SonJonsr/Custom-8bit-CPU/README.md

"# Custom-8bit-CPU" 
"# Custom-8bit-CPU"
