SonJonsr/Custom-8bit-CPU/Forstudie/forstudie.odt

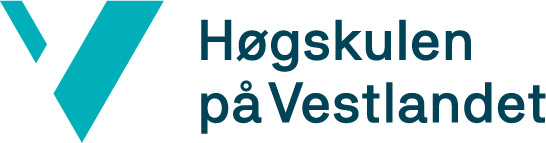
[picture p1: figure]
HVL_logo

Forstudie

<Gruppemedlem #1>

<Gruppemedlem #2>

30. jan.. 2026

# Dokumentkontroll

Rapportens tittel: Forprosjektrapport for ELNIKK-07, Selvlagd 8-Bit cpu med FPGA-lagd skjermkort og hovedkort | Dato/Versjon <Dato> / <Versjon>
| Rapportnummer: B021E-XX
Forfatter(e): <Forfatter navn 1> <Forfatter navn 2> | Studieretning: Elektronikk
| Antall sider m/vedlegg 17
Høgskolens veileder: Endre Håland | Gradering: <Åpen>
Eventuelle Merknader: Vi tillater at oppgaven kan publiseres.

Oppdragsgiver: Selvvalgt | Oppdragsgivers referanse: 42069
Oppdragsgivers kontaktperson(er) (inklusiv kontaktinformasjon): Sondre Johnsen og Jacob Kvasnes

Revisjon | Dato | Status | Utført av
0.1 | xx.yy.2026 | <Hva som er gjort i forhold til mal> | <Navn>
1.0 | xx.yy.2026 | <Vesentlig endring = nytt hovednummer> | <Navn>
1.1 | xx.yy.2026 | <Mindre endring = nytt undernummer> | <Navn>
1.2 | xx.yy.2026 | <Kort beskrivelse av hva som er endret> | <Navn>

# Innledning

## Organisering av rapporten

(om det føles nødvendig å ha med)

## Oppdragsgiver

Selvvalgt. Sondre ville lage en 8-bit CPU alene. Det han fikk han ikke lov til. Jacob syntes synd på Sondre, og nå er vi her. (Jacob ville fpga)

## Problemstilling

Hovedformål med oppgaven er å opparbeide erfaring rundt hvordan datamaskiner fungerer.

Forskning og utviklings oppgave. Designe en egen 8-bit cpu med tilhørende ekosystem slik at man kan lage en datamaskin

Vi ønsker å lage et produkt som kan hjelpe andre med å få forståelse for hvordan en datamaskin funker fra tastetrykk

Beskriv oppdragsgivers problemstilling og bakgrunnen for denne. Det er her også viktig å få med eventuelle utenforliggende faktorer som kan påvirke mulige løsningsforslag, samt eksisterende applikasjoner og nettverk som søkte løsningsforslag må forholde seg til.

Lag gjerne enkle skisser for å vise prosjektets plass i virksomheten det skal inn i. Ta ikke med teknisk omtale av detaljer i den ferdige løsningen her.

I designoppgaver kan dere gjerne tenke på resultatet som en ”svart boks”. Da må dere prøve å la leseren få et inntrykk hva som grovt sett skal sendes inn i boksen, hva som skal komme ut av boksen, og hvilke omgivelser denne boksen er plassert i. I oppgaver som retter seg mest mot nettverksplanlegging, nettverksoppbygging og analyse av driftssituasjoner, må dere kanskje skissere rom- og personellsituasjon, eventuelt eksisterende datanettverk e.l.

## Hovedidé for løsningsforslag

Hovedidé for oppgaven er å ha en fungerende 8-bit datamaskin med noen programmer.

### CPU

Lage en selvlagd 8-bit CPU med FPGA. Lage en fysisk verson av den selvlagde FPGA 8-bit CPU-en med transistorer.

### Hovedkort

Lage et hovedkort som kommuniserer med en skjerm, et tastatur, en minnemodulen og den selvlagde 8-bit CPU-en.

### Compilator

Lage en kompilator for kode som ligner på C:

### Programvare

Lage en terminal med et «Wozmon» lignende program.

Lage «Pong».

Lage «Snake».

Lage «Tetris».

# Kravspesifikasjon

## CPU

Cpu krav:

- 8-bit
- 16-bit addresse kart
- Eget definert instruksjonsett

Pin assignment

- 8-bit data -inn/-ut
- 16-bit add
- clk
- rst_n
- GND
- 5V

## Hovedkort

Alt som kobles til hovedkort som ikke er CPU-en skal løses med en FPGA.

### VGA-skjerm

- 480x640p oppløsning
- 60 Hz

### Tastatur

- Enten USB eller PS/2

### 64kiB Minnedel

- 2 leselinjer
- 2 skrivelinjer
- Støtte for en 50MHz klokke.

Lage et hovedkort som kommuniserer med en VGA-skjerm, et PS/2-tastatur, en 64kiB minnemodulen og den selvlagde 8-bit CPU-en.

## Compilator

Lage en kompilator for kode som ligner på C:

Stack og heap:

Stack blir løst med programnvare. Heap er ikke med.

Vaiabler

8-bit (char / int8_t)

16-bit (int16_t)

8-bit arrays

16-bit arrays

funksjoner:

Addisjon, subtraksjon, multiplikasjon, divisjon

metoder:

def

løkker:

for, while, foreach, dowhile

IO:

## Programvare

Lage en terminal med et «Wozmon» lignende program.

Lage «Pong».

Lage «Snake».

Lage «Tetris».

Dette er oppdragsgivers krav til hvordan løsningen skal fungere og hvordan den eventuelt skal integreres med øvrige applikasjoner i virksomheten. Kravspesifikasjonen må formuleres i oppdragsgivers språk (dvs. vanlig norsk uten for mange teknisk formuleringer som går direkte på løsningen) slik at oppdragsgiver og dennes brukere lett kan se at dere har oppfattet problemet. Det er viktig å ikke blande sammen kravspesifikasjonen med den tekniske dokumentasjonen som på en faglig presis måte beskriver hvordan det ferdige programsystemet, nettverket etc. er konstruert og skal fungere.

Kravspesifikasjonen skal drøftes med oppdragsgiver. Dette er et av hovedformålene med forprosjektet. I enkelte tilfeller kan det være nødvendig å dokumentere slike drøftinger og vurderinger i rapporten slik at en får fram oppdragsgivers motivasjon og begrunnelse. Hvis oppdragsgiver endrer kravspesifikasjonen underveis, bør dette komme fram i rapporten.

Kravspesifikasjonen skal ende opp med et klart definert mål for hva som skal utføres i løpet av hovedprosjektperioden. I samråd med oppdragsgiver og faglig kontaktperson ved høgskolen skal en sikre at kravspesifikasjonen definerer mål om endelige etterprøvbare løsninger (prototype med klare avgrensninger, ferdig testet applikasjon, integrasjon og tilpasning av eksisterende løsninger, etc.) som kan la seg løse innen rammene (arbeidsmengde, faglige utfordringer og tilgjengelige ressurser) for et hovedprosjekt. Med etterprøvbare løsninger menes det at en i ettertid skal kunne evaluere hvorvidt prosjektets resultat er i samsvar med kravspesifikasjonen.

Kravspesifikasjonen kan med fordel gis punktvis og gjerne kategorisert i en eller annen naturlig form.

# Analyse av problemet

Analysen binder sammen kravspesifikasjon og utforming.

Med utgangspunkt i kravspesifikasjonen skal en foreta en grundigere analyse for hva systemet skal utføre. En må gjerne dele opp systemet i undersystemer som hver får sine kravspesifikasjoner. Som oftest må en gå tilbake til oppdragsgiver og dennes kontaktpersoner for å få presisert detaljer i krav og ønsker, og for å finne ut av hvilke muligheter og egenskaper som ligger i de eksisterende systemløsninger.

Sagt på en annen måte så skal en under analysen foreta en dekomponering av kravene gitt i kravspesifikasjonen. Analysen skal ende opp i en detaljert og delvis generell beskrivelse av kravspesifikasjonen (med mindre oppdragsgiver har gitt spesifikke krav for bruk av verktøy og plattform). En god analyse vil gi et godt utgangspunkt for designfasen.

## Utforming av mulige løsninger

### CPU

Lage en selvlagd 8-bit CPU med FPGA. Lage en fysisk verson av den selvlagde FPGA 8-bit CPU-en med transistorer.

### Hovedkort

Lage et hovedkort som kommuniserer med en VGA-skjerm, et PS/2-tastatur, en 64kiB minnemodulen og den selvlagde 8-bit CPU-en.

### Compilator

Lage en kompilator for kode som ligner på C.

### Programvare

Lage en terminal med et «Wozmon» lignende program.

Lage «Pong».

Lage «Snake».

Lage «Tetris».

Her beskrives mulige utforminger av løsning(er) på problemet. Det kan f.eks. omfatte nødvendig kjøp og installasjon av maskinvare og programvare, utvikling av spesialtilpasset programvare, organisering av driften, brukeropplæring, dokumentasjon av system og arbeidsrutiner, etc. Dersom oppdragsgiver har lagt spesielle rammer for løsningen, presiseres dette.

Om mulig så bør en beskrive flere reelle løsningsalternativer:

### Løsningsalternativ 1

### Løsningsalternativ 2

### Vurderinger i forhold til verktøy og HW/SW komponenter

Her kan det skrives (kort) om aktuelle verktøy som dere har vurdert som aktuelle for oppgaven. Grunngi de endelige valgene av verktøy. Tidligere kunnskaper om og brukererfaring med verktøyet og beregnet tid for opplæring må også tas med i vurderingen. Dersom oppdragsgiver har gitt spesielle rammer for løsningen, så bør en her i stedet diskutere fortrinn og ulemper med de valg som er gjort vurdert opp mot andre verktøy/plattformer som kunne gitt tilsvarende gode eller eventuelt bedre løsninger.

Dersom en har flere reelle valgmuligheter for alt eller noe av verktøyet, kan en gjerne framstille alternativene med underpunkter som i kapitlet over.

## Konklusjon

Drøft valg av det beste løsningsalternativet og begrunnelser for dette.

# Referanser

Her tar dere med litteratur som er brukt under arbeidet. Det kan være lærebøker fra aktuelle fag på skolen, annen støttelitteratur, håndbøker for maskinutstyr eller programvarer, websteder dere har benyttet etc. Når det gjelder websider, så bør dette dateres. Litteraturlisten skal være ryddig og systematisk satt opp, og alle referanser skal også refereres til i teksten.

Eksempelet viser bruk av den interne litteraturlisten til Word, og det anbefales å benytte denne. Andre gode verktøy sammen med Word er f. eks. Endnote.

Tips til hvordan du setter opp litteraturliste finner du på [1]

[1] | HiB, UiB, NHH, UiO og Nasjonalbiblioteket, «Søk og Skriv,» 12 12 2014. [Internett]. Available: http://sokogskriv.no/. [Funnet 12 12 2014].

###### Forkortelser og ordforklaringer

Her skal relevante forkortelser og ordforklaringer komme i alfabetisk rekkefølge. Husk at forklaring på forkortelser tas med i dokumentet første gang en forkortelse brukes, eks: Orthogonal Frequency Division Multiplexing (OFDM).

OFDM | Orthogonal Frequency Division Multiplexing

###### Prosjektledelse og styring

Aktiviteter som har med prosjektgjennomføringen å gjøre passer kanskje ikke så godt å beskrive i de andre kapitlene. Det kan likevel være greit å si noe om hvordan prosjektet er gjennomført. Dette kan gjøres her.

###### Prosjektorganisasjon

Hvordan er arbeidet fordelt innad i gruppen? Hvem er prosjektleder?

###### Prosjektform

Hvis relevant, presenter den prosjektmetoden (UP, XP, Scrum, egendefinert, ...) som dere har valgt for prosjektet, og gi en kort begrunnelse for dette valget. Fortell også hvordan forprosjektet inngår i det hele.

###### Fremdriftsplan

Ta med den initielle fremdriftsplanen, og evt. også senere versjoner dersom det ble foretatt vesentlige endringer underveis. Alternativt kan initiell og endelig fremdriftsplan beskrives i felles diagram.

###### Risikoliste

Gjerne i tabellform (kort, konkret og oversiktlig).

###### Brukerdokumentasjon

Tas med dersom dette var et krav i prosjektet.

###### Brukerdokumentasjon

Hva systemet kan gjøre beskrives på en kort og enkel måte. For hver funksjon vises bruksmåte, eventuelle begrensninger og krav til inndata, etc. Der det er aktuelt viser dere til hjelpefunksjoner som ligger innebygd i systemet.

###### Drifts- og vedlikeholdsdokumentasjon

Beskriv hvordan systemet installeres og startes opp, nødvendige datafiler og andre systemkomponenter som kreves i en driftssituasjon, krav til maskinutstyr, nettverk, m.m.

###### Øvrige diagrammer

Dersom det ikke er naturlig at disse inngår i hoveddelen av rapporten.

###### Kildekode, skjemadesign, Bill Of Materials mm

Normalt holder det at denne informasjonen legges ved i zip-filen, men i spesielle tilfeller kan det være ønskelig at hele eller deler av arbeidet (dersom dette ikke blir så alt for mange sider) legges ved i utskrifts form. Diskuter dette med veileder.

Rediger overskriften alt etter som hva som er relevant å ta med her.

###### Annet?

ELNIKK-07, Selvlagd 8-Bit cpu med FPGA-lagd skjermkort og hovedkort

Rev: 0.16 side 7 av 17 15.01.2026
