SonJonsr/Custom-8bit-CPU/FPGA_ROT/PS2_testbenk/ps2_code_overview.png

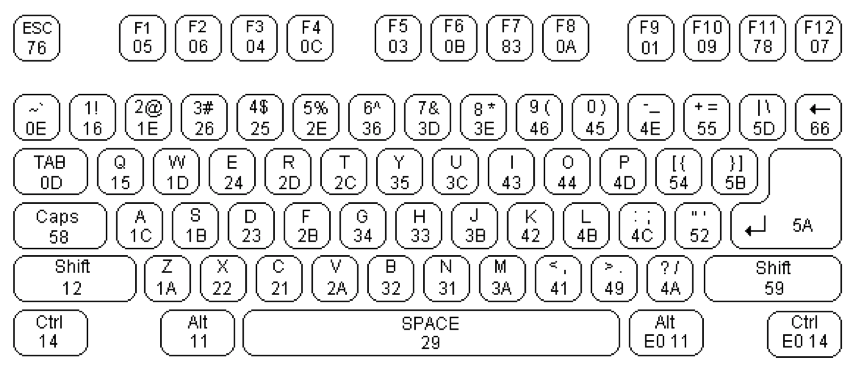
FPGA_ROT/PS2_testbenk/ps2_code_overview.png
