SonJonsr/Custom-8bit-CPU/PCB_S/REG8bit-SMD-V5.0/jlcpcb/production_files/BOM-REG8bit-SMD-V5.0.csv

Comment | Designator | Footprint | LCSC | Quantity
10kΩ | R1,R10,R11,R12,R13,R14,R15,R16,R17,R18,R19,R2,R20,R21,R22,R23,R24,R25,R26,R27,R28,R29,R3,R30,R31,R32,R33,R34,R35,R36,R37,R38,R39,R4,R40,R41,R42,R43,R44,R45,R46,R5,R6,R7,R8,R9 | R_0402 | C25744 | 46
22uF | C1,C2,C3,C4 | C_0805 | C45783 | 4
2N7002 | Q1,Q10,Q11,Q12,Q13,Q14,Q15,Q16,Q17,Q19,Q2,Q20,Q21,Q22,Q23,Q24,Q25,Q27,Q29,Q3,Q30,Q31,Q32,Q33,Q34,Q35,Q37,Q39,Q4,Q40,Q41,Q42,Q43,Q44,Q45,Q47,Q49,Q5,Q50,Q51,Q52,Q53,Q54,Q55,Q57,Q59,Q6,Q60,Q61,Q62,Q63,Q64,Q65,Q67,Q69,Q7,Q70,Q71,Q72,Q73,Q74,Q75,Q77,Q79,Q8,Q80,Q81,Q82,Q83,Q84,Q85,Q86,Q87,Q88,Q89,Q9 | SOT-23 | C8545 | 76
Red | D1,D10,D2,D3,D4,D5,D6,D7,D8,D9 | D_0603 | C2286 | 10
Conn_01x21_Pin | J1 | PinHeader_1x21_P2.54mm_Horizontal |  | 1
