SonJonsr/Custom-8bit-CPU/(list of files, cad)

Other CAD files:
Compile/test.obj
CPU_Bachelor_2_0/db/stp1_auto_stripped.stp
CPU_Bachelor_2_0/stp1.stp
CPU_Bachlor_1_0/db/stp1_auto_stripped.stp
FPGA_ROT/motherboard_ver_1/db/stp1_auto_stripped.stp
FPGA_ROT/motherboard_ver_1/output_files/stp1.stp
FPGA_ROT/vga_test_av_testbrett/db/stp1_auto_stripped.stp
FPGA_ROT/vga_test_av_testbrett/output_files/stp1.stp
Compile/Simple_C_output.obj
