SonJonsr/Custom-8bit-CPU/FPGA_ROT/register_testbenk_mcu/unsaved/unsaved.html

unsaved

2026.03.19.18:14:07 | Datasheet

Overview

clk_0 | unsaved

Processor
thinker Abbotts Lake 26.0.0
All Components
jtag altera_avalon_jtag_uart 24.1
ram altera_avalon_onchip_memory2 24.1
reg_test_comp register_testbenk_component 1.0
thinker intel_niosv_m 26.0.0

Memory Map

| jtag

avalon_jtag_slave

ram

s1

reg_test_comp

avalon_slave_0

thinker

timer_sw_agent

dm_agent

## clk_0

clock_source v24.1

Parameters

clockFrequency | 50000000
clockFrequencyKnown | true
inputClockFrequency | 0
resetSynchronousEdges | NONE
deviceFamily | UNKNOWN
generateLegacySim | false

Software Assignments
(none)

## jtag

altera_avalon_jtag_uart v24.1

thinker | data_manager | jtag
| avalon_jtag_slave
| instruction_manager
| avalon_jtag_slave
| platform_irq_rx
| irq
clk_0 | clk
| clk
| clk_reset
| reset

Parameters

allowMultipleConnections | false
hubInstanceID | 0
readBufferDepth | 64
readIRQThreshold | 8
simInputCharacterStream
simInteractiveOptions | NO_INTERACTIVE_WINDOWS
useRegistersForReadBuffer | false
useRegistersForWriteBuffer | false
useRelativePathForSimFile | false
writeBufferDepth | 64
writeIRQThreshold | 8
printingMethod | false
FIFO_WIDTH | 8
WR_WIDTHU | 6
RD_WIDTHU | 6
write_le | ON
read_le | ON
HEX_WRITE_DEPTH_STR | 64
HEX_READ_DEPTH_STR | 64
clkFreq | 50000000
avalonSpec | 2.0
legacySignalAllow | false
enableInteractiveInput | false
enableInteractiveOutput | false
deviceFamily | UNKNOWN
generateLegacySim | false

Software Assignments

READ_DEPTH | 64
READ_THRESHOLD | 8
WRITE_DEPTH | 64
WRITE_THRESHOLD | 8

## ram

altera_avalon_onchip_memory2 v24.1

thinker | data_manager | ram
| s1
| instruction_manager
| s1
clk_0 | clk
| clk1
| clk_reset
| reset1

Parameters

allowInSystemMemoryContentEditor | false
blockType | AUTO
dataWidth | 32
dataWidth2 | 32
dualPort | false
enableDiffWidth | false
derived_enableDiffWidth | false
initMemContent | true
initializationFileName | onchip_mem.hex
enPRInitMode | false
instanceID | NONE
memorySize | 262144
readDuringWriteMode | DONT_CARE
simAllowMRAMContentsFile | false
simMemInitOnlyFilename | 0
singleClockOperation | false
derived_singleClockOperation | false
slave1Latency | 1
slave2Latency | 1
useNonDefaultInitFile | false
copyInitFile | false
useShallowMemBlocks | false
writable | true
ecc_enabled | false
resetrequest_enabled | true
autoInitializationFileName | unsaved_ram
deviceFamily | CYCLONEIVE

deviceFeatures

COMPILER_SUPPORT 1 CELL_LEVEL_BACK_ANNOTATION_DISABLED 0 ANY_QFP 0 ADDRESS_STALL 1 ADVANCED_INFO 0 ALLOWS_COMPILING_OTHER_FAMILY_IP 1 GENERATE_DC_ON_CURRENT_WARNING_FOR_INTERNAL_CLAMPING_DIODE 0 DSP 0 DSP_SHIFTER_BLOCK 0 DUMP_ASM_LAB_BITS_FOR_POWER 1 EMUL 1 ENABLE_ADVANCED_IO_ANALYSIS_GUI_FEATURES 1 ENABLE_PIN_PLANNER 0 ENGINEERING_SAMPLE 0 EPCS 1 ESB 0 FAKE1 0 FAKE2 0 FAKE3 0 FAMILY_LEVEL_INSTALLATION_ONLY 1 FASTEST 0 FINAL_TIMING_MODEL 0 FITTER_USE_FALLING_EDGE_DELAY 0 FPP_COMPLETELY_PLACES_AND_ROUTES_PERIPHERY 0 HARDCOPY 0 HAS_MICROPROCESSOR 0 HAS_MIF_SMART_COMPILE_SUPPORT 1 HAS_MINMAX_TIMING_MODELING_SUPPORT 1 HAS_MIN_TIMING_ANALYSIS_SUPPORT 1 HAS_MUX_RESTRUCTURE_SUPPORT 1 HAS_NADDER_STYLE_CLOCKING 0 HAS_NADDER_STYLE_FF 0 HAS_NADDER_STYLE_LCELL_COMB 0 HAS_NEW_CDB_NAME_FOR_M20K_SCLR 0 HAS_NEW_HC_FLOW_SUPPORT 0 HAS_NEW_SERDES_MAX_RESOURCE_COUNT_REPORTING_SUPPORT 1 HAS_NEW_VPR_SUPPORT 1 HAS_NONSOCKET_TECHNOLOGY_MIGRATION_SUPPORT 0 HAS_NO_HARDBLOCK_PARTITION_SUPPORT 0 HAS_NO_JTAG_USERCODE_SUPPORT 0 HAS_OPERATING_SETTINGS_AND_CONDITIONS_REPORTING_SUPPORT 1 HAS_ACE_SUPPORT 1 HAS_ACTIVE_PARALLEL_FLASH_SUPPORT 0 HAS_ADJUSTABLE_OUTPUT_IO_TIMING_MEAS_POINT 0 HAS_ADVANCED_IO_INVERTED_CORNER 0 HAS_ADVANCED_IO_POWER_SUPPORT 1 HAS_ADVANCED_IO_TIMING_SUPPORT 1 HAS_ALM_SUPPORT 0 HAS_ATOM_AND_ROUTING_POWER_MODELED_TOGETHER 0 HAS_AUTO_DERIVE_CLOCK_UNCERTAINTY_SUPPORT 0 HAS_AUTO_FIT_SUPPORT 1 HAS_BALANCED_OPT_TECHNIQUE_SUPPORT 1 HAS_BENEFICIAL_SKEW_SUPPORT 1 HAS_BITLEVEL_DRIVE_STRENGTH_CONTROL 1 HAS_BSDL_FILE_GENERATION 1 HAS_CDB_RE_NETWORK_PRESERVATION_SUPPORT 0 HAS_CGA_SUPPORT 1 HAS_CHECK_NETLIST_SUPPORT 0 HAS_CLOCK_REGION_CHECKER_ENABLED 1 HAS_CORE_JUNCTION_TEMP_DERATING 0 HAS_CROSSTALK_SUPPORT 0 HAS_CUSTOM_REGION_SUPPORT 1 HAS_DAP_JTAG_FROM_HPS 0 HAS_DATA_DRIVEN_ACVQ_HSSI_SUPPORT 0 HAS_DDB_FDI_SUPPORT 0 HAS_DESIGN_ANALYZER_SUPPORT 1 HAS_DETAILED_IO_RAIL_POWER_MODEL 1 HAS_DETAILED_LEIM_STATIC_POWER_MODEL 1 HAS_DETAILED_LE_POWER_MODEL 1 HAS_DETAILED_ROUTING_MUX_STATIC_POWER_MODEL 1 HAS_DETAILED_THERMAL_CIRCUIT_PARAMETER_SUPPORT 1 HAS_DEVICE_MIGRATION_SUPPORT 1 HAS_DIAGONAL_MIGRATION_SUPPORT 0 HAS_EMIF_TOOLKIT_SUPPORT 0 HAS_ERROR_DETECTION_SUPPORT 0 HAS_FAMILY_VARIANT_MIGRATION_SUPPORT 0 HAS_FANOUT_FREE_NODE_SUPPORT 1 HAS_FAST_FIT_SUPPORT 1 HAS_FIT_NETLIST_OPT_RETIME_SUPPORT 1 HAS_FIT_NETLIST_OPT_SUPPORT 1 HAS_FITTER_ECO_SUPPORT 1 HAS_FORMAL_VERIFICATION_SUPPORT 1 HAS_FPGA_XCHANGE_SUPPORT 1 HAS_FSAC_LUTRAM_REGISTER_PACKING_SUPPORT 0 HAS_FULL_DAT_MIN_TIMING_SUPPORT 1 HAS_FULL_INCREMENTAL_DESIGN_SUPPORT 1 HAS_FUNCTIONAL_SIMULATION_SUPPORT 1 HAS_FUNCTIONAL_VERILOG_SIMULATION_SUPPORT 0 HAS_FUNCTIONAL_VHDL_SIMULATION_SUPPORT 0 HAS_GLITCH_FILTERING_SUPPORT 1 HAS_HARDCOPYII_SUPPORT 0 HAS_HC_READY_SUPPORT 0 HAS_HIGH_SPEED_LOW_POWER_TILE_SUPPORT 0 HAS_HOLD_TIME_AVOIDANCE_ACROSS_CLOCK_SPINE_SUPPORT 1 HAS_HSSI_POWER_CALCULATOR 0 HAS_HSPICE_WRITER_SUPPORT 1 HAS_IBISO_WRITER_SUPPORT 0 HAS_ICD_DATA_IP 0 HAS_IDB_SUPPORT 1 HAS_INCREMENTAL_DAT_SUPPORT 1 HAS_INCREMENTAL_SYNTHESIS_SUPPORT 1 HAS_IO_ASSIGNMENT_ANALYSIS_SUPPORT 1 HAS_IO_DECODER 0 HAS_IO_PLACEMENT_OPTIMIZATION_SUPPORT 1 HAS_IO_PLACEMENT_USING_GEOMETRY_RULE 0 HAS_IO_PLACEMENT_USING_PHYSIC_RULE 0 HAS_IO_SMART_RECOMPILE_SUPPORT 0 HAS_JITTER_SUPPORT 1 HAS_JTAG_SLD_HUB_SUPPORT 1 HAS_LOGIC_LOCK_SUPPORT 1 HAS_PAD_LOCATION_ASSIGNMENT_SUPPORT 0 HAS_PASSIVE_PARALLEL_SUPPORT 0 HAS_PARTIAL_RECONFIG_SUPPORT 0 HAS_PDN_MODEL_STATUS 0 HAS_PHYSICAL_NETLIST_OUTPUT 0 HAS_PHYSICAL_DESIGN_PLANNER_SUPPORT 0 HAS_PHYSICAL_ROUTING_SUPPORT 0 HAS_PIN_SPECIFIC_VOLTAGE_SUPPORT 1 HAS_PLDM_REF_SUPPORT 1 HAS_POWER_BINNING_LIMITS_DATA 0 HAS_POWER_ESTIMATION_SUPPORT 1 HAS_PRELIMINARY_CLOCK_UNCERTAINTY_NUMBERS 0 HAS_PRE_FITTER_FPP_SUPPORT 0 HAS_PRE_FITTER_LUTRAM_NETLIST_CHECKER_ENABLED 0 HAS_PVA_SUPPORT 1 HAS_QUARTUS_HIERARCHICAL_DESIGN_SUPPORT 0 HAS_RAPID_RECOMPILE_SUPPORT 0 HAS_RCF_SUPPORT 1 HAS_RCF_SUPPORT_FOR_DEBUGGING 0 HAS_RED_BLACK_SEPARATION_SUPPORT 0 HAS_RE_LEVEL_TIMING_GRAPH_SUPPORT 1 HAS_RISEFALL_DELAY_SUPPORT 1 HAS_SIGNAL_PROBE_SUPPORT 1 HAS_SIGNAL_TAP_SUPPORT 1 HAS_SIMULATOR_SUPPORT 0 HAS_SPLIT_IO_SUPPORT 1 HAS_SPLIT_LC_SUPPORT 1 HAS_STRICT_PRESERVATION_SUPPORT 1 HAS_SYNTHESIS_ON_ATOMS 0 HAS_SYNTH_NETLIST_OPT_RETIME_SUPPORT 1 HAS_SYNTH_NETLIST_OPT_SUPPORT 1 HAS_SYNTH_FSYN_NETLIST_OPT_SUPPORT 1 HAS_TCL_FITTER_SUPPORT 0 HAS_TECHNOLOGY_MIGRATION_SUPPORT 0 HAS_TEMPLATED_REGISTER_PACKING_SUPPORT 1 HAS_TIME_BORROWING_SUPPORT 0 HAS_TIMING_DRIVEN_SYNTHESIS_SUPPORT 1 HAS_TIMING_INFO_SUPPORT 1 HAS_TIMING_OPERATING_CONDITIONS 1 HAS_TIMING_SIMULATION_SUPPORT 1 HAS_TITAN_BASED_MAC_REGISTER_PACKER_SUPPORT 0 HAS_U2B2_SUPPORT 0 HAS_USE_FITTER_INFO_SUPPORT 1 HAS_USER_HIGH_SPEED_LOW_POWER_TILE_SUPPORT 0 HAS_VCCPD_POWER_RAIL 0 HAS_VERTICAL_MIGRATION_SUPPORT 1 HAS_VIEWDRAW_SYMBOL_SUPPORT 0 HAS_VIO_SUPPORT 1 HAS_VIRTUAL_DEVICES 0 HAS_WYSIWYG_DFFEAS_SUPPORT 1 HAS_XIBISO_WRITER_SUPPORT 1 HAS_XIBISO2_WRITER_SUPPORT 0 HAS_18_BIT_MULTS 0 INCREMENTAL_DESIGN_SUPPORTS_COMPATIBLE_CONSTRAINTS 1 INSTALLED 0 INTERNAL_POF_SUPPORT_ENABLED 0 INTERNAL_USE_ONLY 0 IFP_USE_LEGACY_IO_CHECKER 0 ISSUE_MILITARY_TEMPERATURE_WARNING 0 IS_CONFIG_ROM 0 IS_BARE_DIE 0 IS_DEFAULT_FAMILY 0 IS_FOR_INTERNAL_TESTING_ONLY 0 IS_HARDCOPY_FAMILY 0 IS_HBGA_PACKAGE 0 IS_HIGH_CURRENT_PART 0 IS_JW_NEW_BINNING_PLAN 0 IS_JZ_NEW_BINNING_PLAN 0 IS_LOW_POWER_PART 0 IS_LTH_485_PIN 0 IS_SMI_PART 0 IS_SDM_ONLY_PACKAGE 0 IS_REVE_SILICON 0 LOAD_BLK_TYPE_DATA_FROM_ATOM_WYS_INFO 0 LVDS_IO 1 M144K_MEMORY 0 M10K_MEMORY 0 M20K_MEMORY 0 M4K_MEMORY 0 M512_MEMORY 0 M9K_MEMORY 1 MLAB_MEMORY 0 MRAM_MEMORY 0 NOT_MIGRATABLE 0 NOT_LISTED 0 NO_FITTER_DELAY_CACHE_GENERATED 0 NO_SUPPORT_FOR_LOGICLOCK_CONTENT_BACK_ANNOTATION 1 NO_SUPPORT_FOR_STA_CLOCK_UNCERTAINTY_CHECK 0 NO_POF 0 NO_PIN_OUT 0 NO_RPE_SUPPORT 0 NO_TDC_SUPPORT 0 SHOW_HIDDEN_FAMILY_IN_PROGRAMMER 0 STRICT_TIMING_DB_CHECKS 0 SUPPORT_HIGH_SPEED_HPS 0 SUPPORTS_1P0V_IOSTD 0 SUPPORTS_CRC 1 SUPPORTS_ADDITIONAL_OPTIONS_FOR_UNUSED_IO 0 SUPPORTS_GENERATION_OF_EARLY_POWER_ESTIMATOR_FILE 1 SUPPORTS_GLOBAL_SIGNAL_BACK_ANNOTATION 0 SUPPORTS_DIFFERENTIAL_AIOT_BOARD_TRACE_MODEL 1 SUPPORTS_DSP_BALANCING_BACK_ANNOTATION 0 SUPPORTS_HIPI_RETIMING 0 SUPPORTS_LICENSE_FREE_PARTIAL_RECONFIG 0 SUPPORTS_MAC_CHAIN_OUT_ADDER 0 SUPPORTS_NEW_BINNING_PLAN 0 SUPPORTS_SIGNALPROBE_REGISTER_PIPELINING 1 SUPPORTS_SINGLE_ENDED_AIOT_BOARD_TRACE_MODEL 1 SUPPORTS_RAM_PACKING_BACK_ANNOTATION 0 SUPPORTS_REG_PACKING_BACK_ANNOTATION 0 SUPPORTS_USER_MANUAL_LOGIC_DUPLICATION 1 SUPPORTS_VID 0 POSTMAP_BAK_DATABASE_EXPORT_ENABLED 1 POSTFIT_BAK_DATABASE_EXPORT_ENABLED 1 PROGRAMMER_ONLY 0 PROGRAMMER_SUPPORT 1 PVA_SUPPORTS_ONLY_SUBSET_OF_ATOMS 0 QMAP_IN_DEVELOPMENT 0 QFIT_IN_DEVELOPMENT 0 RAM_LOGICAL_NAME_CHECKING_IN_CUT_ENABLED 1 REPORTS_METASTABILITY_MTBF 1 REQUIRE_QUARTUS_HIERARCHICAL_DESIGN 0 REQUIRE_SPECIAL_HANDLING_FOR_LOCAL_LABLINE 1 REQUIRES_INSTALLATION_PATCH 0 REQUIRES_LIST_OF_TEMPERATURE_AND_VOLTAGE_OPERATING_CONDITIONS 1 RESERVES_SIGNAL_PROBE_PINS 0 RESOLVE_MAX_FANOUT_EARLY 1 RESOLVE_MAX_FANOUT_LATE 0 RESPECTS_FIXED_SIZED_LOCKED_LOCATION_LOGICLOCK 1 RESTRICTED_USER_SELECTION 0 RESTRICT_PARTIAL_RECONFIG 0 RISEFALL_SUPPORT_IS_HIDDEN 0 WYSIWYG_BUS_WIDTH_CHECKING_IN_CUT_ENABLED 1 TMV_RUN_CUSTOMIZABLE_VIEWER 1 TMV_RUN_INTERNAL_DETAILS 1 TMV_RUN_INTERNAL_DETAILS_ON_IO 0 TMV_RUN_INTERNAL_DETAILS_ON_IOBUF 1 TMV_RUN_INTERNAL_DETAILS_ON_LCELL 0 TMV_RUN_INTERNAL_DETAILS_ON_LRAM 0 TRANSCEIVER_3G_BLOCK 0 TRANSCEIVER_6G_BLOCK 0 USES_ACV_FOR_FLED 1 USES_ADB_FOR_BACK_ANNOTATION 1 USES_ALTERA_LNSIM 0 USES_ASIC_ROUTING_POWER_CALCULATOR 0 USES_DATA_DRIVEN_PLL_COMPUTATION_UTIL 1 USES_DEV 1 USES_ICP_FOR_ECO_FITTER 0 USES_LIBERTY_TIMING 0 USES_NETWORK_ROUTING_POWER_CALCULATOR 0 USES_PART_INFO_FOR_DISPLAYING_CORE_VOLTAGE_VALUE 0 USES_POWER_SIGNAL_ACTIVITIES 1 USES_PVAFAM2 0 USES_SECOND_GENERATION_PART_INFO 0 USES_SECOND_GENERATION_POWER_ANALYZER 0 USES_THIRD_GENERATION_TIMING_MODELS_TIS 1 USES_U2B2_TIMING_MODELS 0 USES_XML_FORMAT_FOR_EMIF_PIN_MAP_FILE 0 USE_OCT_AUTO_CALIBRATION 1 USE_ADVANCED_IO_POWER_BY_DEFAULT 1 USE_ADVANCED_IO_TIMING_BY_DEFAULT 1 USE_BASE_FAMILY_DDB_PATH 0 USE_RELAX_IO_ASSIGNMENT_RULES 0 USE_RISEFALL_ONLY 1 USE_SEPARATE_LIST_FOR_TECH_MIGRATION 0 USE_SINGLE_COMPILER_PASS_PLL_MIF_FILE_WRITER 1 USE_TITAN_IO_BASED_IO_REGISTER_PACKER_UTIL 0 USING_28NM_OR_OLDER_TIMING_METHODOLOGY 1
derived_set_addr_width | 16
derived_set_addr_width2 | 16
derived_set_data_width | 32
derived_set_data_width2 | 32
derived_gui_ram_block_type | Automatic
derived_is_hardcopy | false
derived_init_file_name | unsaved_ram.hex
generateLegacySim | false

Software Assignments

ALLOW_IN_SYSTEM_MEMORY_CONTENT_EDITOR | 0
ALLOW_MRAM_SIM_CONTENTS_ONLY_FILE | 0
CONTENTS_INFO | ""
DUAL_PORT | 0
GUI_RAM_BLOCK_TYPE | AUTO
INIT_CONTENTS_FILE | unsaved_ram
INIT_MEM_CONTENT | 1
INSTANCE_ID | NONE
NON_DEFAULT_INIT_FILE_ENABLED | 0
RAM_BLOCK_TYPE | AUTO
READ_DURING_WRITE_MODE | DONT_CARE
SINGLE_CLOCK_OP | 0
SIZE_MULTIPLE | 1
SIZE_VALUE | 262144
WRITABLE | 1

## reg_test_comp

register_testbenk_component v1.0

thinker | data_manager | reg_test_comp
| avalon_slave_0
| instruction_manager
| avalon_slave_0
clk_0 | clk
| clock
| clk_reset
| reset_n

Parameters

deviceFamily | UNKNOWN
generateLegacySim | false

Software Assignments
(none)

## thinker

intel_niosv_m v26.0.0

clk_0 | clk | thinker
| clk
| clk_reset
| reset
| | | data_manager | jtag
| | | avalon_jtag_slave
| | | instruction_manager
| | | avalon_jtag_slave
| | | platform_irq_rx
| | | irq
| | | data_manager | reg_test_comp
| | | avalon_slave_0
| | | instruction_manager
| | | avalon_slave_0
| | | data_manager | ram
| | | s1
| | | instruction_manager
| | | s1

Parameters

clockFrequency | 50000000
instSlaveMapParam | <address-map><slave name='ram.s1' start='0x0' end='0x40000' type='altera_avalon_onchip_memory2.s1' /><slave name='thinker.dm_agent' start='0x40000' end='0x50000' type='intel_niosv_m.dm_agent' /><slave name='jtag.avalon_jtag_slave' start='0x50000' end='0x50008' type='altera_avalon_jtag_uart.avalon_jtag_slave' /><slave name='reg_test_comp.avalon_slave_0' start='0x50008' end='0x5000C' type='register_testbenk_component.avalon_slave_0' /></address-map>
dataSlaveMapParam | <address-map><slave name='ram.s1' start='0x0' end='0x40000' type='altera_avalon_onchip_memory2.s1' /><slave name='thinker.dm_agent' start='0x40000' end='0x50000' type='intel_niosv_m.dm_agent' /><slave name='jtag.avalon_jtag_slave' start='0x50000' end='0x50008' type='altera_avalon_jtag_uart.avalon_jtag_slave' /><slave name='reg_test_comp.avalon_slave_0' start='0x50008' end='0x5000C' type='register_testbenk_component.avalon_slave_0' /><slave name='thinker.timer_sw_agent' start='0x50040' end='0x50080' type='intel_niosv_m.timer_sw_agent' /></address-map>
enableDebug | true
enableDebugReset | false
useResetReq | false
numGpr | 32
resetSlave | Absolute
resetOffset | 0
interruptMode | 0
deviceFamily | CYCLONEIVE
pipelineArch | true
enableAvalonInterface | false
hartId | 0
enableECCLite | false
AUTO_DEVICE | EP4CE115F29C7
AUTO_DEVICE_SPEEDGRADE | 7
AUTO_CLK_CLOCK_DOMAIN | 1
AUTO_CLK_RESET_DOMAIN | 1
AUTO_PLATFORM_IRQ_RX_INTERRUPTS_USED | 1
generateLegacySim | false

Software Assignments

CPU_FREQ | 50000000u
DATA_ADDR_WIDTH | 32
DCACHE_LINE_SIZE | 0
DCACHE_LINE_SIZE_LOG2 | 0
DCACHE_SIZE | 0
HAS_CSR_SUPPORT | 1
HAS_DEBUG_STUB
ICACHE_LINE_SIZE | 0
ICACHE_LINE_SIZE_LOG2 | 0
ICACHE_SIZE | 0
INST_ADDR_WIDTH | 32
INT_MODE | 0
MTIME_OFFSET | 0x00050040
NIOSV_CORE_VARIANT | 1
NUM_GPR | 32
RESET_ADDR | 0x00000000
TICKS_PER_SEC | no_quote(NIOSV_INTERNAL_TIMER_TICKS_PER_SECOND)
TIMER_DEVICE_TYPE | 2

generation took 0.00 seconds | rendering took 0.01 seconds
