SonJonsr/Custom-8bit-CPU/testing/Nye/scope_23.csv

x-axis | 1 | 2 | 3 | 4
second | Volt | Volt | Volt | Volt
-4.00000E-06 | +0.0E+00 | -130.40200993E-03 | +4.92412055284E+00 | -80.40200919E-03
-3.99000E-06 | -80.40200919E-03 | -130.40200993E-03 | +4.92412055284E+00 | -160.80401838E-03
-3.98000E-06 | +0.0E+00 | -50.00000075E-03 | +5.00452256203E+00 | -80.40200919E-03
-3.97000E-06 | +0.0E+00 | -50.00000075E-03 | +4.92412055284E+00 | -80.40200919E-03
-3.96000E-06 | +0.0E+00 | -50.00000075E-03 | +5.00452256203E+00 | -80.40200919E-03
-3.95000E-06 | +0.0E+00 | -130.40200993E-03 | +5.00452256203E+00 | -160.80401838E-03
-3.94000E-06 | +0.0E+00 | -50.00000075E-03 | +4.92412055284E+00 | -160.80401838E-03
-3.93000E-06 | +0.0E+00 | -50.00000075E-03 | +5.00452256203E+00 | -80.40200919E-03
-3.92000E-06 | +0.0E+00 | -130.40200993E-03 | +4.92412055284E+00 | -80.40200919E-03
-3.91000E-06 | +0.0E+00 | -50.00000075E-03 | +5.00452256203E+00 | -160.80401838E-03
-3.90000E-06 | +0.0E+00 | -50.00000075E-03 | +5.00452256203E+00 | -80.40200919E-03
-3.89000E-06 | +0.0E+00 | -50.00000075E-03 | +5.00452256203E+00 | -80.40200919E-03
-3.88000E-06 | +0.0E+00 | -50.00000075E-03 | +4.92412055284E+00 | -80.40200919E-03
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
