SonJonsr/Custom-8bit-CPU/testing/Nye/scope_24.csv

x-axis | 1 | 2 | 3 | 4
second | Volt | Volt | Volt | Volt
-4.00000E-06 | +0.0E+00 | -50.00000075E-03 | -141.20602608E-03 | +4.98492456973E+00
-3.99000E-06 | +0.0E+00 | -50.00000075E-03 | -141.20602608E-03 | +4.98492456973E+00
-3.98000E-06 | +0.0E+00 | -50.00000075E-03 | -141.20602608E-03 | +4.98492456973E+00
-3.97000E-06 | +0.0E+00 | -50.00000075E-03 | -141.20602608E-03 | +4.98492456973E+00
-3.96000E-06 | +0.0E+00 | -50.00000075E-03 | -141.20602608E-03 | +4.98492456973E+00
-3.95000E-06 | +0.0E+00 | -130.40200993E-03 | -60.80401689E-03 | +4.98492456973E+00
-3.94000E-06 | +0.0E+00 | -50.00000075E-03 | -141.20602608E-03 | +4.98492456973E+00
-3.93000E-06 | +0.0E+00 | -130.40200993E-03 | -60.80401689E-03 | +4.98492456973E+00
-3.92000E-06 | +0.0E+00 | -130.40200993E-03 | -141.20602608E-03 | +4.98492456973E+00
-3.91000E-06 | +0.0E+00 | -50.00000075E-03 | -141.20602608E-03 | +4.98492456973E+00
-3.90000E-06 | +0.0E+00 | -50.00000075E-03 | -141.20602608E-03 | +4.98492456973E+00
-3.89000E-06 | +0.0E+00 | -50.00000075E-03 | -60.80401689E-03 | +4.98492456973E+00
-3.88000E-06 | +0.0E+00 | -50.00000075E-03 | -60.80401689E-03 | +4.98492456973E+00
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
