SonJonsr/Custom-8bit-CPU/testing/scope_0.png

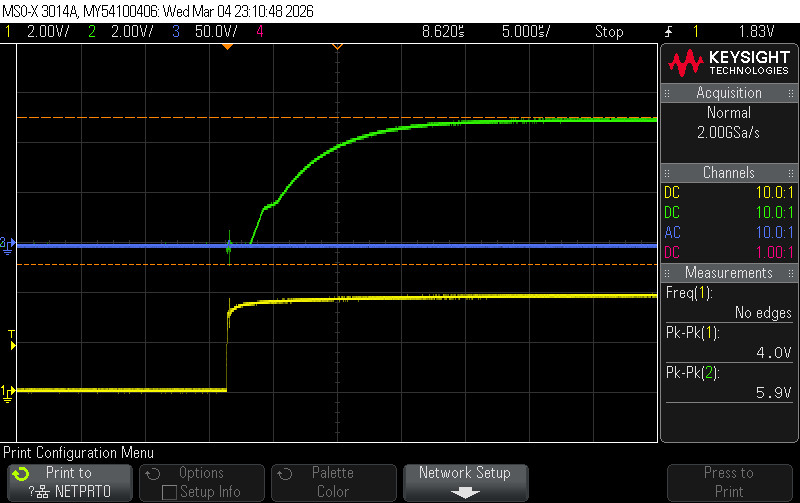
testing/scope_0.png
