SonJonsr/Custom-8bit-CPU/PCB_S/Level_shifter_FPGA_V1.0/Level_shifter_FPGA_V1.0/Level_shifter_FPGA_V1.0.kicad_pcb

## KiCad design PCB_S/Level_shifter_FPGA_V1.0/Level_shifter_FPGA_V1.0/Level_shifter_FPGA_V1.0.kicad_pcb (2026-03-30)

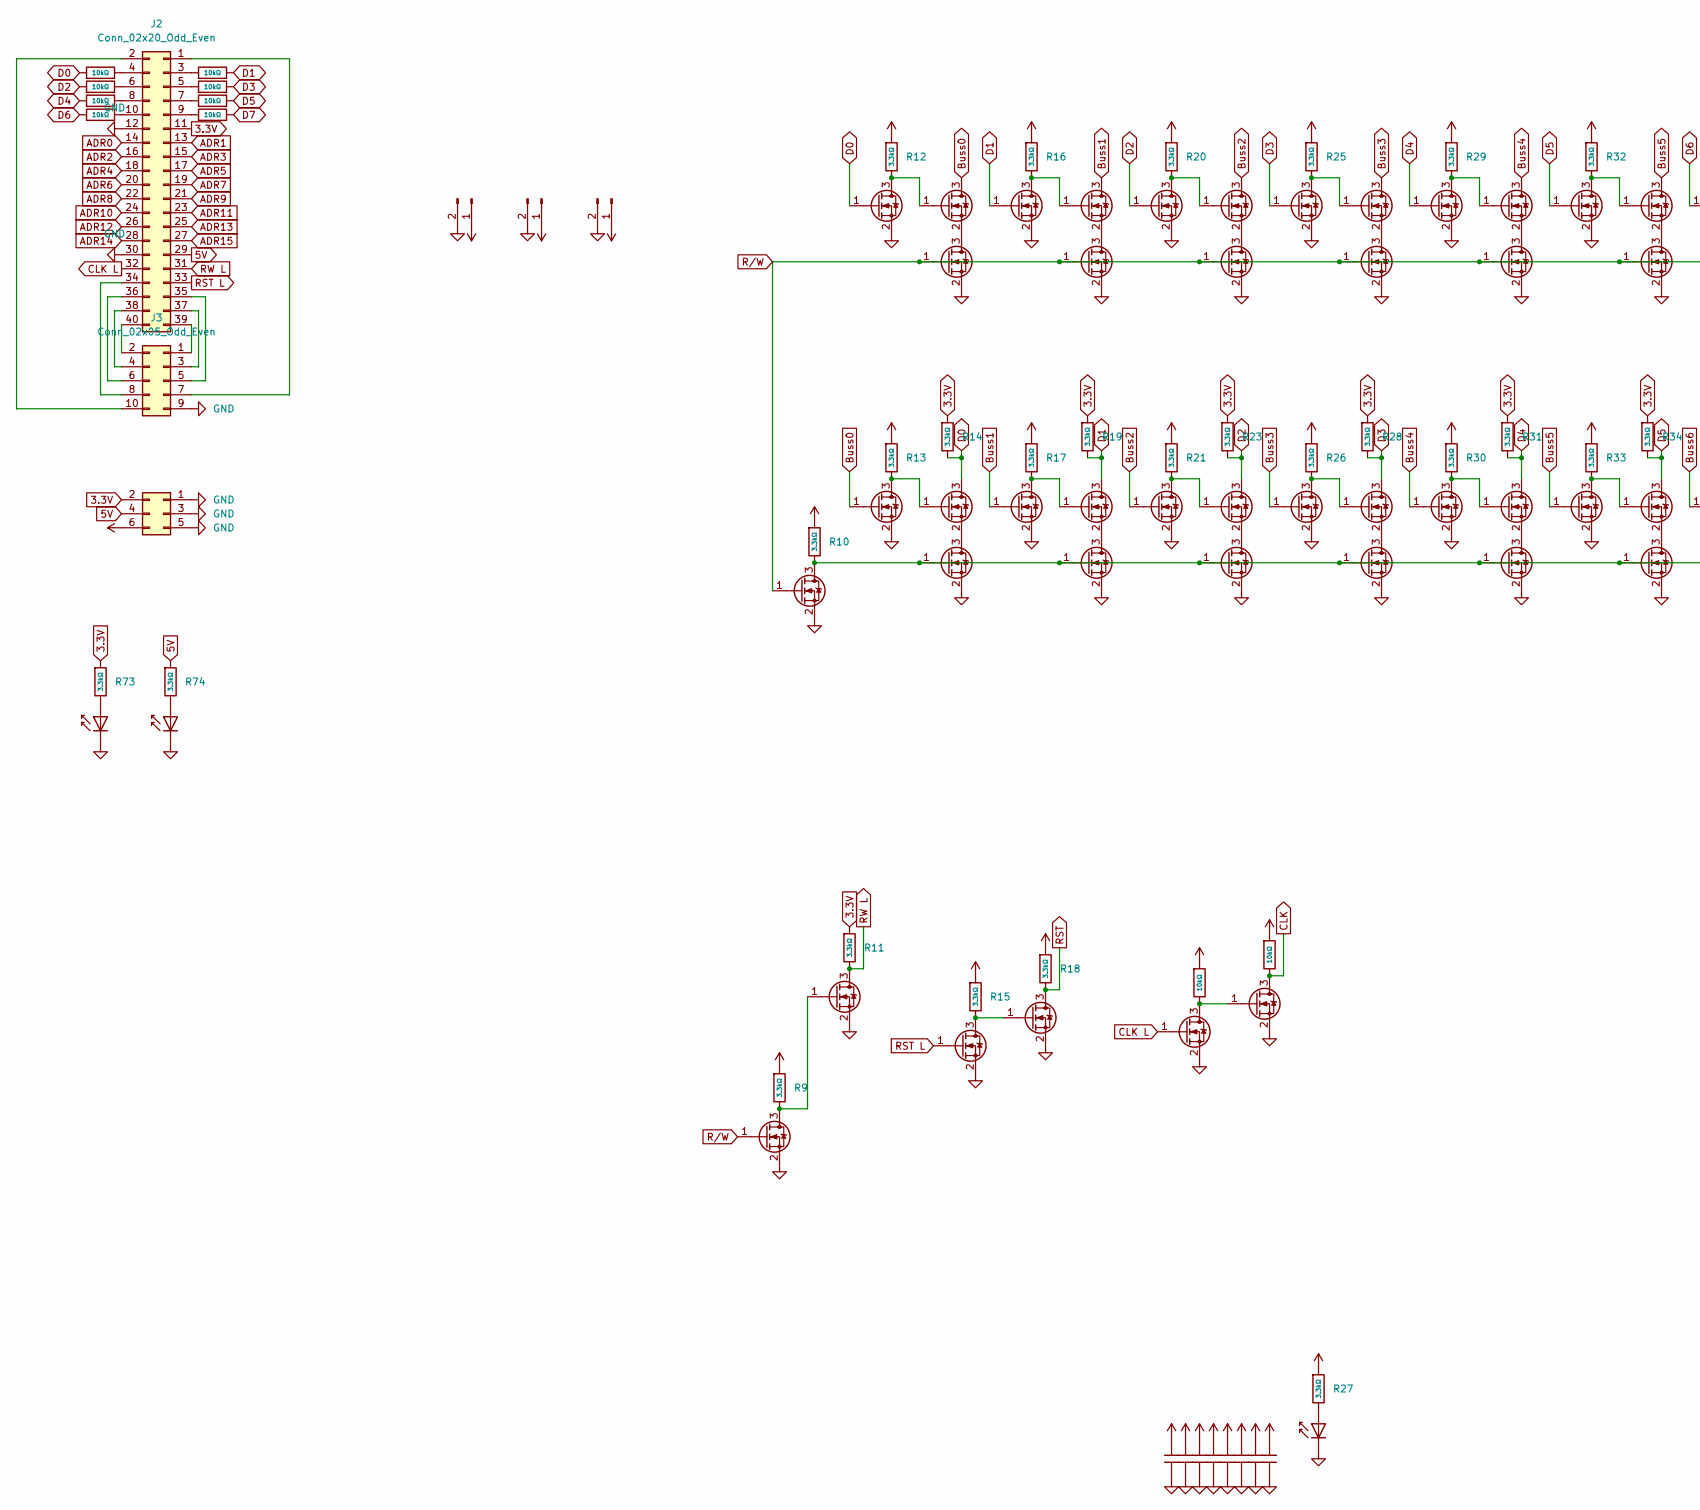
[picture p9: schematic Level_shifter_FPGA_V1.0.kicad_sch, part in row 1, column 1]

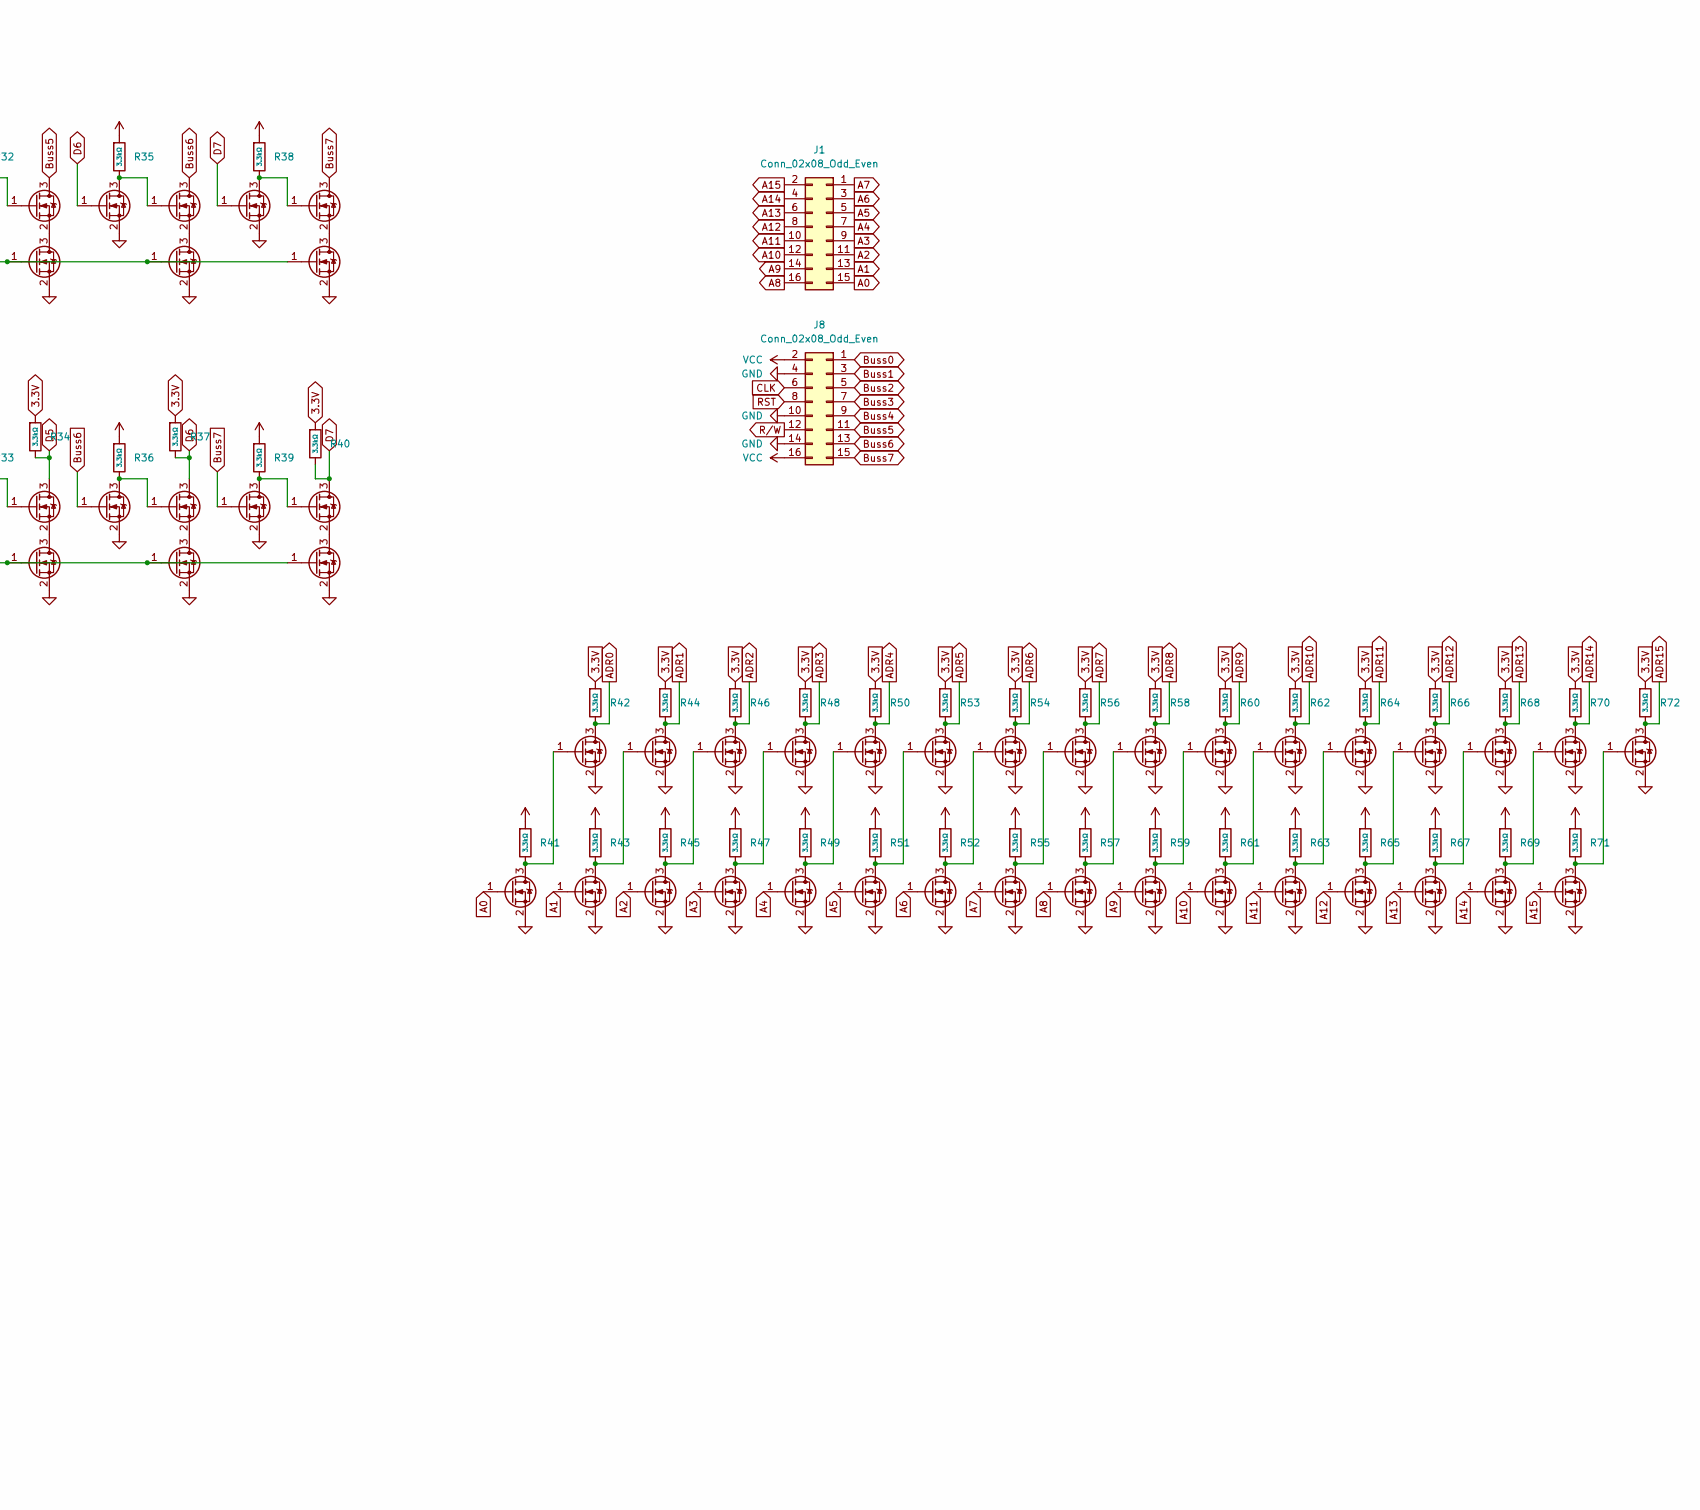
[picture p10: schematic Level_shifter_FPGA_V1.0.kicad_sch, part in row 1, column 2]

Parts:
C1, C2, C3, C4, C5, C6, C7, C8: 22uF; C_0805; Voltage Rated 25V; Tolerance ±20%; Part CL21A226MAQNNNE; LCSC C45783
D1, D2, D3: Red; D_0603; Part KT-0603R; LCSC C2286
J1, J8: Conn_02x08_Odd_Even; PinSocket_2x08_P2.54mm_Vertical
J2: Conn_02x20_Odd_Even; PinSocket_2x20_P2.54mm_Vertical
J3: Conn_02x05_Odd_Even; PinSocket_2x05_P2.54mm_Vertical
J4: Conn_02x03_Odd_Even; PinSocket_2x03_P2.54mm_Vertical
J5, J6, J7: Conn_01x02_Pin; PinSocket_1x02_P2.54mm_Vertical
Q1, Q2, Q3, Q4, Q5, Q6, Q7, Q8, Q9, Q10, Q11, Q12, Q13, Q14, Q15, Q16, Q17, Q18, Q19, Q20, Q21, Q22, Q23, Q24, Q25, Q26, Q27, Q28, Q29, Q30, Q31, Q32, Q33, Q34, Q35, Q36, Q37, Q38, Q39, Q40, Q41, Q42, Q43, Q44, Q45, Q46, Q47, Q48, Q49, Q50, Q51, Q52, Q53, Q54, Q55, Q56, Q57, Q58, Q59, Q60, Q61, Q62, Q63, Q64, Q65, Q66, Q67, Q68, Q69, Q70, Q71, Q72, Q73, Q74, Q75, Q76, Q77, Q78, Q79, Q80, Q81, Q82, Q83, Q84, Q85, Q86, Q87: 2N7002; SOT-23
R1, R2, R3, R4, R5, R6, R7, R8, R22, R24: 10kΩ; R_1206; Overload Voltage (Max) 200V; Tolerance ±1%; Part 1206W4F1002T5E; LCSC C17902
R9, R10, R11, R12, R13, R14, R15, R16, R17, R18, R19, R20, R21, R23, R25, R26, R27, R28, R29, R30, R31, R32, R33, R34, R35, R36, R37, R38, R39, R40, R41, R42, R43, R44, R45, R46, R47, R48, R49, R50, R51, R52, R53, R54, R55, R56, R57, R58, R59, R60, R61, R62, R63, R64, R65, R66, R67, R68, R69, R70, R71, R72, R73, R74: 3.3kΩ; R_0402; Overload Voltage (Max) 50V; Tolerance ±1%; Part 0402WGF3301TCE; LCSC C25890

Connections:
3.3V: J2.11, J4.2, R11.1, R14.1, R19.1, R23.1, R28.1, R31.1, R34.1, R37.1, R40.1, R42.1, R44.1, R46.1, R48.1, R50.1, R53.1, R54.1, R56.1, R58.1, R60.1, R62.1, R64.1, R66.1, R68.1, R70.1, R72.1, R73.1
5V: J2.29, J4.4, R74.1
A0: J1.15, Q56.1 (G)
A1: J1.13, Q58.1 (G)
A2: J1.11, Q60.1 (G)
A3: J1.9, Q62.1 (G)
A4: J1.7, Q64.1 (G)
A5: J1.5, Q66.1 (G)
A6: J1.3, Q68.1 (G)
A7: J1.1, Q70.1 (G)
A8: J1.16, Q72.1 (G)
A9: J1.14, Q74.1 (G)
A10: J1.12, Q76.1 (G)
A11: J1.10, Q78.1 (G)
A12: J1.8, Q80.1 (G)
A13: J1.6, Q82.1 (G)
A14: J1.4, Q84.1 (G)
A15: J1.2, Q86.1 (G)
ADR0: J2.14, Q57.3 (D), R42.2
ADR1: J2.13, Q59.3 (D), R44.2
ADR2: J2.16, Q61.3 (D), R46.2
ADR3: J2.15, Q63.3 (D), R48.2
ADR4: J2.18, Q65.3 (D), R50.2
ADR5: J2.17, Q67.3 (D), R53.2
ADR6: J2.20, Q69.3 (D), R54.2
ADR7: J2.19, Q71.3 (D), R56.2
ADR8: J2.22, Q73.3 (D), R58.2
ADR9: J2.21, Q75.3 (D), R60.2
ADR10: J2.24, Q77.3 (D), R62.2
ADR11: J2.23, Q79.3 (D), R64.2
ADR12: J2.26, Q81.3 (D), R66.2
ADR13: J2.25, Q83.3 (D), R68.2
ADR14: J2.28, Q85.3 (D), R70.2
ADR15: J2.27, Q87.3 (D), R72.2
Buss0: J8.1, Q5.1 (G), Q6.3 (D)
Buss1: J8.3, Q12.1 (G), Q14.3 (D)
Buss2: J8.5, Q19.1 (G), Q21.3 (D)
Buss3: J8.7, Q27.1 (G), Q28.3 (D)
Buss4: J8.9, Q33.1 (G), Q34.3 (D)
Buss5: J8.11, Q39.1 (G), Q40.3 (D)
Buss6: J8.13, Q45.1 (G), Q46.3 (D)
Buss7: J8.15, Q51.1 (G), Q52.3 (D)
CLK: J8.6, Q25.3 (D), R24.2
CLK L: J2.32, Q20.1 (G)
D0: Q4.1 (G), Q8.3 (D), R1.1, R14.2
D1: Q11.1 (G), Q16.3 (D), R2.2, R19.2
D2: Q18.1 (G), Q23.3 (D), R3.1, R23.2
D3: Q26.1 (G), Q30.3 (D), R4.2, R28.2
D4: Q32.1 (G), Q36.3 (D), R5.1, R31.2
D5: Q38.1 (G), Q42.3 (D), R6.2, R34.2
D6: Q44.1 (G), Q48.3 (D), R7.1, R37.2
D7: Q50.1 (G), Q54.3 (D), R8.2, R40.2
GND: C1.2, C2.2, C3.2, C4.2, C5.2, C6.2, C7.2, C8.2, D1.1, D2.1, D3.1, J2.12, J2.30, J3.9, J4.1, J4.3, J4.5, J5.2, J6.2, J7.2, J8.4, J8.10, J8.14, Q1.2 (S), Q2.2 (S), Q3.2 (S), Q4.2 (S), Q5.2 (S), Q7.2 (S), Q9.2 (S), Q10.2 (S), Q11.2 (S), Q12.2 (S), Q13.2 (S), Q15.2 (S), Q17.2 (S), Q18.2 (S), Q19.2 (S), Q20.2 (S), Q22.2 (S), Q24.2 (S), Q25.2 (S), Q26.2 (S), Q27.2 (S), Q29.2 (S), Q31.2 (S), Q32.2 (S), Q33.2 (S), Q35.2 (S), Q37.2 (S), Q38.2 (S), Q39.2 (S), Q41.2 (S), Q43.2 (S), Q44.2 (S), Q45.2 (S), Q47.2 (S), Q49.2 (S), Q50.2 (S), Q51.2 (S), Q53.2 (S), Q55.2 (S), Q56.2 (S), Q57.2 (S), Q58.2 (S), Q59.2 (S), Q60.2 (S), Q61.2 (S), Q62.2 (S), Q63.2 (S), Q64.2 (S), Q65.2 (S), Q66.2 (S), Q67.2 (S), Q68.2 (S), Q69.2 (S), Q70.2 (S), Q71.2 (S), Q72.2 (S), Q73.2 (S), Q74.2 (S), Q75.2 (S), Q76.2 (S), Q77.2 (S), Q78.2 (S), Q79.2 (S), Q80.2 (S), Q81.2 (S), Q82.2 (S), Q83.2 (S), Q84.2 (S), Q85.2 (S), Q86.2 (S), Q87.2 (S)
unnamed: D1.2, R27.2
unnamed: D2.2, R73.2
unnamed: D3.2, R74.2
unnamed: J2.1, J3.7
unnamed: J2.2, J3.10
unnamed: J2.3, R2.1
unnamed: J2.4, R1.2
unnamed: J2.5, R4.1
unnamed: J2.6, R3.2
unnamed: J2.7, R6.1
unnamed: J2.8, R5.2
unnamed: J2.9, R8.1
unnamed: J2.10, R7.2
unnamed: J2.34, J3.8
unnamed: J2.35, J3.5
unnamed: J2.36, J3.6
unnamed: J2.37, J3.3
unnamed: J2.38, J3.4
unnamed: J2.39, J3.1
unnamed: J2.40, J3.2
unnamed: Q1.3 (D), Q3.1 (G), R9.2
unnamed: Q4.3 (D), Q6.1 (G), R12.2
unnamed: Q5.3 (D), Q8.1 (G), R13.2
unnamed: Q6.2 (S), Q7.3 (D)
unnamed: Q8.2 (S), Q9.3 (D)
unnamed: Q10.3 (D), Q13.1 (G), R15.2
unnamed: Q11.3 (D), Q14.1 (G), R16.2
unnamed: Q12.3 (D), Q16.1 (G), R17.2
unnamed: Q14.2 (S), Q15.3 (D)
unnamed: Q16.2 (S), Q17.3 (D)
unnamed: Q2.3 (D), Q9.1 (G), Q17.1 (G), Q24.1 (G), Q31.1 (G), Q37.1 (G), Q43.1 (G), Q49.1 (G), Q55.1 (G), R10.2
unnamed: Q18.3 (D), Q21.1 (G), R20.2
unnamed: Q19.3 (D), Q23.1 (G), R21.2
unnamed: Q20.3 (D), Q25.1 (G), R22.2
unnamed: Q21.2 (S), Q22.3 (D)
unnamed: Q23.2 (S), Q24.3 (D)
unnamed: Q26.3 (D), Q28.1 (G), R25.2
unnamed: Q27.3 (D), Q30.1 (G), R26.2
unnamed: Q28.2 (S), Q29.3 (D)
unnamed: Q30.2 (S), Q31.3 (D)
unnamed: Q32.3 (D), Q34.1 (G), R29.2
unnamed: Q33.3 (D), Q36.1 (G), R30.2
unnamed: Q34.2 (S), Q35.3 (D)
unnamed: Q36.2 (S), Q37.3 (D)
unnamed: Q38.3 (D), Q40.1 (G), R32.2
unnamed: Q39.3 (D), Q42.1 (G), R33.2
unnamed: Q40.2 (S), Q41.3 (D)
unnamed: Q42.2 (S), Q43.3 (D)
unnamed: Q44.3 (D), Q46.1 (G), R35.2
unnamed: Q45.3 (D), Q48.1 (G), R36.2
unnamed: Q46.2 (S), Q47.3 (D)
unnamed: Q48.2 (S), Q49.3 (D)
unnamed: Q50.3 (D), Q52.1 (G), R38.2
unnamed: Q51.3 (D), Q54.1 (G), R39.2
unnamed: Q52.2 (S), Q53.3 (D)
unnamed: Q54.2 (S), Q55.3 (D)
unnamed: Q56.3 (D), Q57.1 (G), R41.2
unnamed: Q58.3 (D), Q59.1 (G), R43.2
unnamed: Q60.3 (D), Q61.1 (G), R45.2
unnamed: Q62.3 (D), Q63.1 (G), R47.2
unnamed: Q64.3 (D), Q65.1 (G), R49.2
unnamed: Q66.3 (D), Q67.1 (G), R51.2
unnamed: Q68.3 (D), Q69.1 (G), R52.2
unnamed: Q70.3 (D), Q71.1 (G), R55.2
unnamed: Q72.3 (D), Q73.1 (G), R57.2
unnamed: Q74.3 (D), Q75.1 (G), R59.2
unnamed: Q76.3 (D), Q77.1 (G), R61.2
unnamed: Q78.3 (D), Q79.1 (G), R63.2
unnamed: Q80.3 (D), Q81.1 (G), R65.2
unnamed: Q82.3 (D), Q83.1 (G), R67.2
unnamed: Q84.3 (D), Q85.1 (G), R69.2
unnamed: Q86.3 (D), Q87.1 (G), R71.2
RST: J8.8, Q13.3 (D), R18.2
RST L: J2.33, Q10.1 (G)
RW L: J2.31, Q3.3 (D), R11.2
R/W: J8.12, Q1.1 (G), Q2.1 (G), Q7.1 (G), Q15.1 (G), Q22.1 (G), Q29.1 (G), Q35.1 (G), Q41.1 (G), Q47.1 (G), Q53.1 (G)
VCC: C1.1, C2.1, C3.1, C4.1, C5.1, C6.1, C7.1, C8.1, J4.6, J5.1, J6.1, J7.1, J8.2, J8.16, R9.1, R10.1, R12.1, R13.1, R15.1, R16.1, R17.1, R18.1, R20.1, R21.1, R22.1, R24.1, R25.1, R26.1, R27.1, R29.1, R30.1, R32.1, R33.1, R35.1, R36.1, R38.1, R39.1, R41.1, R43.1, R45.1, R47.1, R49.1, R51.1, R52.1, R55.1, R57.1, R59.1, R61.1, R63.1, R65.1, R67.1, R69.1, R71.1

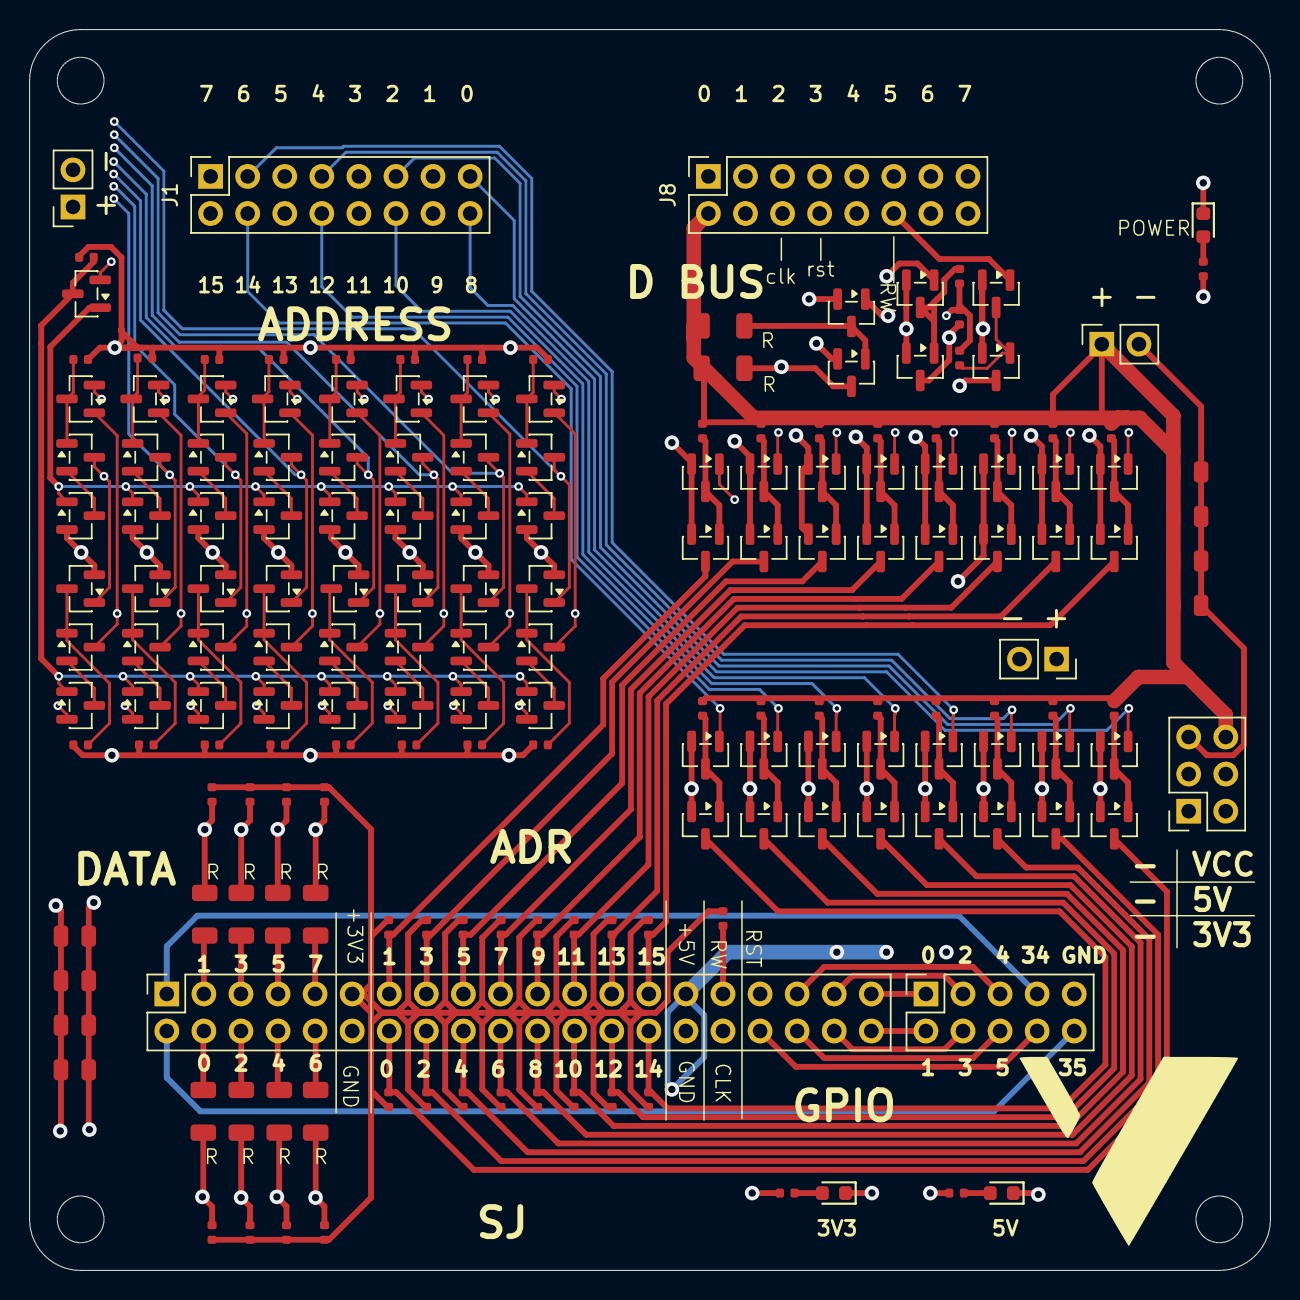
[picture p11: board Level_shifter_FPGA_V1.0.kicad_pcb from above]

Board: 6 copper layers, 85.0 x 85.0 mm, 184 parts (0 on the bottom side), 130 nets.

Other parts of the board:
H25, H25#2, H25#3, H25#4: MountingHole; MountingHole_3.2mm_M3
