SonJonsr/Custom-8bit-CPU/PCB_S/ALU_V2.0/ALU_V2.0.kicad_pcb

## KiCad design PCB_S/ALU_V2.0/ALU_V2.0.kicad_pcb (2026-03-29)

Schematic: ALU_V2.0.kicad_sch

Parts:
C1, C2, C3, C4, C5, C6, C7, C8: 22uF; C_0805; Voltage Rated 25V; Tolerance ±20%; Part CL21A226MAQNNNE; LCSC C45783
D1, D2, D3, D4, D5, D6, D7, D8, D9, D10, D11, D12, D13, D14, D15, D16, D17, D18, D19, D20, D21, D22, D23, D24, D25, D26, D27, D28, D29, D30, D31, D32, D33, D34, D35, D36: Red; D_0603; Part KT-0603R; LCSC C2286
H1, H2, H3, H4: MountingHole; MountingHole_3.2mm_M3
J1, J2, J3: Conn_02x08_Odd_Even; PinSocket_2x08_P2.54mm_Vertical
J4, J6: Conn_01x02_Pin; PinHeader_1x02_P2.54mm_Vertical
Q1, Q2, Q3, Q4, Q5, Q6, Q7, Q8, Q9, Q10, Q11, Q12, Q13, Q14, Q15, Q16, Q17, Q18, Q19, Q20, Q21, Q22, Q23, Q24, Q25, Q26, Q27, Q28, Q29, Q30, Q31, Q32, Q33, Q34, Q35, Q36, Q37, Q38, Q39, Q40, Q41, Q42, Q43, Q44, Q45, Q46, Q47, Q48, Q49, Q50, Q51, Q52, Q53, Q54, Q55, Q56, Q57, Q58, Q59, Q60, Q61, Q62, Q63, Q64, Q65, Q66, Q67, Q68, Q69, Q70, Q71, Q72, Q73, Q74, Q75, Q76, Q77, Q78, Q79, Q80, Q81, Q82, Q83, Q84, Q85, Q86, Q87, Q88, Q89, Q90, Q91, Q92, Q93, Q94, Q95, Q96, Q97, Q98, Q99, Q100, Q101, Q102, Q103, Q104, Q105, Q106, Q107, Q108, Q109, Q110, Q111, Q112, Q113, Q114, Q115, Q116, Q117, Q118, Q119, Q120, Q121, Q122, Q123, Q124, Q125, Q126, Q127, Q128, Q129, Q130, Q131, Q132, Q133, Q134, Q135, Q136, Q137, Q138, Q139, Q140, Q141, Q142, Q143, Q144, Q145, Q146, Q147, Q148, Q149, Q150, Q151, Q152, Q153, Q154, Q155, Q156, Q157, Q158, Q159, Q160, Q161, Q162, Q163, Q164, Q165, Q166, Q167, Q168, Q169, Q170, Q171, Q172, Q173, Q174, Q175, Q176, Q177, Q178, Q179, Q180, Q181, Q182, Q183, Q184, Q185, Q186, Q187, Q188, Q189, Q190, Q191, Q192, Q193, Q194, Q195, Q196, Q197, Q198, Q199, Q200, Q201, Q202, Q203, Q204, Q205, Q206, Q207, Q208, Q209, Q210, Q211, Q212, Q213, Q214, Q215, Q216, Q217, Q218, Q219, Q220, Q221, Q222, Q223, Q224, Q225, Q226, Q227, Q228, Q229, Q230, Q231, Q232, Q233, Q234, Q235, Q236, Q237, Q238, Q239, Q240, Q241, Q242, Q243, Q244, Q245, Q246, Q247, Q248, Q249, Q250, Q251, Q252, Q253, Q254, Q255, Q256, Q257, Q258, Q259, Q260, Q261, Q262, Q263, Q264, Q265, Q266, Q267, Q268, Q269, Q270, Q271, Q277, Q278, Q279, Q280, Q281, Q282, Q283, Q284, Q285, Q286, Q287, Q288, Q289, Q290: 2N7002; SOT-23; Part 2N7002; LCSC C8545
Q272, Q273, Q274, Q275, Q276, Q291, Q292, Q293, Q294, Q295, Q296, Q297, Q298, Q299, Q300, Q301, Q302, Q303, Q304, Q305, Q306, Q307, Q308, Q309, Q310, Q311, Q312, Q313, Q314, Q315, Q316, Q317, Q318, Q319, Q320: 2N7002; SOT-23
R1, R2, R3, R4, R5, R6, R7, R8, R9, R10, R11, R12, R13, R14, R15, R16, R17, R18, R19, R20, R21, R22, R23, R24, R25, R26, R27, R28, R29, R30, R31, R32, R33, R34, R35, R36, R37, R38, R39, R40, R41, R42, R43, R44, R45, R46, R47, R48, R49, R50, R51, R52, R53, R54, R55, R56, R57, R58, R59, R60, R61, R62, R63, R64, R65, R66, R67, R68, R69, R70, R71, R72, R73, R74, R75, R76, R77, R78, R79, R80, R81, R82, R83, R84, R85, R86, R87, R88, R89, R90, R91, R92, R93, R94, R95, R96, R97, R98, R99, R100, R101, R102, R103, R104, R105, R106, R107, R108, R109, R110, R111, R112, R113, R114, R115, R116, R117, R118, R119, R120, R121, R122, R123, R124, R125, R126, R127, R128, R129, R130, R131, R132, R133, R134, R135, R136, R137, R138, R139, R140, R141, R142, R143, R144, R145, R146, R147, R148, R149, R150, R151, R152, R153, R154, R155, R156, R157, R158, R159, R160, R161, R162, R163, R164, R165, R166, R167, R168, R169, R170, R171, R172, R173, R174, R175, R176, R177, R178, R179, R180, R181, R182, R183, R184, R185, R186, R187, R188, R189, R190, R191, R192, R193, R194, R195, R196, R197, R198, R199, R200, R201, R202, R203, R204: 10kΩ; R_0402; Overload Voltage (Max) 50V; Tolerance ±1%; Part 0402WGF1002TCE; LCSC C25744

Connections:
/C_in: J2.14, Q28.1 (G)
/C_out: J2.12, Q265.3 (D), Q320.1 (G), R125.2
/N: J1.15, J2.4, Q253.3 (D), Q279.1 (G), Q282.1 (G), Q290.1 (G), Q293.1 (G), Q310.1 (G), R120.2
/O: J2.10, Q286.3 (D), Q319.1 (G), R133.2
/U: J2.8, Q264.3 (D), Q318.1 (G), R124.2
/Z: J2.6, Q268.3 (D), Q269.3 (D), Q270.3 (D), Q271.3 (D), Q287.3 (D), Q288.3 (D), Q289.3 (D), Q290.3 (D), Q311.1 (G), R127.2
GND: C1.2, C2.2, C3.2, C4.2, C5.2, C6.2, C7.2, C8.2, D36.1, J1.4, J1.8, J1.12, J1.16, J2.2, J2.16, J4.2, J6.2, Q1.2 (S), Q2.2 (S), Q3.2 (S), Q4.2 (S), Q5.2 (S), Q6.2 (S), Q7.2 (S), Q8.2 (S), Q9.2 (S), Q10.2 (S), Q11.2 (S), Q12.2 (S), Q13.2 (S), Q14.2 (S), Q15.2 (S), Q16.2 (S), Q17.2 (S), Q18.2 (S), Q19.2 (S), Q20.2 (S), Q21.2 (S), Q22.2 (S), Q23.2 (S), Q24.2 (S), Q26.2 (S), Q28.2 (S), Q31.2 (S), Q33.2 (S), Q35.2 (S), Q38.2 (S), Q41.2 (S), Q43.2 (S), Q46.2 (S), Q48.2 (S), Q50.2 (S), Q53.2 (S), Q56.2 (S), Q58.2 (S), Q61.2 (S), Q63.2 (S), Q65.2 (S), Q68.2 (S), Q71.2 (S), Q73.2 (S), Q76.2 (S), Q78.2 (S), Q80.2 (S), Q83.2 (S), Q86.2 (S), Q88.2 (S), Q91.2 (S), Q93.2 (S), Q95.2 (S), Q98.2 (S), Q101.2 (S), Q103.2 (S), Q106.2 (S), Q108.2 (S), Q110.2 (S), Q113.2 (S), Q116.2 (S), Q118.2 (S), Q121.2 (S), Q123.2 (S), Q125.2 (S), Q128.2 (S), Q131.2 (S), Q133.2 (S), Q136.2 (S), Q138.2 (S), Q140.2 (S), Q143.2 (S), Q146.2 (S), Q155.2 (S), Q156.2 (S), Q157.2 (S), Q158.2 (S), Q159.2 (S), Q160.2 (S), Q161.2 (S), Q162.2 (S), Q164.2 (S), Q166.2 (S), Q168.2 (S), Q170.2 (S), Q172.2 (S), Q174.2 (S), Q176.2 (S), Q178.2 (S), Q180.2 (S), Q182.2 (S), Q184.2 (S), Q186.2 (S), Q188.2 (S), Q190.2 (S), Q192.2 (S), Q194.2 (S), Q196.2 (S), Q198.2 (S), Q200.2 (S), Q202.2 (S), Q204.2 (S), Q206.2 (S), Q208.2 (S), Q210.2 (S), Q212.2 (S), Q214.2 (S), Q216.2 (S), Q218.2 (S), Q220.2 (S), Q222.2 (S), Q224.2 (S), Q226.2 (S), Q228.2 (S), Q230.2 (S), Q232.2 (S), Q234.2 (S), Q236.2 (S), Q238.2 (S), Q240.2 (S), Q242.2 (S), Q244.2 (S), Q246.2 (S), Q248.2 (S), Q250.2 (S), Q252.2 (S), Q254.2 (S), Q255.2 (S), Q256.2 (S), Q257.2 (S), Q258.2 (S), Q259.2 (S), Q260.2 (S), Q261.2 (S), Q263.2 (S), Q264.2 (S), Q265.2 (S), Q267.2 (S), Q268.2 (S), Q269.2 (S), Q270.2 (S), Q271.2 (S), Q272.2 (S), Q273.2 (S), Q274.2 (S), Q275.2 (S), Q276.2 (S), Q277.2 (S), Q278.2 (S), Q281.2 (S), Q282.2 (S), Q285.2 (S), Q286.2 (S), Q287.2 (S), Q288.2 (S), Q289.2 (S), Q290.2 (S), Q291.2 (S), Q292.2 (S), Q293.2 (S), Q294.2 (S), Q295.2 (S), Q296.2 (S), Q297.2 (S), Q298.2 (S), Q299.2 (S), Q300.2 (S), Q301.2 (S), Q302.2 (S), Q303.2 (S), Q304.2 (S), Q305.2 (S), Q306.2 (S), Q307.2 (S), Q308.2 (S), Q309.2 (S), Q310.2 (S), Q311.2 (S), Q312.2 (S), Q313.2 (S), Q314.2 (S), Q315.2 (S), Q316.2 (S), Q317.2 (S), Q318.2 (S), Q319.2 (S), Q320.2 (S)
unnamed: D1.2, R128.2, R134.2
unnamed: D2.2, R135.2, R136.2
unnamed: D3.2, R137.2, R138.2
unnamed: D4.2, R139.2, R140.2
unnamed: D5.2, R175.2, R176.2
unnamed: D6.2, R177.2, R178.2
unnamed: D7.2, R179.2, R180.2
unnamed: D8.2, R181.2, R182.2
unnamed: D9.2, R141.2, R142.2
unnamed: D10.2, R143.2, R144.2
unnamed: D11.2, R145.2, R146.2
unnamed: D12.2, R147.2, R148.2
unnamed: D13.2, R189.2, R190.2
unnamed: D14.2, R191.2, R192.2
unnamed: D15.2, R193.2, R194.2
unnamed: D16.2, R195.2, R196.2
unnamed: D17.2, R149.2, R150.2
unnamed: D18.2, R151.2, R152.2
unnamed: D19.2, R153.2, R154.2
unnamed: D20.2, R155.2, R156.2
unnamed: D21.2, R197.2, R198.2
unnamed: D22.2, R199.2, R200.2
unnamed: D23.2, R201.2, R202.2
unnamed: D24.2, R203.2, R204.2
unnamed: D25.2, R173.2, R174.2
unnamed: D26.2, R171.2, R172.2
unnamed: D27.2, R159.2, R160.2
unnamed: D28.2, R161.2, R162.2
unnamed: D29.2, R163.2, R164.2
unnamed: D30.2, R183.2, R184.2
unnamed: D31.2, R185.2, R186.2
unnamed: D32.2, R187.2, R188.2
unnamed: D33.2, R167.2, R170.2
unnamed: D34.2, R165.2, R166.2
unnamed: D35.2, R157.2, R158.2
unnamed: D36.2, R168.2, R169.2
unnamed: J1.1, Q239.3 (D), Q268.1 (G), Q273.1 (G), R113.2
unnamed: J1.3, Q241.3 (D), Q269.1 (G), Q272.1 (G), R114.2
unnamed: J1.5, Q243.3 (D), Q270.1 (G), Q274.1 (G), R115.2
unnamed: J1.7, Q245.3 (D), Q271.1 (G), Q275.1 (G), R116.2
unnamed: J1.9, Q247.3 (D), Q276.1 (G), Q287.1 (G), R117.2
unnamed: J1.11, Q249.3 (D), Q288.1 (G), Q291.1 (G), R118.2
unnamed: J1.13, Q251.3 (D), Q289.1 (G), Q292.1 (G), R119.2
unnamed: J2.3, Q210.1 (G), Q212.1 (G), Q214.1 (G), Q216.1 (G), Q218.1 (G), Q220.1 (G), Q222.1 (G), Q224.1 (G), Q260.1 (G), Q267.1 (G), Q317.1 (G)
unnamed: J2.5, Q180.1 (G), Q184.1 (G), Q188.1 (G), Q192.1 (G), Q196.1 (G), Q200.1 (G), Q204.1 (G), Q208.1 (G), Q259.1 (G), Q316.1 (G)
unnamed: J2.7, Q178.1 (G), Q182.1 (G), Q186.1 (G), Q190.1 (G), Q194.1 (G), Q198.1 (G), Q202.1 (G), Q206.1 (G), Q258.1 (G), Q315.1 (G)
unnamed: J2.9, Q226.1 (G), Q228.1 (G), Q230.1 (G), Q232.1 (G), Q234.1 (G), Q236.1 (G), Q238.1 (G), Q257.1 (G), Q263.1 (G), Q314.1 (G)
unnamed: J2.11, Q146.1 (G), Q164.1 (G), Q166.1 (G), Q168.1 (G), Q170.1 (G), Q172.1 (G), Q174.1 (G), Q176.1 (G), Q256.1 (G), Q313.1 (G)
unnamed: J2.13, Q155.1 (G), Q156.1 (G), Q157.1 (G), Q158.1 (G), Q159.1 (G), Q160.1 (G), Q161.1 (G), Q162.1 (G), Q255.1 (G), Q312.1 (G)
unnamed: J3.1, Q2.1 (G), Q34.1 (G), Q36.1 (G), Q294.1 (G)
unnamed: J3.2, Q1.1 (G), Q33.1 (G), Q262.1 (G), Q302.1 (G)
unnamed: J3.3, Q5.1 (G), Q49.1 (G), Q51.1 (G), Q295.1 (G)
unnamed: J3.4, Q4.1 (G), Q48.1 (G), Q225.1 (G), Q303.1 (G)
unnamed: J3.5, Q8.1 (G), Q64.1 (G), Q66.1 (G), Q296.1 (G)
unnamed: J3.6, Q7.1 (G), Q63.1 (G), Q227.1 (G), Q304.1 (G)
unnamed: J3.7, Q11.1 (G), Q79.1 (G), Q81.1 (G), Q297.1 (G)
unnamed: J3.8, Q10.1 (G), Q78.1 (G), Q229.1 (G), Q305.1 (G)
unnamed: J3.9, Q14.1 (G), Q94.1 (G), Q96.1 (G), Q298.1 (G)
unnamed: J3.10, Q13.1 (G), Q93.1 (G), Q231.1 (G), Q306.1 (G)
unnamed: J3.11, Q17.1 (G), Q109.1 (G), Q111.1 (G), Q299.1 (G)
unnamed: J3.12, Q16.1 (G), Q108.1 (G), Q233.1 (G), Q307.1 (G)
unnamed: J3.13, Q20.1 (G), Q124.1 (G), Q126.1 (G), Q300.1 (G)
unnamed: J3.14, Q19.1 (G), Q123.1 (G), Q235.1 (G), Q308.1 (G)
unnamed: J3.15, Q23.1 (G), Q139.1 (G), Q141.1 (G), Q278.1 (G), Q284.1 (G), Q301.1 (G)
unnamed: J3.16, Q22.1 (G), Q138.1 (G), Q237.1 (G), Q277.1 (G), Q285.1 (G), Q309.1 (G)
unnamed: Q1.3 (D), Q2.3 (D), Q3.1 (G), R1.2
unnamed: Q4.3 (D), Q5.3 (D), Q6.1 (G), R3.2
unnamed: Q7.3 (D), Q8.3 (D), Q9.1 (G), R5.2
unnamed: Q10.3 (D), Q11.3 (D), Q12.1 (G), R7.2
unnamed: Q12.3 (D), Q151.1 (G), R8.2
unnamed: Q13.3 (D), Q14.3 (D), Q15.1 (G), R9.2
unnamed: Q15.3 (D), Q150.1 (G), R10.2
unnamed: Q16.3 (D), Q17.3 (D), Q18.1 (G), R11.2
unnamed: Q19.3 (D), Q20.3 (D), Q21.1 (G), R13.2
unnamed: Q22.3 (D), Q23.3 (D), Q24.1 (G), R15.2
unnamed: Q25.3 (D), Q26.1 (G), R17.2
unnamed: Q25.1 (G), Q30.1 (G), Q34.3 (D), Q35.1 (G), R23.2
unnamed: Q26.3 (D), Q27.2 (S)
unnamed: Q27.1 (G), Q36.3 (D), R25.2
unnamed: Q28.3 (D), Q29.2 (S), Q37.2 (S)
unnamed: Q29.3 (D), Q31.1 (G), R19.2
unnamed: Q29.1 (G), Q37.3 (D), Q38.1 (G), R26.2
unnamed: Q30.3 (D), Q43.1 (G), R20.2
unnamed: Q30.2 (S), Q38.3 (D), Q39.2 (S)
unnamed: Q31.3 (D), Q32.2 (S)
unnamed: Q32.1 (G), Q39.3 (D), R27.2
unnamed: Q40.3 (D), Q41.1 (G), R28.2
unnamed: Q40.1 (G), Q45.1 (G), Q49.3 (D), Q50.1 (G), R34.2
unnamed: Q41.3 (D), Q42.2 (S)
unnamed: Q42.1 (G), Q51.3 (D), R36.2
unnamed: Q43.3 (D), Q44.2 (S), Q52.2 (S)
unnamed: Q44.3 (D), Q46.1 (G), R30.2
unnamed: Q44.1 (G), Q52.3 (D), Q53.1 (G), R37.2
unnamed: Q45.3 (D), Q58.1 (G), R31.2
unnamed: Q45.2 (S), Q53.3 (D), Q54.2 (S)
unnamed: Q46.3 (D), Q47.2 (S)
unnamed: Q47.1 (G), Q54.3 (D), R38.2
unnamed: Q55.3 (D), Q56.1 (G), R39.2
unnamed: Q55.1 (G), Q60.1 (G), Q64.3 (D), Q65.1 (G), R45.2
unnamed: Q56.3 (D), Q57.2 (S)
unnamed: Q57.1 (G), Q66.3 (D), R47.2
unnamed: Q58.3 (D), Q59.2 (S), Q67.2 (S)
unnamed: Q59.3 (D), Q61.1 (G), R41.2
unnamed: Q59.1 (G), Q67.3 (D), Q68.1 (G), R48.2
unnamed: Q60.3 (D), Q73.1 (G), R42.2
unnamed: Q60.2 (S), Q68.3 (D), Q69.2 (S)
unnamed: Q61.3 (D), Q62.2 (S)
unnamed: Q62.1 (G), Q69.3 (D), R49.2
unnamed: Q70.3 (D), Q71.1 (G), R50.2
unnamed: Q70.1 (G), Q75.1 (G), Q79.3 (D), Q80.1 (G), R56.2
unnamed: Q71.3 (D), Q72.2 (S)
unnamed: Q72.1 (G), Q81.3 (D), R58.2
unnamed: Q73.3 (D), Q74.2 (S), Q82.2 (S)
unnamed: Q74.3 (D), Q76.1 (G), R52.2
unnamed: Q74.1 (G), Q82.3 (D), Q83.1 (G), R59.2
unnamed: Q75.3 (D), Q88.1 (G), R53.2
unnamed: Q75.2 (S), Q83.3 (D), Q84.2 (S)
unnamed: Q76.3 (D), Q77.2 (S)
unnamed: Q77.1 (G), Q84.3 (D), R60.2
unnamed: Q85.3 (D), Q86.1 (G), R61.2
unnamed: Q85.1 (G), Q90.1 (G), Q94.3 (D), Q95.1 (G), R67.2
unnamed: Q86.3 (D), Q87.2 (S)
unnamed: Q87.1 (G), Q96.3 (D), R69.2
unnamed: Q88.3 (D), Q89.2 (S), Q97.2 (S)
unnamed: Q89.3 (D), Q91.1 (G), R63.2
unnamed: Q89.1 (G), Q97.3 (D), Q98.1 (G), R70.2
unnamed: Q90.2 (S), Q98.3 (D), Q99.2 (S)
unnamed: Q91.3 (D), Q92.2 (S)
unnamed: Q92.1 (G), Q99.3 (D), R71.2
unnamed: Q100.3 (D), Q101.1 (G), R72.2
unnamed: Q100.1 (G), Q105.1 (G), Q109.3 (D), Q110.1 (G), R78.2
unnamed: Q100.2 (S), Q108.3 (D), Q109.2 (S), Q197.1 (G), R77.2
unnamed: Q101.3 (D), Q102.2 (S)
unnamed: Q102.3 (D), Q112.1 (G), Q114.1 (G), Q199.1 (G), R73.2
unnamed: Q102.1 (G), Q111.3 (D), R80.2
unnamed: Q103.3 (D), Q104.2 (S), Q112.2 (S)
unnamed: Q90.3 (D), Q103.1 (G), R64.2
unnamed: Q104.3 (D), Q106.1 (G), R74.2
unnamed: Q104.1 (G), Q112.3 (D), Q113.1 (G), R81.2
unnamed: Q105.3 (D), Q118.1 (G), R75.2
unnamed: Q105.2 (S), Q113.3 (D), Q114.2 (S)
unnamed: Q106.3 (D), Q107.2 (S)
unnamed: Q107.3 (D), Q219.1 (G), R76.2
unnamed: Q107.1 (G), Q114.3 (D), R82.2
unnamed: Q110.3 (D), Q111.2 (S), Q171.1 (G), R79.2
unnamed: Q115.3 (D), Q116.1 (G), R83.2
unnamed: Q115.1 (G), Q120.1 (G), Q124.3 (D), Q125.1 (G), R89.2
unnamed: Q115.2 (S), Q123.3 (D), Q124.2 (S), Q201.1 (G), R88.2
unnamed: Q116.3 (D), Q117.2 (S)
unnamed: Q117.3 (D), Q127.1 (G), Q129.1 (G), Q203.1 (G), R84.2
unnamed: Q117.1 (G), Q126.3 (D), R91.2
unnamed: Q118.3 (D), Q119.2 (S), Q127.2 (S)
unnamed: Q119.3 (D), Q121.1 (G), R85.2
unnamed: Q119.1 (G), Q127.3 (D), Q128.1 (G), R92.2
unnamed: Q120.3 (D), Q133.1 (G), R86.2
unnamed: Q120.2 (S), Q128.3 (D), Q129.2 (S)
unnamed: Q121.3 (D), Q122.2 (S)
unnamed: Q122.3 (D), Q221.1 (G), R87.2
unnamed: Q122.1 (G), Q129.3 (D), R93.2
unnamed: Q125.3 (D), Q126.2 (S), Q173.1 (G), R90.2
unnamed: Q130.3 (D), Q131.1 (G), R94.2
unnamed: Q130.1 (G), Q135.1 (G), Q139.3 (D), Q140.1 (G), R100.2
unnamed: Q130.2 (S), Q138.3 (D), Q139.2 (S), Q205.1 (G), R99.2
unnamed: Q131.3 (D), Q132.2 (S)
unnamed: Q132.3 (D), Q142.1 (G), Q144.1 (G), Q207.1 (G), R95.2
unnamed: Q132.1 (G), Q141.3 (D), R102.2
unnamed: Q133.3 (D), Q134.2 (S), Q142.2 (S)
unnamed: Q134.3 (D), Q136.1 (G), R96.2
unnamed: Q134.1 (G), Q142.3 (D), Q143.1 (G), R103.2
unnamed: Q135.3 (D), Q266.1 (G), R97.2
unnamed: Q135.2 (S), Q143.3 (D), Q144.2 (S)
unnamed: Q136.3 (D), Q137.2 (S)
unnamed: Q137.3 (D), Q223.1 (G), R98.2
unnamed: Q137.1 (G), Q144.3 (D), R104.2
unnamed: Q140.3 (D), Q141.2 (S), Q175.1 (G), R101.2
unnamed: Q145.3 (D), Q154.3 (D), Q177.3 (D), Q179.3 (D), Q209.3 (D), Q225.3 (D), Q239.1 (G), R105.2
unnamed: Q35.3 (D), Q36.2 (S), Q145.1 (G), R24.2
unnamed: Q145.2 (S), Q146.3 (D)
unnamed: Q147.3 (D), Q175.3 (D), Q205.3 (D), Q207.3 (D), Q223.3 (D), Q253.1 (G), R112.2
unnamed: Q24.3 (D), Q147.1 (G), R16.2
unnamed: Q147.2 (S), Q162.3 (D)
unnamed: Q148.3 (D), Q173.3 (D), Q201.3 (D), Q203.3 (D), Q221.3 (D), Q237.3 (D), Q251.1 (G), R111.2
unnamed: Q21.3 (D), Q148.1 (G), R14.2
unnamed: Q148.2 (S), Q161.3 (D)
unnamed: Q149.3 (D), Q171.3 (D), Q197.3 (D), Q199.3 (D), Q219.3 (D), Q235.3 (D), Q249.1 (G), R110.2
unnamed: Q18.3 (D), Q149.1 (G), R12.2
unnamed: Q149.2 (S), Q160.3 (D)
unnamed: Q150.3 (D), Q169.3 (D), Q193.3 (D), Q195.3 (D), Q217.3 (D), Q233.3 (D), Q247.1 (G), R109.2
unnamed: Q150.2 (S), Q159.3 (D)
unnamed: Q151.3 (D), Q167.3 (D), Q189.3 (D), Q191.3 (D), Q215.3 (D), Q231.3 (D), Q245.1 (G), R108.2
unnamed: Q151.2 (S), Q158.3 (D)
unnamed: Q152.3 (D), Q165.3 (D), Q185.3 (D), Q187.3 (D), Q213.3 (D), Q229.3 (D), Q243.1 (G), R107.2
unnamed: Q9.3 (D), Q152.1 (G), R6.2
unnamed: Q152.2 (S), Q157.3 (D)
unnamed: Q153.3 (D), Q163.3 (D), Q181.3 (D), Q183.3 (D), Q211.3 (D), Q227.3 (D), Q241.1 (G), R106.2
unnamed: Q6.3 (D), Q153.1 (G), R4.2
unnamed: Q153.2 (S), Q156.3 (D)
unnamed: Q3.3 (D), Q154.1 (G), R2.2
unnamed: Q154.2 (S), Q155.3 (D)
unnamed: Q50.3 (D), Q51.2 (S), Q163.1 (G), R35.2
unnamed: Q163.2 (S), Q164.3 (D)
unnamed: Q65.3 (D), Q66.2 (S), Q165.1 (G), R46.2
unnamed: Q165.2 (S), Q166.3 (D)
unnamed: Q80.3 (D), Q81.2 (S), Q167.1 (G), R57.2
unnamed: Q167.2 (S), Q168.3 (D)
unnamed: Q95.3 (D), Q96.2 (S), Q169.1 (G), R68.2
unnamed: Q169.2 (S), Q170.3 (D)
unnamed: Q171.2 (S), Q172.3 (D)
unnamed: Q173.2 (S), Q174.3 (D)
unnamed: Q175.2 (S), Q176.3 (D)
unnamed: Q25.2 (S), Q33.3 (D), Q34.2 (S), Q177.1 (G), R22.2
unnamed: Q177.2 (S), Q178.3 (D)
unnamed: Q27.3 (D), Q37.1 (G), Q39.1 (G), Q179.1 (G), R18.2
unnamed: Q179.2 (S), Q180.3 (D)
unnamed: Q40.2 (S), Q48.3 (D), Q49.2 (S), Q181.1 (G), R33.2
unnamed: Q181.2 (S), Q182.3 (D)
unnamed: Q42.3 (D), Q52.1 (G), Q54.1 (G), Q183.1 (G), R29.2
unnamed: Q183.2 (S), Q184.3 (D)
unnamed: Q55.2 (S), Q63.3 (D), Q64.2 (S), Q185.1 (G), R44.2
unnamed: Q185.2 (S), Q186.3 (D)
unnamed: Q57.3 (D), Q67.1 (G), Q69.1 (G), Q187.1 (G), R40.2
unnamed: Q187.2 (S), Q188.3 (D)
unnamed: Q70.2 (S), Q78.3 (D), Q79.2 (S), Q189.1 (G), R55.2
unnamed: Q189.2 (S), Q190.3 (D)
unnamed: Q72.3 (D), Q82.1 (G), Q84.1 (G), Q191.1 (G), R51.2
unnamed: Q191.2 (S), Q192.3 (D)
unnamed: Q85.2 (S), Q93.3 (D), Q94.2 (S), Q193.1 (G), R66.2
unnamed: Q193.2 (S), Q194.3 (D)
unnamed: Q87.3 (D), Q97.1 (G), Q99.1 (G), Q195.1 (G), R62.2
unnamed: Q195.2 (S), Q196.3 (D)
unnamed: Q197.2 (S), Q198.3 (D)
unnamed: Q199.2 (S), Q200.3 (D)
unnamed: Q201.2 (S), Q202.3 (D)
unnamed: Q203.2 (S), Q204.3 (D)
unnamed: Q205.2 (S), Q206.3 (D)
unnamed: Q207.2 (S), Q208.3 (D)
unnamed: Q32.3 (D), Q209.1 (G), R21.2
unnamed: Q209.2 (S), Q210.3 (D)
unnamed: Q47.3 (D), Q211.1 (G), R32.2
unnamed: Q211.2 (S), Q212.3 (D)
unnamed: Q62.3 (D), Q213.1 (G), R43.2
unnamed: Q213.2 (S), Q214.3 (D)
unnamed: Q77.3 (D), Q215.1 (G), R54.2
unnamed: Q215.2 (S), Q216.3 (D)
unnamed: Q92.3 (D), Q217.1 (G), R65.2
unnamed: Q217.2 (S), Q218.3 (D)
unnamed: Q219.2 (S), Q220.3 (D)
unnamed: Q221.2 (S), Q222.3 (D)
unnamed: Q223.2 (S), Q224.3 (D)
unnamed: Q225.2 (S), Q226.3 (D)
unnamed: Q227.2 (S), Q228.3 (D)
unnamed: Q229.2 (S), Q230.3 (D)
unnamed: Q231.2 (S), Q232.3 (D)
unnamed: Q233.2 (S), Q234.3 (D)
unnamed: Q235.2 (S), Q236.3 (D)
unnamed: Q237.2 (S), Q238.3 (D)
unnamed: Q239.2 (S), Q240.3 (D)
unnamed: Q240.1 (G), Q242.1 (G), Q244.1 (G), Q246.1 (G), Q248.1 (G), Q250.1 (G), Q252.1 (G), Q254.1 (G), Q261.3 (D), R121.2
unnamed: Q241.2 (S), Q242.3 (D)
unnamed: Q243.2 (S), Q244.3 (D)
unnamed: Q245.2 (S), Q246.3 (D)
unnamed: Q247.2 (S), Q248.3 (D)
unnamed: Q249.2 (S), Q250.3 (D)
unnamed: Q251.2 (S), Q252.3 (D)
unnamed: Q253.2 (S), Q254.3 (D)
unnamed: Q255.3 (D), Q256.3 (D), Q257.3 (D), Q258.3 (D), Q259.3 (D), Q260.3 (D), Q261.1 (G), R122.2
unnamed: Q262.3 (D), Q264.1 (G), R123.2
unnamed: Q262.2 (S), Q263.3 (D)
unnamed: Q265.1 (G), Q266.3 (D), R126.2
unnamed: Q266.2 (S), Q267.3 (D)
unnamed: D2.1, Q272.3 (D)
unnamed: D1.1, Q273.3 (D)
unnamed: D3.1, Q274.3 (D)
unnamed: D4.1, Q275.3 (D)
unnamed: D5.1, Q276.3 (D)
unnamed: Q277.3 (D), Q281.1 (G), R129.2
unnamed: Q278.3 (D), Q280.1 (G), R130.2
unnamed: Q279.3 (D), Q283.3 (D), Q286.1 (G), R132.2
unnamed: Q279.2 (S), Q280.3 (D)
unnamed: Q280.2 (S), Q281.3 (D)
unnamed: Q282.3 (D), Q283.1 (G), R131.2
unnamed: Q283.2 (S), Q284.3 (D)
unnamed: Q284.2 (S), Q285.3 (D)
unnamed: D6.1, Q291.3 (D)
unnamed: D7.1, Q292.3 (D)
unnamed: D8.1, Q293.3 (D)
unnamed: D9.1, Q294.3 (D)
unnamed: D10.1, Q295.3 (D)
unnamed: D11.1, Q296.3 (D)
unnamed: D12.1, Q297.3 (D)
unnamed: D13.1, Q298.3 (D)
unnamed: D14.1, Q299.3 (D)
unnamed: D15.1, Q300.3 (D)
unnamed: D16.1, Q301.3 (D)
unnamed: D17.1, Q302.3 (D)
unnamed: D18.1, Q303.3 (D)
unnamed: D19.1, Q304.3 (D)
unnamed: D20.1, Q305.3 (D)
unnamed: D21.1, Q306.3 (D)
unnamed: D22.1, Q307.3 (D)
unnamed: D23.1, Q308.3 (D)
unnamed: D24.1, Q309.3 (D)
unnamed: D25.1, Q310.3 (D)
unnamed: D26.1, Q311.3 (D)
unnamed: D27.1, Q312.3 (D)
unnamed: D28.1, Q313.3 (D)
unnamed: D29.1, Q314.3 (D)
unnamed: D30.1, Q315.3 (D)
unnamed: D31.1, Q316.3 (D)
unnamed: D32.1, Q317.3 (D)
unnamed: D33.1, Q318.3 (D)
unnamed: D34.1, Q319.3 (D)
unnamed: D35.1, Q320.3 (D)
VCC: C1.1, C2.1, C3.1, C4.1, C5.1, C6.1, C7.1, C8.1, J1.2, J1.6, J1.10, J1.14, J2.1, J2.15, J4.1, J6.1, R1.1, R2.1, R3.1, R4.1, R5.1, R6.1, R7.1, R8.1, R9.1, R10.1, R11.1, R12.1, R13.1, R14.1, R15.1, R16.1, R17.1, R18.1, R19.1, R20.1, R21.1, R22.1, R23.1, R24.1, R25.1, R26.1, R27.1, R28.1, R29.1, R30.1, R31.1, R32.1, R33.1, R34.1, R35.1, R36.1, R37.1, R38.1, R39.1, R40.1, R41.1, R42.1, R43.1, R44.1, R45.1, R46.1, R47.1, R48.1, R49.1, R50.1, R51.1, R52.1, R53.1, R54.1, R55.1, R56.1, R57.1, R58.1, R59.1, R60.1, R61.1, R62.1, R63.1, R64.1, R65.1, R66.1, R67.1, R68.1, R69.1, R70.1, R71.1, R72.1, R73.1, R74.1, R75.1, R76.1, R77.1, R78.1, R79.1, R80.1, R81.1, R82.1, R83.1, R84.1, R85.1, R86.1, R87.1, R88.1, R89.1, R90.1, R91.1, R92.1, R93.1, R94.1, R95.1, R96.1, R97.1, R98.1, R99.1, R100.1, R101.1, R102.1, R103.1, R104.1, R105.1, R106.1, R107.1, R108.1, R109.1, R110.1, R111.1, R112.1, R113.1, R114.1, R115.1, R116.1, R117.1, R118.1, R119.1, R120.1, R121.1, R122.1, R123.1, R124.1, R125.1, R126.1, R127.1, R128.1, R129.1, R130.1, R131.1, R132.1, R133.1, R134.1, R135.1, R136.1, R137.1, R138.1, R139.1, R140.1, R141.1, R142.1, R143.1, R144.1, R145.1, R146.1, R147.1, R148.1, R149.1, R150.1, R151.1, R152.1, R153.1, R154.1, R155.1, R156.1, R157.1, R158.1, R159.1, R160.1, R161.1, R162.1, R163.1, R164.1, R165.1, R166.1, R167.1, R168.1, R169.1, R170.1, R171.1, R172.1, R173.1, R174.1, R175.1, R176.1, R177.1, R178.1, R179.1, R180.1, R181.1, R182.1, R183.1, R184.1, R185.1, R186.1, R187.1, R188.1, R189.1, R190.1, R191.1, R192.1, R193.1, R194.1, R195.1, R196.1, R197.1, R198.1, R199.1, R200.1, R201.1, R202.1, R203.1, R204.1

Notes on the sheet:
Result
Dont need these resistors
Carry Inn
Pin 1 is Most Significant Bit
ADD
NOT
AND
XOR
