SonJonsr/Custom-8bit-CPU/PCB_S/ALU_V2.0/ALU_V2.0.kicad_pcb

## KiCad design PCB_S/ALU_V2.0/ALU_V2.0.kicad_pcb (continued)

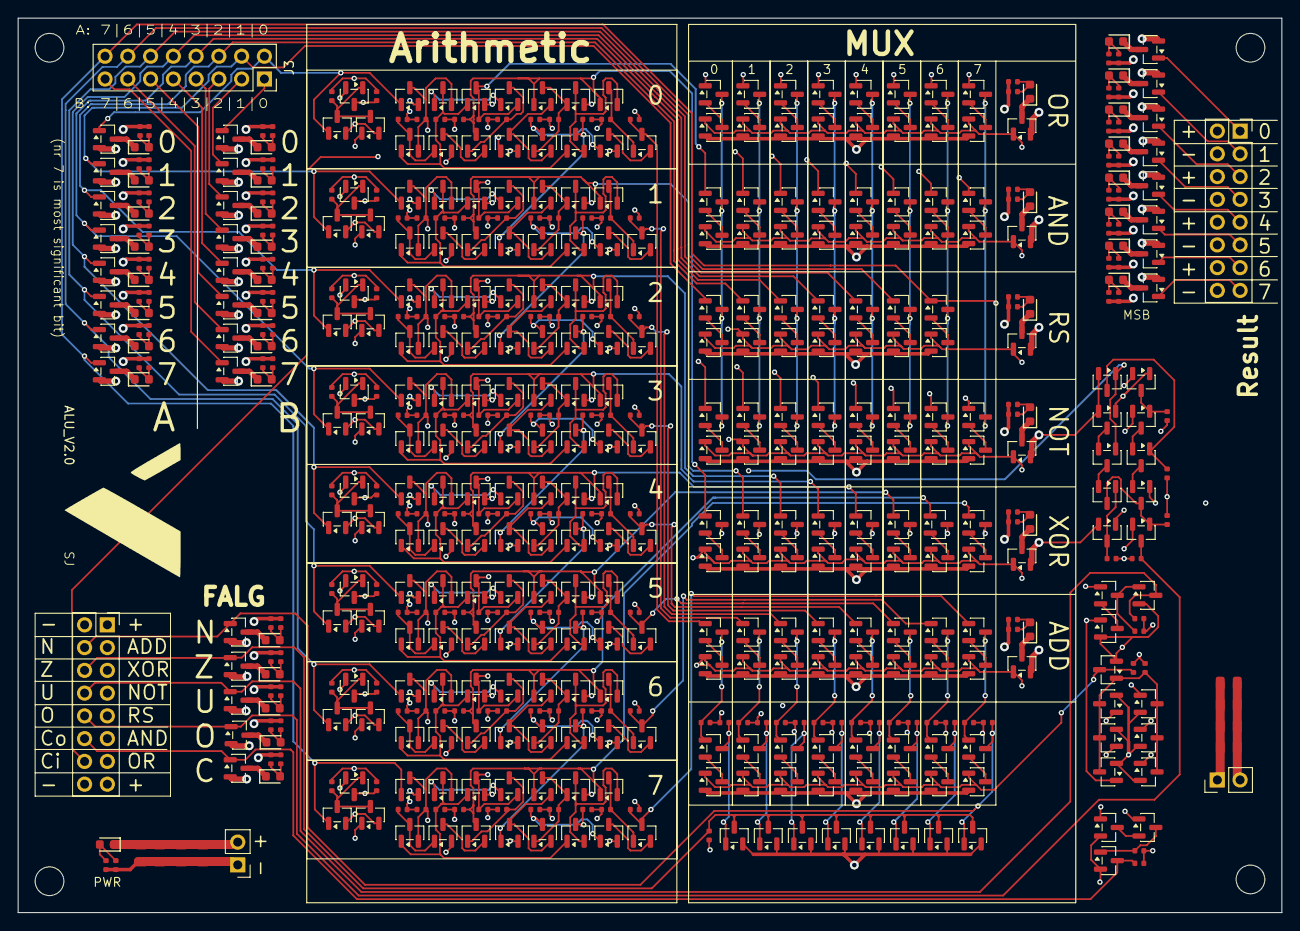
[picture p12: board ALU_V2.0.kicad_pcb from above]

Board: 6 copper layers, 141.0 x 99.8 mm, 577 parts (0 on the bottom side), 321 nets.
