SonJonsr/Custom-8bit-CPU/PCB_S/Register_Holder_V1.0/Register_Holder_V2.0/Register_Holder_V2.0.kicad_pcb

## KiCad design PCB_S/Register_Holder_V1.0/Register_Holder_V2.0/Register_Holder_V2.0.kicad_pcb (2026-03-29)

Schematic: Register_Holder_V2.0.kicad_sch

Parts:
C1, C2, C3, C4, C5, C6, C7, C8, C9, C10, C11, C12, C13, C14, C15, C16: 22uF; C_0805; Voltage Rated 25V; Tolerance ±20%; Part CL21A226MAQNNNE; LCSC C45783
D1, D2, D3, D4, D5, D6, D7, D8, D9, D10, D11, D12, D13, D14, D15, D16, D24: Red; D_0603; Part KT-0603R; LCSC C2286
H1, H2, H3, H4, H5, H6, H7, H8, H9, H10, H11, H12, H13, H14, H15, H16: MountingHole; MountingHole_2.2mm_M2
H17, H18, H19, H20: MountingHole; MountingHole_3.2mm_M3
J1, J2, J3, J4: Conn_01x21_Socket; PinHeader_1x21_P2.54mm_Vertical
J5, J7, J9, J12: Conn_02x08_Odd_Even; PinSocket_2x08_P2.54mm_Vertical
J13, J14, J15: Conn_01x02_Pin; PinHeader_1x02_P2.54mm_Vertical
Q1, Q2, Q3, Q4, Q5, Q6, Q7, Q8, Q9, Q10, Q11, Q12, Q13, Q14, Q15, Q16, Q17, Q18, Q19, Q20, Q21, Q22, Q23, Q24, Q25, Q26, Q27, Q28, Q29, Q30, Q31, Q32, Q33, Q34, Q35, Q36, Q37, Q38, Q39, Q40, Q41, Q42, Q43, Q44, Q45, Q46, Q47, Q48, Q49, Q50, Q51, Q52, Q53, Q54, Q55, Q56, Q57, Q58, Q59, Q60, Q61, Q62, Q63, Q64, Q65, Q66, Q67, Q68, Q69, Q70, Q71, Q72, Q73, Q74, Q75, Q76, Q77, Q78, Q79, Q80, Q81, Q82, Q83, Q84, Q85, Q86, Q87, Q88, Q89, Q90, Q91, Q92, Q93, Q94, Q95, Q96, Q97, Q98, Q99, Q100, Q101, Q102, Q103, Q104, Q105, Q106, Q107, Q108, Q109, Q110, Q111, Q112, Q113, Q114, Q115, Q116, Q117, Q118, Q119, Q120, Q121, Q122, Q123, Q124, Q125, Q126, Q127, Q128, Q129, Q130, Q131, Q132, Q133, Q134, Q135, Q136, Q137, Q138, Q139, Q140, Q141, Q142, Q143, Q144, Q145, Q146, Q147, Q148, Q149, Q150, Q151, Q152, Q153, Q154, Q155, Q156, Q157, Q158, Q159, Q160, Q161, Q162, Q163, Q164, Q165, Q166, Q167, Q168: 2N7002; SOT-23
R1, R2, R3, R4, R5, R6, R7, R8, R9, R10, R11, R12, R13, R14, R15, R16, R17, R18, R19, R20, R21, R22, R23, R24, R25, R26, R27, R28, R29, R30, R31, R32, R33, R34, R35, R36, R37, R38, R39, R40, R41, R42, R43, R44, R45, R46, R47, R48, R49, R50, R51, R52, R53, R54, R55, R56, R57, R58, R59, R60, R61, R62, R63, R64, R65, R66: 10kΩ; R_0402; Overload Voltage (Max) 50V; Tolerance ±1%; Part 0402WGF1002TCE; LCSC C25744

Connections:
/ALU B -> FF: J5.7, Q161.1 (G), Q162.1 (G), Q163.1 (G), Q164.1 (G), Q165.1 (G), Q166.1 (G), Q167.1 (G), Q168.1 (G)
GND: C1.2, C2.2, C3.2, C4.2, C5.2, C6.2, C7.2, C8.2, C9.2, C10.2, C11.2, C12.2, C13.2, C14.2, C15.2, C16.2, D8.1, J1.2, J2.2, J3.2, J4.2, J5.1, J9.3, J9.7, J9.11, J9.15, J12.1, J12.5, J12.9, J12.13, J13.2, J14.2, J15.2, Q2.2 (S), Q4.2 (S), Q6.2 (S), Q8.2 (S), Q10.2 (S), Q12.2 (S), Q14.2 (S), Q16.2 (S), Q17.2 (S), Q18.2 (S), Q19.2 (S), Q20.2 (S), Q21.2 (S), Q22.2 (S), Q23.2 (S), Q24.2 (S), Q33.2 (S), Q34.2 (S), Q35.2 (S), Q36.2 (S), Q37.2 (S), Q38.2 (S), Q39.2 (S), Q40.2 (S), Q49.2 (S), Q50.2 (S), Q51.2 (S), Q52.2 (S), Q53.2 (S), Q54.2 (S), Q55.2 (S), Q56.2 (S), Q65.2 (S), Q66.2 (S), Q67.2 (S), Q68.2 (S), Q69.2 (S), Q70.2 (S), Q71.2 (S), Q72.2 (S), Q81.2 (S), Q82.2 (S), Q83.2 (S), Q84.2 (S), Q85.2 (S), Q86.2 (S), Q87.2 (S), Q88.2 (S), Q97.2 (S), Q98.2 (S), Q99.2 (S), Q100.2 (S), Q101.2 (S), Q102.2 (S), Q103.2 (S), Q104.2 (S), Q113.2 (S), Q114.2 (S), Q115.2 (S), Q116.2 (S), Q117.2 (S), Q118.2 (S), Q119.2 (S), Q120.2 (S), Q129.2 (S), Q130.2 (S), Q131.2 (S), Q132.2 (S), Q133.2 (S), Q134.2 (S), Q135.2 (S), Q136.2 (S), Q137.2 (S), Q138.2 (S), Q139.2 (S), Q140.2 (S), Q141.2 (S), Q142.2 (S), Q143.2 (S), Q144.2 (S), Q145.2 (S), Q146.2 (S), Q147.2 (S), Q148.2 (S), Q149.2 (S), Q150.2 (S), Q151.2 (S), Q152.2 (S), Q153.2 (S), Q154.2 (S), Q155.2 (S), Q156.2 (S), Q157.2 (S), Q158.2 (S), Q159.2 (S), Q160.2 (S), Q161.2 (S), Q162.2 (S), Q163.2 (S), Q164.2 (S), Q165.2 (S), Q166.2 (S), Q167.2 (S), Q168.2 (S)
unnamed: D1.2, R53.2, R54.2
unnamed: D2.2, R55.2, R56.2
unnamed: D3.2, R57.2, R58.2
unnamed: D4.2, R59.2, R60.2
unnamed: D5.2, R61.2, R62.2
unnamed: D6.2, R63.2, R64.2
unnamed: D7.2, R65.2, R66.2
unnamed: D8.2, R33.2, R34.2
unnamed: D9.2, R37.2, R38.2
unnamed: D10.2, R35.2, R36.2
unnamed: D11.2, R39.2, R40.2
unnamed: D12.2, R41.2, R42.2
unnamed: D13.2, R43.2, R44.2
unnamed: D14.2, R45.2, R46.2
unnamed: D15.2, R47.2, R48.2
unnamed: D16.2, R49.2, R50.2
unnamed: D24.2, R51.2, R52.2
unnamed: J1.4, J5.15
unnamed: J1.6, J2.6, J3.6, J4.6, J9.2, J12.16, Q160.1 (G)
unnamed: J1.7, J2.7, J3.7, J4.7, J9.4, J12.14, Q159.1 (G)
unnamed: J1.8, J2.8, J3.8, J4.8, J9.6, J12.12, Q158.1 (G)
unnamed: J1.9, J2.9, J3.9, J4.9, J9.8, J12.10, Q157.1 (G)
unnamed: J1.10, J2.10, J3.10, J4.10, J9.10, J12.8, Q156.1 (G)
unnamed: J1.11, J2.11, J3.11, J4.11, J9.12, J12.6, Q155.1 (G)
unnamed: J1.12, J2.12, J3.12, J4.12, J9.14, J12.4, Q153.1 (G)
unnamed: J1.13, J2.13, J3.13, J4.13, J9.16, J12.2, Q154.1 (G)
unnamed: J1.14, Q15.1 (G), Q80.1 (G)
unnamed: J1.15, Q13.1 (G), Q79.1 (G)
unnamed: J1.16, Q11.1 (G), Q78.1 (G)
unnamed: J1.17, Q9.1 (G), Q77.1 (G)
unnamed: J1.18, Q7.1 (G), Q76.1 (G)
unnamed: J1.19, Q5.1 (G), Q75.1 (G)
unnamed: J1.20, Q3.1 (G), Q74.1 (G)
unnamed: J1.21, Q1.1 (G), Q73.1 (G)
unnamed: J2.4, J5.13
unnamed: J2.14, Q32.1 (G), Q48.1 (G)
unnamed: J2.15, Q31.1 (G), Q47.1 (G)
unnamed: J2.16, Q30.1 (G), Q46.1 (G)
unnamed: J2.17, Q29.1 (G), Q45.1 (G)
unnamed: J2.18, Q28.1 (G), Q44.1 (G)
unnamed: J2.19, Q27.1 (G), Q43.1 (G)
unnamed: J2.20, Q26.1 (G), Q42.1 (G)
unnamed: J2.21, Q25.1 (G), Q41.1 (G)
unnamed: J3.4, J5.11
unnamed: J3.14, Q64.1 (G), Q96.1 (G)
unnamed: J3.15, Q63.1 (G), Q95.1 (G)
unnamed: J3.16, Q62.1 (G), Q94.1 (G)
unnamed: J3.17, Q61.1 (G), Q93.1 (G)
unnamed: J3.18, Q60.1 (G), Q92.1 (G)
unnamed: J3.19, Q59.1 (G), Q91.1 (G)
unnamed: J3.20, Q58.1 (G), Q90.1 (G)
unnamed: J3.21, Q57.1 (G), Q89.1 (G)
unnamed: J4.4, J5.9
unnamed: J4.14, Q112.1 (G), Q128.1 (G)
unnamed: J4.15, Q111.1 (G), Q127.1 (G)
unnamed: J4.16, Q110.1 (G), Q126.1 (G)
unnamed: J4.17, Q109.1 (G), Q125.1 (G)
unnamed: J4.18, Q108.1 (G), Q124.1 (G)
unnamed: J4.19, Q107.1 (G), Q123.1 (G)
unnamed: J4.20, Q106.1 (G), Q122.1 (G)
unnamed: J4.21, Q105.1 (G), Q121.1 (G)
unnamed: J5.2, Q113.1 (G), Q114.1 (G), Q115.1 (G), Q116.1 (G), Q117.1 (G), Q118.1 (G), Q119.1 (G), Q120.1 (G), Q152.1 (G)
unnamed: J5.4, Q81.1 (G), Q82.1 (G), Q83.1 (G), Q84.1 (G), Q85.1 (G), Q86.1 (G), Q87.1 (G), Q88.1 (G), Q150.1 (G)
unnamed: J5.6, Q33.1 (G), Q34.1 (G), Q35.1 (G), Q36.1 (G), Q37.1 (G), Q38.1 (G), Q39.1 (G), Q40.1 (G), Q148.1 (G)
unnamed: J5.8, Q65.1 (G), Q66.1 (G), Q67.1 (G), Q68.1 (G), Q69.1 (G), Q70.1 (G), Q71.1 (G), Q72.1 (G), Q146.1 (G)
unnamed: J5.10, Q97.1 (G), Q98.1 (G), Q99.1 (G), Q100.1 (G), Q101.1 (G), Q102.1 (G), Q103.1 (G), Q104.1 (G), Q151.1 (G)
unnamed: J5.12, Q49.1 (G), Q50.1 (G), Q51.1 (G), Q52.1 (G), Q53.1 (G), Q54.1 (G), Q55.1 (G), Q56.1 (G), Q149.1 (G)
unnamed: J5.14, Q17.1 (G), Q18.1 (G), Q19.1 (G), Q20.1 (G), Q21.1 (G), Q22.1 (G), Q23.1 (G), Q24.1 (G), Q147.1 (G)
unnamed: J5.16, Q2.1 (G), Q4.1 (G), Q6.1 (G), Q8.1 (G), Q10.1 (G), Q12.1 (G), Q14.1 (G), Q16.1 (G), Q145.1 (G)
unnamed: J7.1, Q137.3 (D), R25.2
unnamed: J7.2, Q129.3 (D), R1.2
unnamed: J7.3, Q138.3 (D), R26.2
unnamed: J7.4, Q130.3 (D), R2.2
unnamed: J7.5, Q139.3 (D), R27.2
unnamed: J7.6, Q131.3 (D), R3.2
unnamed: J7.7, Q140.3 (D), R28.2
unnamed: J7.8, Q132.3 (D), R4.2
unnamed: J7.9, Q141.3 (D), R29.2
unnamed: J7.10, Q133.3 (D), R5.2
unnamed: J7.11, Q142.3 (D), R30.2
unnamed: J7.12, Q134.3 (D), R6.2
unnamed: J7.13, Q143.3 (D), R31.2
unnamed: J7.14, Q135.3 (D), R7.2
unnamed: J7.15, Q144.3 (D), R32.2
unnamed: J7.16, Q136.3 (D), R8.2
unnamed: Q1.3 (D), Q25.3 (D), Q57.3 (D), Q105.3 (D), Q136.1 (G), R16.2
unnamed: Q1.2 (S), Q2.3 (D)
unnamed: Q3.2 (S), Q4.3 (D)
unnamed: Q5.2 (S), Q6.3 (D)
unnamed: Q7.2 (S), Q8.3 (D)
unnamed: Q9.2 (S), Q10.3 (D)
unnamed: Q11.3 (D), Q30.3 (D), Q62.3 (D), Q110.3 (D), Q131.1 (G), R11.2
unnamed: Q11.2 (S), Q12.3 (D)
unnamed: Q13.2 (S), Q14.3 (D)
unnamed: Q15.2 (S), Q16.3 (D)
unnamed: Q17.3 (D), Q25.2 (S)
unnamed: Q18.3 (D), Q26.2 (S)
unnamed: Q19.3 (D), Q27.2 (S)
unnamed: Q20.3 (D), Q28.2 (S)
unnamed: Q21.3 (D), Q29.2 (S)
unnamed: Q22.3 (D), Q30.2 (S)
unnamed: Q23.3 (D), Q31.2 (S)
unnamed: Q24.3 (D), Q32.2 (S)
unnamed: Q33.3 (D), Q41.2 (S)
unnamed: Q34.3 (D), Q42.2 (S)
unnamed: Q35.3 (D), Q43.2 (S)
unnamed: Q36.3 (D), Q44.2 (S)
unnamed: Q37.3 (D), Q45.2 (S)
unnamed: Q38.3 (D), Q46.2 (S)
unnamed: Q39.3 (D), Q47.2 (S)
unnamed: Q40.3 (D), Q48.2 (S)
unnamed: Q49.3 (D), Q57.2 (S)
unnamed: Q50.3 (D), Q58.2 (S)
unnamed: Q51.3 (D), Q59.2 (S)
unnamed: Q52.3 (D), Q60.2 (S)
unnamed: Q53.3 (D), Q61.2 (S)
unnamed: Q54.3 (D), Q62.2 (S)
unnamed: Q55.3 (D), Q63.2 (S)
unnamed: Q56.3 (D), Q64.2 (S)
unnamed: Q65.3 (D), Q73.2 (S)
unnamed: Q66.3 (D), Q74.2 (S)
unnamed: Q67.3 (D), Q75.2 (S)
unnamed: Q68.3 (D), Q76.2 (S)
unnamed: Q69.3 (D), Q77.2 (S)
unnamed: Q70.3 (D), Q78.2 (S)
unnamed: Q71.3 (D), Q79.2 (S)
unnamed: Q72.3 (D), Q80.2 (S)
unnamed: Q81.3 (D), Q89.2 (S)
unnamed: Q82.3 (D), Q90.2 (S)
unnamed: Q83.3 (D), Q91.2 (S)
unnamed: Q84.3 (D), Q92.2 (S)
unnamed: Q85.3 (D), Q93.2 (S)
unnamed: Q86.3 (D), Q94.2 (S)
unnamed: Q87.3 (D), Q95.2 (S)
unnamed: Q88.3 (D), Q96.2 (S)
unnamed: Q100.3 (D), Q108.2 (S)
unnamed: Q101.3 (D), Q109.2 (S)
unnamed: Q102.3 (D), Q110.2 (S)
unnamed: Q103.3 (D), Q111.2 (S)
unnamed: Q104.3 (D), Q112.2 (S)
unnamed: Q97.3 (D), Q105.2 (S)
unnamed: Q3.3 (D), Q26.3 (D), Q58.3 (D), Q106.3 (D), Q135.1 (G), R15.2
unnamed: Q98.3 (D), Q106.2 (S)
unnamed: Q5.3 (D), Q27.3 (D), Q59.3 (D), Q107.3 (D), Q134.1 (G), R14.2
unnamed: Q99.3 (D), Q107.2 (S)
unnamed: Q7.3 (D), Q28.3 (D), Q60.3 (D), Q108.3 (D), Q133.1 (G), R13.2
unnamed: Q9.3 (D), Q29.3 (D), Q61.3 (D), Q109.3 (D), Q132.1 (G), R12.2
unnamed: Q13.3 (D), Q31.3 (D), Q63.3 (D), Q111.3 (D), Q130.1 (G), R10.2
unnamed: Q15.3 (D), Q32.3 (D), Q64.3 (D), Q112.3 (D), Q129.1 (G), R9.2
unnamed: Q113.3 (D), Q121.2 (S)
unnamed: Q114.3 (D), Q122.2 (S)
unnamed: Q115.3 (D), Q123.2 (S)
unnamed: Q116.3 (D), Q124.2 (S)
unnamed: Q117.3 (D), Q125.2 (S)
unnamed: Q118.3 (D), Q126.2 (S)
unnamed: Q119.3 (D), Q127.2 (S)
unnamed: Q120.3 (D), Q128.2 (S)
unnamed: Q41.3 (D), Q73.3 (D), Q89.3 (D), Q121.3 (D), Q144.1 (G), Q168.3 (D), R24.2
unnamed: Q42.3 (D), Q74.3 (D), Q90.3 (D), Q122.3 (D), Q143.1 (G), Q167.3 (D), R23.2
unnamed: Q43.3 (D), Q75.3 (D), Q91.3 (D), Q123.3 (D), Q142.1 (G), Q166.3 (D), R22.2
unnamed: Q44.3 (D), Q76.3 (D), Q92.3 (D), Q124.3 (D), Q141.1 (G), Q165.3 (D), R21.2
unnamed: Q45.3 (D), Q77.3 (D), Q93.3 (D), Q125.3 (D), Q140.1 (G), Q164.3 (D), R20.2
unnamed: Q46.3 (D), Q78.3 (D), Q94.3 (D), Q126.3 (D), Q139.1 (G), Q163.3 (D), R19.2
unnamed: Q47.3 (D), Q79.3 (D), Q95.3 (D), Q127.3 (D), Q138.1 (G), Q162.3 (D), R18.2
unnamed: Q48.3 (D), Q80.3 (D), Q96.3 (D), Q128.3 (D), Q137.1 (G), Q161.3 (D), R17.2
unnamed: D24.1, Q145.3 (D)
unnamed: D1.1, Q146.3 (D)
unnamed: D2.1, Q147.3 (D)
unnamed: D3.1, Q148.3 (D)
unnamed: D4.1, Q149.3 (D)
unnamed: D5.1, Q150.3 (D)
unnamed: D6.1, Q151.3 (D)
unnamed: D7.1, Q152.3 (D)
unnamed: D9.1, Q153.3 (D)
unnamed: D10.1, Q154.3 (D)
unnamed: D11.1, Q155.3 (D)
unnamed: D12.1, Q156.3 (D)
unnamed: D13.1, Q157.3 (D)
unnamed: D14.1, Q158.3 (D)
unnamed: D15.1, Q159.3 (D)
unnamed: D16.1, Q160.3 (D)
RST: J1.3, J2.3, J3.3, J4.3, J5.3
Rising_Edge: J1.5, J2.5, J3.5, J4.5, J5.5
VCC: C1.1, C2.1, C3.1, C4.1, C5.1, C6.1, C7.1, C8.1, C9.1, C10.1, C11.1, C12.1, C13.1, C14.1, C15.1, C16.1, J1.1, J2.1, J3.1, J4.1, J9.1, J9.5, J9.9, J9.13, J12.3, J12.7, J12.11, J12.15, J13.1, J14.1, J15.1, R1.1, R2.1, R3.1, R4.1, R5.1, R6.1, R7.1, R8.1, R9.1, R10.1, R11.1, R12.1, R13.1, R14.1, R15.1, R16.1, R17.1, R18.1, R19.1, R20.1, R21.1, R22.1, R23.1, R24.1, R25.1, R26.1, R27.1, R28.1, R29.1, R30.1, R31.1, R32.1, R33.1, R34.1, R35.1, R36.1, R37.1, R38.1, R39.1, R40.1, R41.1, R42.1, R43.1, R44.1, R45.1, R46.1, R47.1, R48.1, R49.1, R50.1, R51.1, R52.1, R53.1, R54.1, R55.1, R56.1, R57.1, R58.1, R59.1, R60.1, R61.1, R62.1, R63.1, R64.1, R65.1, R66.1

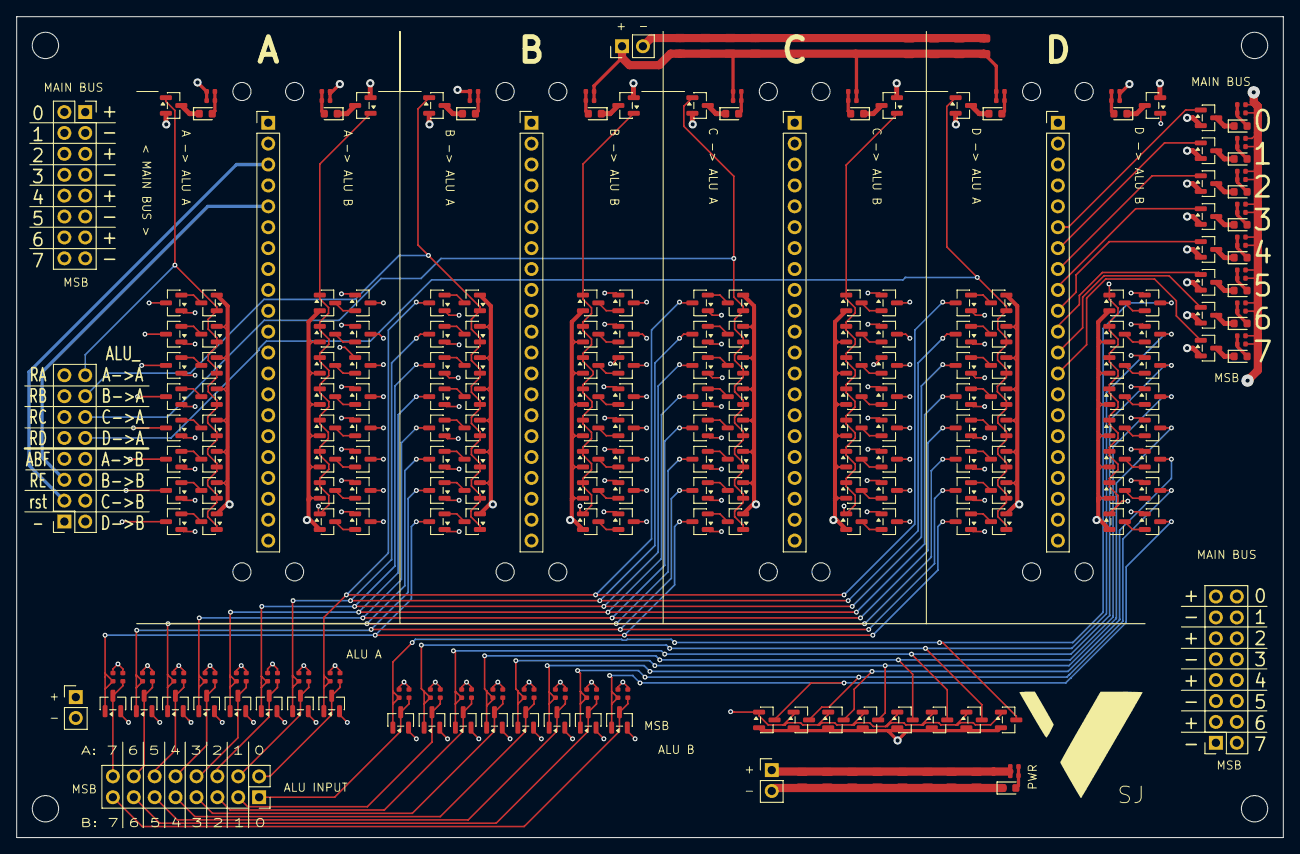
[picture p13: board Register_Holder_V2.0.kicad_pcb from above]

Board: 6 copper layers, 154.0 x 99.8 mm, 298 parts (0 on the bottom side), 186 nets.
