SonJonsr/Custom-8bit-CPU/PCB_S/REG8bit-SMD-V5.0/REG8bit-SMD-V5.0.kicad_pcb

## KiCad design PCB_S/REG8bit-SMD-V5.0/REG8bit-SMD-V5.0.kicad_pcb (2026-03-05)

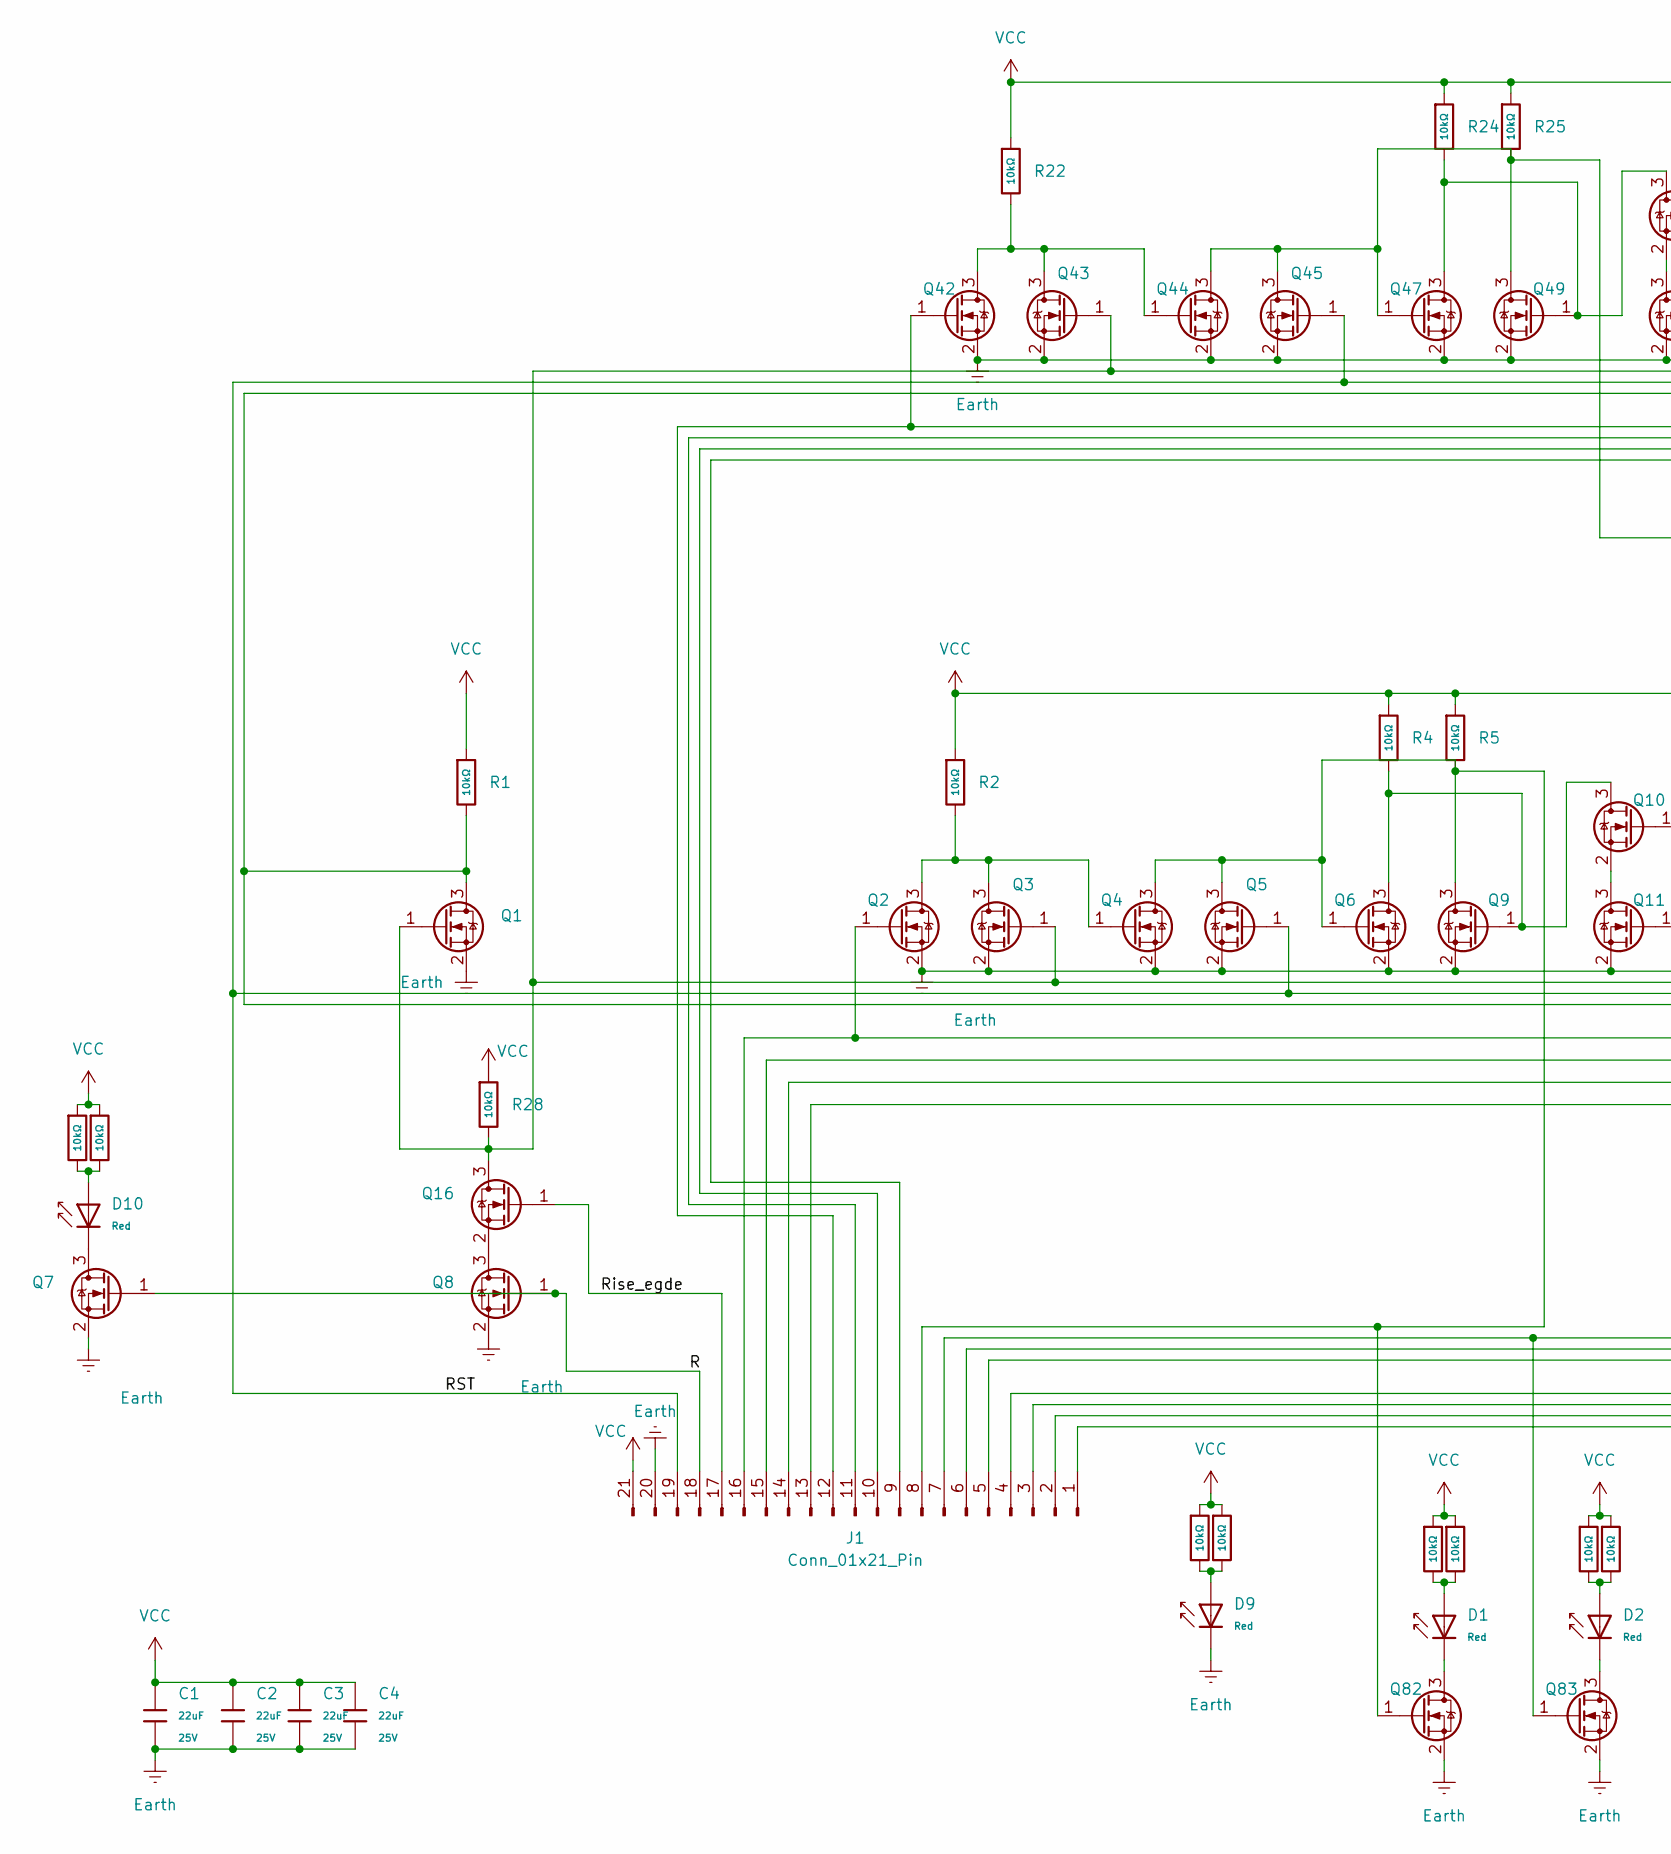
[picture p14: schematic REG8bit-SMD-V5.0.kicad_sch, part in row 1, column 1]

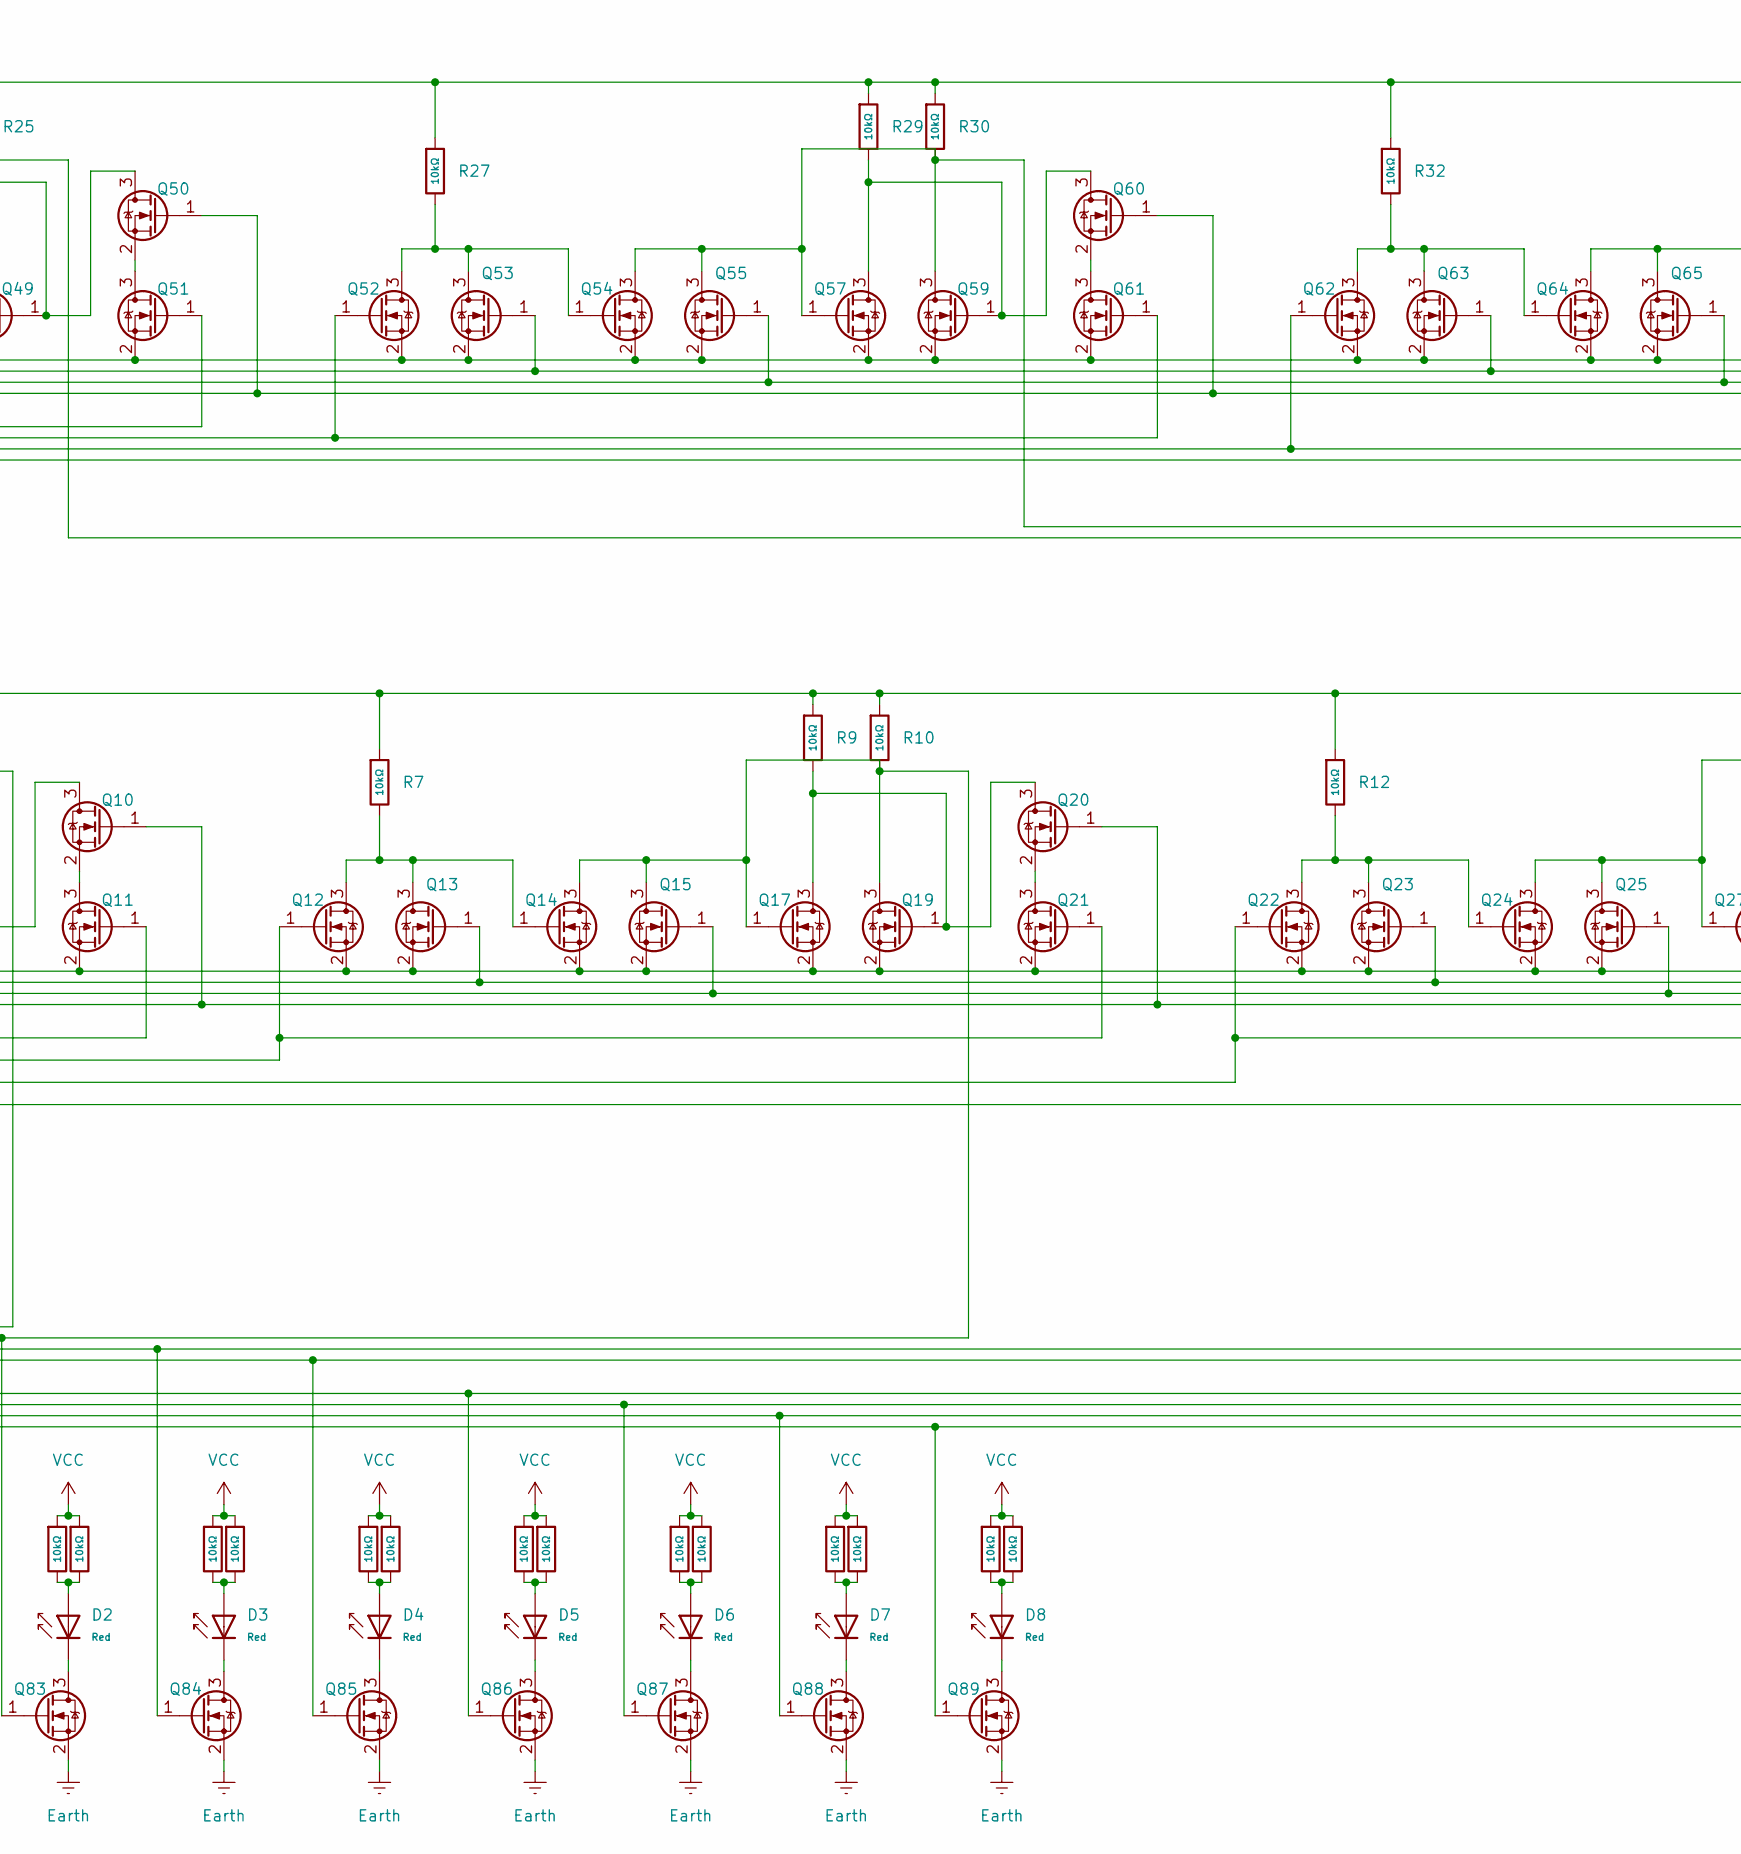
[picture p15: schematic REG8bit-SMD-V5.0.kicad_sch, part in row 1, column 2]

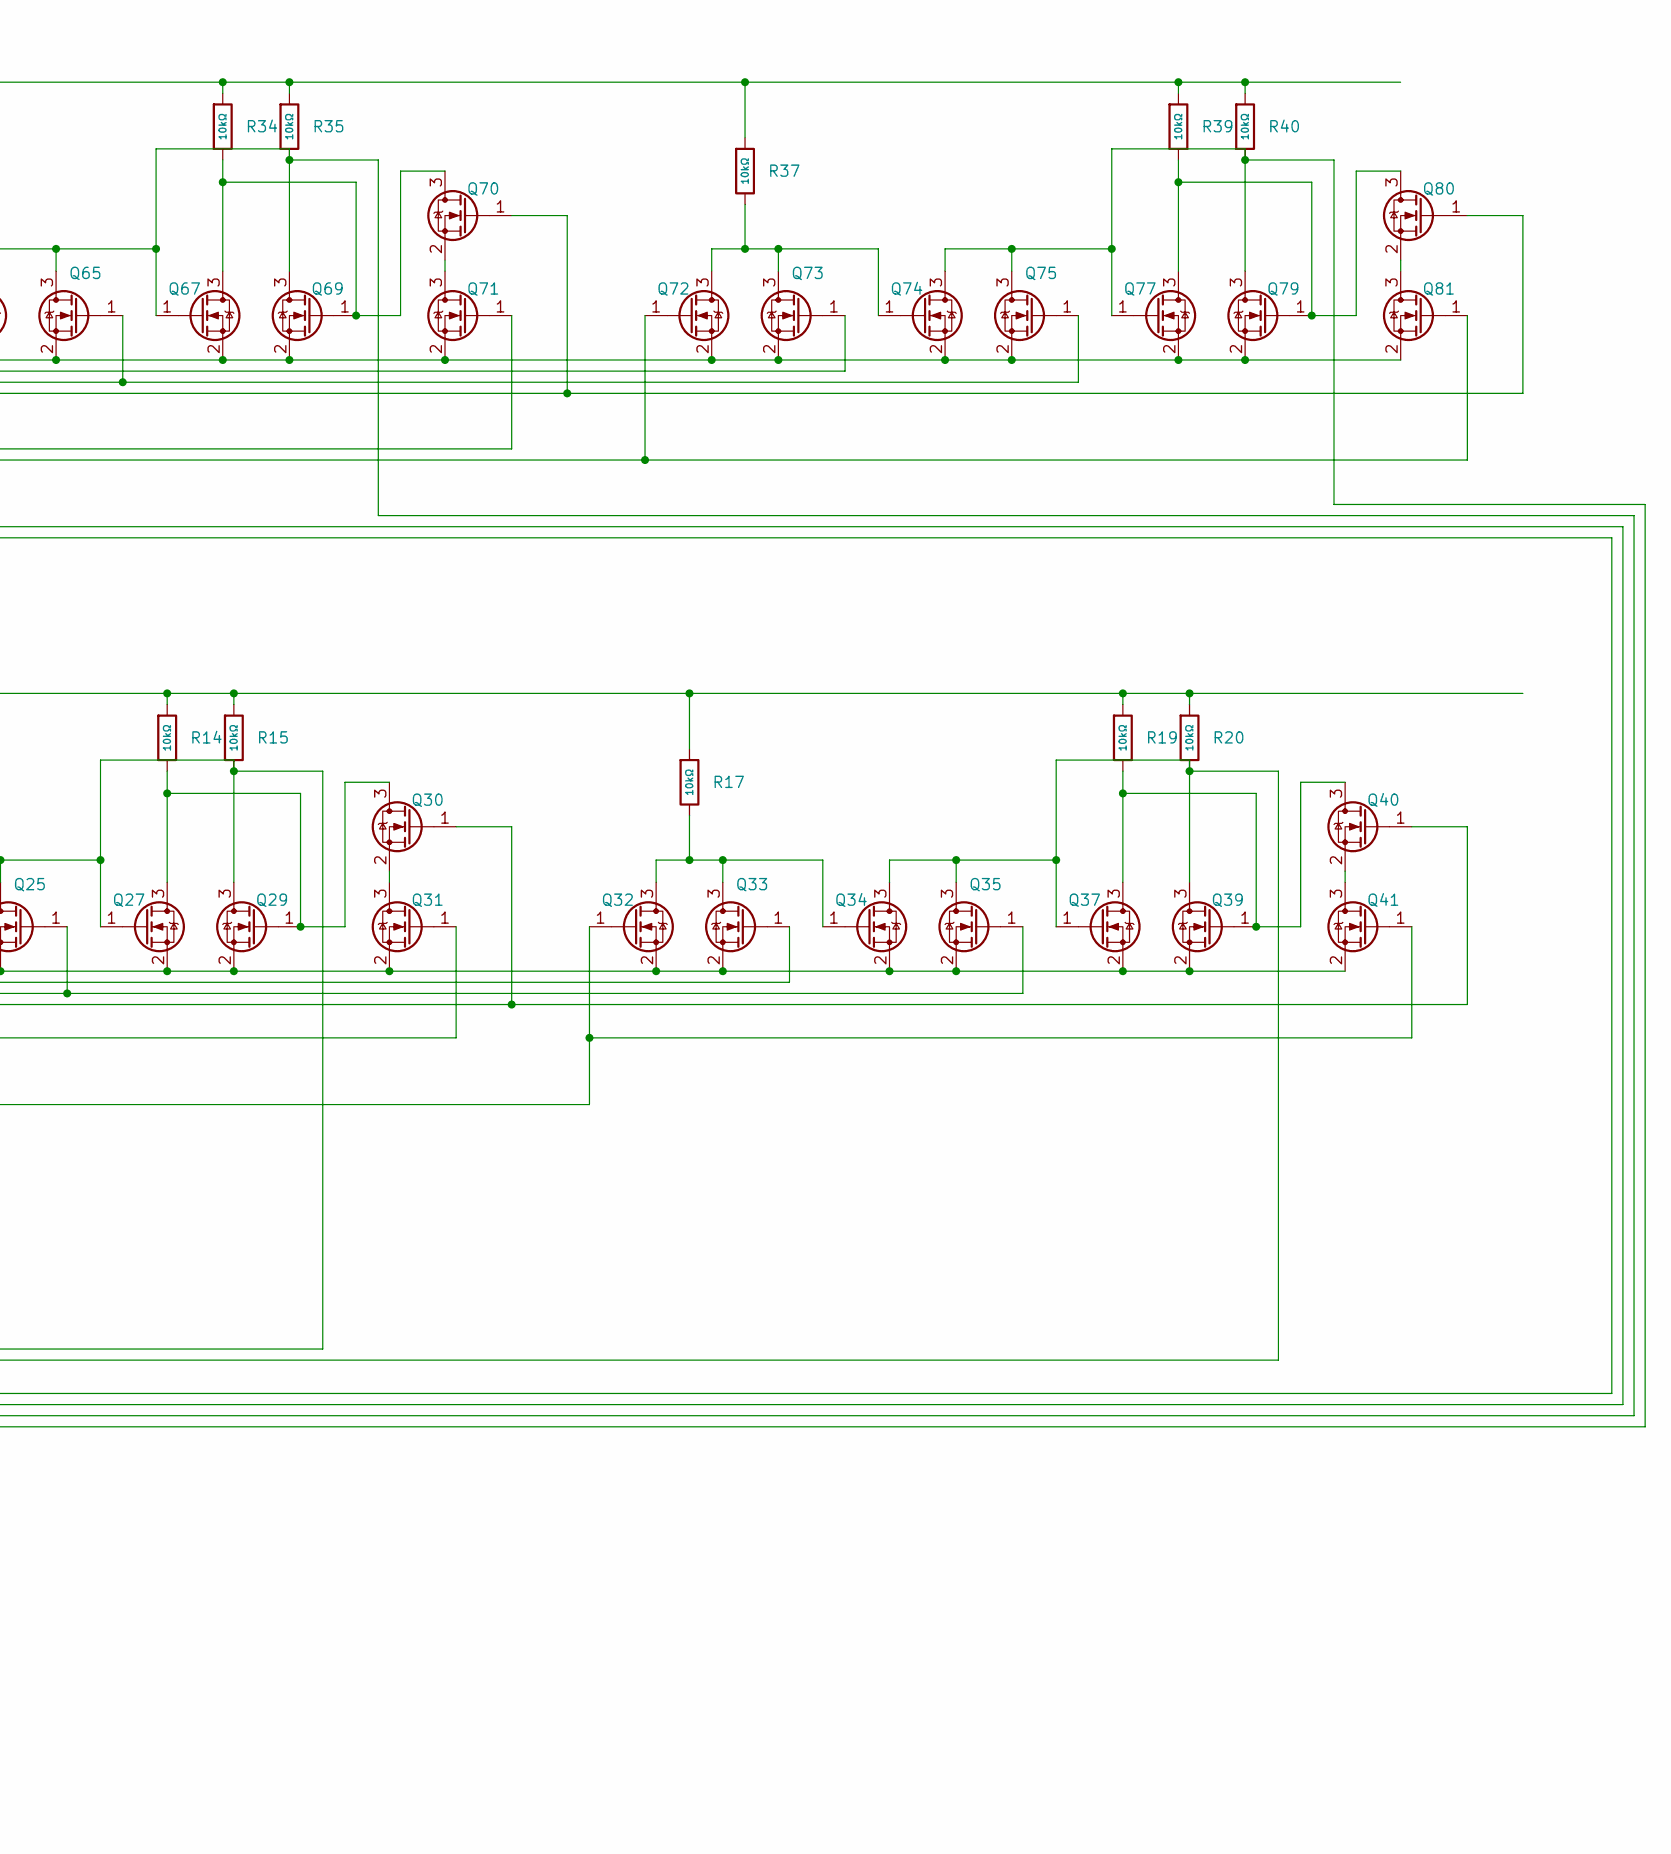
[picture p16: schematic REG8bit-SMD-V5.0.kicad_sch, part in row 1, column 3]

Parts:
C1, C2, C3, C4: 22uF; C_0805; Voltage Rated 25V; Tolerance ±20%; Part CL21A226MAQNNNE; LCSC C45783
D1, D2, D3, D4, D5, D6, D7, D8, D9, D10: Red; D_0603; Part KT-0603R; LCSC C2286
J1: Conn_01x21_Pin; PinHeader_1x21_P2.54mm_Horizontal
Q1, Q2, Q3, Q4, Q5, Q6, Q7, Q8, Q9, Q10, Q11, Q12, Q13, Q14, Q15, Q16, Q17, Q19, Q20, Q21, Q22, Q23, Q24, Q25, Q27, Q29, Q30, Q31, Q32, Q33, Q34, Q35, Q37, Q39, Q40, Q41, Q42, Q43, Q44, Q45, Q47, Q49, Q50, Q51, Q52, Q53, Q54, Q55, Q57, Q59, Q60, Q61, Q62, Q63, Q64, Q65, Q67, Q69, Q70, Q71, Q72, Q73, Q74, Q75, Q77, Q79, Q80, Q81, Q82, Q83, Q84, Q85, Q86, Q87, Q88, Q89: 2N7002; SOT-23
R1, R2, R3, R4, R5, R6, R7, R8, R9, R10, R11, R12, R13, R14, R15, R16, R17, R18, R19, R20, R21, R22, R23, R24, R25, R26, R27, R28, R29, R30, R31, R32, R33, R34, R35, R36, R37, R38, R39, R40, R41, R42, R43, R44, R45, R46: 10kΩ; R_0402; Overload Voltage (Max) 50V; Tolerance ±1%; Part 0402WGF2002TCE; LCSC C25765

Connections:
/R: J1.18, Q7.1 (G), Q8.1 (G)
/RST: J1.19, Q5.1 (G), Q15.1 (G), Q25.1 (G), Q35.1 (G), Q45.1 (G), Q55.1 (G), Q65.1 (G), Q75.1 (G)
/Rise_egde: J1.17, Q16.1 (G)
Earth: C1.2, C2.2, C3.2, C4.2, D9.1, J1.20, Q1.2 (S), Q2.2 (S), Q3.2 (S), Q4.2 (S), Q5.2 (S), Q6.2 (S), Q7.2 (S), Q8.2 (S), Q9.2 (S), Q11.2 (S), Q12.2 (S), Q13.2 (S), Q14.2 (S), Q15.2 (S), Q17.2 (S), Q19.2 (S), Q21.2 (S), Q22.2 (S), Q23.2 (S), Q24.2 (S), Q25.2 (S), Q27.2 (S), Q29.2 (S), Q31.2 (S), Q32.2 (S), Q33.2 (S), Q34.2 (S), Q35.2 (S), Q37.2 (S), Q39.2 (S), Q41.2 (S), Q42.2 (S), Q43.2 (S), Q44.2 (S), Q45.2 (S), Q47.2 (S), Q49.2 (S), Q51.2 (S), Q52.2 (S), Q53.2 (S), Q54.2 (S), Q55.2 (S), Q57.2 (S), Q59.2 (S), Q61.2 (S), Q62.2 (S), Q63.2 (S), Q64.2 (S), Q65.2 (S), Q67.2 (S), Q69.2 (S), Q71.2 (S), Q72.2 (S), Q73.2 (S), Q74.2 (S), Q75.2 (S), Q77.2 (S), Q79.2 (S), Q81.2 (S), Q82.2 (S), Q83.2 (S), Q84.2 (S), Q85.2 (S), Q86.2 (S), Q87.2 (S), Q88.2 (S), Q89.2 (S)
unnamed: D1.2, R8.2, R11.2
unnamed: D2.2, R13.2, R16.2
unnamed: D3.2, R18.2, R21.2
unnamed: D4.2, R23.2, R31.2
unnamed: D5.2, R33.2, R36.2
unnamed: D6.2, R38.2, R41.2
unnamed: D7.2, R42.2, R43.2
unnamed: D8.2, R44.2, R45.2
unnamed: D9.2, R3.2, R6.2
unnamed: D10.2, R26.2, R46.2
unnamed: J1.1, Q74.3 (D), Q75.3 (D), Q77.1 (G), Q79.3 (D), Q89.1 (G), R40.2
unnamed: J1.2, Q64.3 (D), Q65.3 (D), Q67.1 (G), Q69.3 (D), Q88.1 (G), R35.2
unnamed: J1.3, Q54.3 (D), Q55.3 (D), Q57.1 (G), Q59.3 (D), Q87.1 (G), R30.2
unnamed: J1.4, Q44.3 (D), Q45.3 (D), Q47.1 (G), Q49.3 (D), Q86.1 (G), R25.2
unnamed: J1.5, Q34.3 (D), Q35.3 (D), Q37.1 (G), Q39.3 (D), Q85.1 (G), R20.2
unnamed: J1.6, Q24.3 (D), Q25.3 (D), Q27.1 (G), Q29.3 (D), Q84.1 (G), R15.2
unnamed: J1.7, Q14.3 (D), Q15.3 (D), Q17.1 (G), Q19.3 (D), Q83.1 (G), R10.2
unnamed: J1.8, Q4.3 (D), Q5.3 (D), Q6.1 (G), Q9.3 (D), Q82.1 (G), R5.2
unnamed: J1.9, Q72.1 (G), Q81.1 (G)
unnamed: J1.10, Q62.1 (G), Q71.1 (G)
unnamed: J1.11, Q52.1 (G), Q61.1 (G)
unnamed: J1.12, Q42.1 (G), Q51.1 (G)
unnamed: J1.13, Q32.1 (G), Q41.1 (G)
unnamed: J1.14, Q22.1 (G), Q31.1 (G)
unnamed: J1.15, Q12.1 (G), Q21.1 (G)
unnamed: J1.16, Q2.1 (G), Q11.1 (G)
unnamed: Q1.3 (D), Q10.1 (G), Q20.1 (G), Q30.1 (G), Q40.1 (G), Q50.1 (G), Q60.1 (G), Q70.1 (G), Q80.1 (G), R1.2
unnamed: Q1.1 (G), Q3.1 (G), Q13.1 (G), Q16.3 (D), Q23.1 (G), Q33.1 (G), Q43.1 (G), Q53.1 (G), Q63.1 (G), Q73.1 (G), R28.2
unnamed: Q2.3 (D), Q3.3 (D), Q4.1 (G), R2.2
unnamed: D10.1, Q7.3 (D)
unnamed: Q6.3 (D), Q9.1 (G), Q10.3 (D), R4.2
unnamed: Q10.2 (S), Q11.3 (D)
unnamed: Q12.3 (D), Q13.3 (D), Q14.1 (G), R7.2
unnamed: Q8.3 (D), Q16.2 (S)
unnamed: Q17.3 (D), Q19.1 (G), Q20.3 (D), R9.2
unnamed: Q20.2 (S), Q21.3 (D)
unnamed: Q22.3 (D), Q23.3 (D), Q24.1 (G), R12.2
unnamed: Q27.3 (D), Q29.1 (G), Q30.3 (D), R14.2
unnamed: Q30.2 (S), Q31.3 (D)
unnamed: Q32.3 (D), Q33.3 (D), Q34.1 (G), R17.2
unnamed: Q37.3 (D), Q39.1 (G), Q40.3 (D), R19.2
unnamed: Q40.2 (S), Q41.3 (D)
unnamed: Q42.3 (D), Q43.3 (D), Q44.1 (G), R22.2
unnamed: Q47.3 (D), Q49.1 (G), Q50.3 (D), R24.2
unnamed: Q50.2 (S), Q51.3 (D)
unnamed: Q52.3 (D), Q53.3 (D), Q54.1 (G), R27.2
unnamed: Q57.3 (D), Q59.1 (G), Q60.3 (D), R29.2
unnamed: Q60.2 (S), Q61.3 (D)
unnamed: Q62.3 (D), Q63.3 (D), Q64.1 (G), R32.2
unnamed: Q67.3 (D), Q69.1 (G), Q70.3 (D), R34.2
unnamed: Q70.2 (S), Q71.3 (D)
unnamed: Q72.3 (D), Q73.3 (D), Q74.1 (G), R37.2
unnamed: Q77.3 (D), Q79.1 (G), Q80.3 (D), R39.2
unnamed: Q80.2 (S), Q81.3 (D)
unnamed: D1.1, Q82.3 (D)
unnamed: D2.1, Q83.3 (D)
unnamed: D3.1, Q84.3 (D)
unnamed: D4.1, Q85.3 (D)
unnamed: D5.1, Q86.3 (D)
unnamed: D6.1, Q87.3 (D)
unnamed: D7.1, Q88.3 (D)
unnamed: D8.1, Q89.3 (D)
VCC: C1.1, C2.1, C3.1, C4.1, J1.21, R1.1, R2.1, R3.1, R4.1, R5.1, R6.1, R7.1, R8.1, R9.1, R10.1, R11.1, R12.1, R13.1, R14.1, R15.1, R16.1, R17.1, R18.1, R19.1, R20.1, R21.1, R22.1, R23.1, R24.1, R25.1, R26.1, R27.1, R28.1, R29.1, R30.1, R31.1, R32.1, R33.1, R34.1, R35.1, R36.1, R37.1, R38.1, R39.1, R40.1, R41.1, R42.1, R43.1, R44.1, R45.1, R46.1

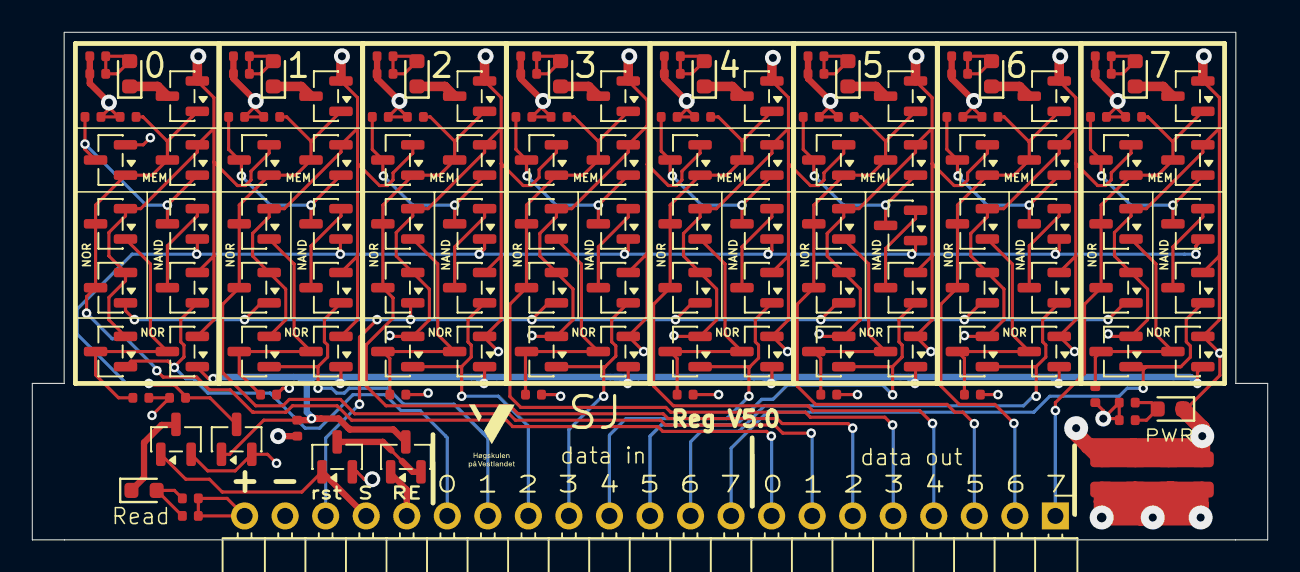
[picture p17: board REG8bit-SMD-V5.0.kicad_pcb from above]

Board: 4 copper layers, 77.4 x 31.8 mm, 137 parts (0 on the bottom side), 67 nets.
