SonJonsr/Custom-8bit-CPU/PCB_S/REG8bit-SMD-V3.0/testproj/testproj.kicad_pcb

## KiCad design PCB_S/REG8bit-SMD-V3.0/testproj/testproj.kicad_pcb (2026-02-04, an earlier design)

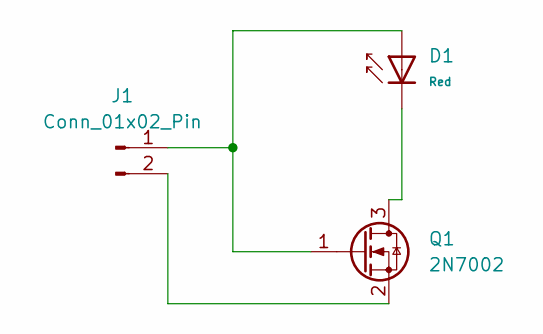
[picture p18: schematic testproj.kicad_sch]

Parts:
D1: Red; D_0805; Forward Voltage (VF) 1.6V~2.6V; Part NCD0805R1; LCSC C84256
J1: Conn_01x02_Pin; AMASS_XT30PW-F_1x02_P2.50mm_Horizontal
Q1: 2N7002; SOT-23

Connections:
unnamed: D1.2, J1.1, Q1.1 (G)
unnamed: J1.2, Q1.2 (S)
unnamed: D1.1, Q1.3 (D)
