SonJonsr/Custom-8bit-CPU/PCB_S/REG8bit-SMD-V3.0/testproj/testproj.kicad_pcb

## KiCad design PCB_S/REG8bit-SMD-V3.0/testproj/testproj.kicad_pcb (continued)

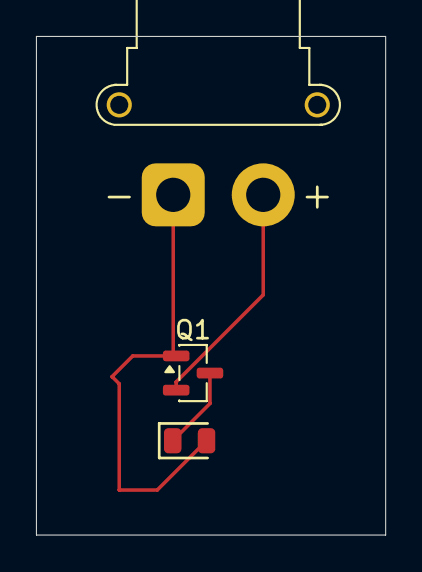
[picture p19: board testproj.kicad_pcb from above]

Board: 2 copper layers, 19.4 x 27.7 mm, 3 parts (0 on the bottom side), 3 nets.
