SonJonsr/Custom-8bit-CPU/CPU_Bachelor_2_0/db/bCPU.smp_dump.txt

State Machine - |bCPU_top|LCD_Display:LCD_Display_inst|next_command
Name next_command.DISPLAY_CLEAR next_command.DISPLAY_OFF next_command.RESET3 next_command.HOLD next_command.RESET1 next_command.DROP_LCD_E next_command.RETURN_HOME next_command.LINE2 next_command.Print_String next_command.MODE_SET next_command.DISPLAY_ON next_command.FUNC_SET next_command.RESET2 
next_command.RESET2 0 0 0 0 0 0 0 0 0 0 0 0 0 
next_command.FUNC_SET 0 0 0 0 0 0 0 0 0 0 0 1 1 
next_command.DISPLAY_ON 0 0 0 0 0 0 0 0 0 0 1 0 1 
next_command.MODE_SET 0 0 0 0 0 0 0 0 0 1 0 0 1 
next_command.Print_String 0 0 0 0 0 0 0 0 1 0 0 0 1 
next_command.LINE2 0 0 0 0 0 0 0 1 0 0 0 0 1 
next_command.RETURN_HOME 0 0 0 0 0 0 1 0 0 0 0 0 1 
next_command.DROP_LCD_E 0 0 0 0 0 1 0 0 0 0 0 0 1 
next_command.RESET1 0 0 0 0 1 0 0 0 0 0 0 0 1 
next_command.HOLD 0 0 0 1 0 0 0 0 0 0 0 0 1 
next_command.RESET3 0 0 1 0 0 0 0 0 0 0 0 0 1 
next_command.DISPLAY_OFF 0 1 0 0 0 0 0 0 0 0 0 0 1 
next_command.DISPLAY_CLEAR 1 0 0 0 0 0 0 0 0 0 0 0 1 

State Machine - |bCPU_top|LCD_Display:LCD_Display_inst|state
Name state.DISPLAY_CLEAR state.DISPLAY_OFF state.RESET3 state.RESET2 state.HOLD state.DROP_LCD_E state.RETURN_HOME state.LINE2 state.Print_String state.MODE_SET state.DISPLAY_ON state.FUNC_SET state.RESET1 
state.RESET1 0 0 0 0 0 0 0 0 0 0 0 0 0 
state.FUNC_SET 0 0 0 0 0 0 0 0 0 0 0 1 1 
state.DISPLAY_ON 0 0 0 0 0 0 0 0 0 0 1 0 1 
state.MODE_SET 0 0 0 0 0 0 0 0 0 1 0 0 1 
state.Print_String 0 0 0 0 0 0 0 0 1 0 0 0 1 
state.LINE2 0 0 0 0 0 0 0 1 0 0 0 0 1 
state.RETURN_HOME 0 0 0 0 0 0 1 0 0 0 0 0 1 
state.DROP_LCD_E 0 0 0 0 0 1 0 0 0 0 0 0 1 
state.HOLD 0 0 0 0 1 0 0 0 0 0 0 0 1 
state.RESET2 0 0 0 1 0 0 0 0 0 0 0 0 1 
state.RESET3 0 0 1 0 0 0 0 0 0 0 0 0 1 
state.DISPLAY_OFF 0 1 0 0 0 0 0 0 0 0 0 0 1 
state.DISPLAY_CLEAR 1 0 0 0 0 0 0 0 0 0 0 0 1 
