SonJonsr/Custom-8bit-CPU/FPGA_ROT/motherboard_ver_1/motherboard.vhd

library ieee;
use ieee.std_logic_1164.all;
use ieee.numeric_std.all;

entity motherboard is
  generic(
    adr_keyboard_ascii  : std_logic_vector(15 downto 0) := x"92C1";
    adr_keyboard_info   : std_logic_vector(15 downto 0) := x"92C2";
    adr_random          : std_logic_vector(15 downto 0) := x"92C3";
    adr_timer_millis_ll : std_logic_vector(15 downto 0) := x"92C4";
    adr_timer_millis_hh : std_logic_vector(15 downto 0) := x"92C5";
    adr_eeprom_start    : std_logic_vector(15 downto 0) := x"92C6";
    adr_eeprom_end      : std_logic_vector(15 downto 0) := x"93C5"
  );
  port (
    CLOCK_50 : in  std_logic;
    CLOCK_25 : in  std_logic;
    KEY : in  std_logic_vector(3 downto 0);
    SW  : in  std_logic_vector(17 downto 0);

    GPIO      : inout std_logic_vector(0 to 35); 

    -- EEPROM I2C ports
    EEP_I2C_SCLK  : out std_logic;
    EEP_I2C_SDAT  : inout std_logic;

    PS2_CLK : in std_logic;
    PS2_DAT : in std_logic;

    HEX0, HEX1, HEX2, HEX3,
    HEX4, HEX5, HEX6, HEX7 : out std_logic_vector(6 downto 0) := (others => '0');

    -- VGA
    VGA_CLK     : out std_logic;
    VGA_BLANK_N : out std_logic;
    VGA_SYNC_N  : out std_logic;
    VGA_HS      : out std_logic;
    VGA_VS      : out std_logic;
    VGA_R       : out std_logic_vector(7 downto 0);
    VGA_G       : out std_logic_vector(7 downto 0);
    VGA_B       : out std_logic_vector(7 downto 0);

		LCD_RS, LCD_EN	: OUT	  STD_LOGIC;
		LCD_RW			    : OUT   STD_LOGIC;
		LCD_DATA		    : INOUT	STD_LOGIC_VECTOR(7 DOWNTO 0)
  );
end entity;

architecture RTL of motherboard is
component memory is
  port (
    clk_a, clk_b : in  std_logic;

    -- Port A: 8-bit for CPU
    addr_a       : in  std_logic_vector(15 downto 0);
    data_in_a    : in  std_logic_vector(7 downto 0);
    we_a         : in  std_logic;
    data_out_a   : out std_logic_vector(7 downto 0);

    -- Port B: 16-bit for Screencard
    addr_b       : in  std_logic_vector(15 downto 0);
    data_out_b   : out std_logic_vector(7 downto 0)
  );
end component;
  component memory_support is
    generic(
      adr_keyboard_ascii  : std_logic_vector(15 downto 0) := x"92C1";
      adr_keyboard_info   : std_logic_vector(15 downto 0) := x"92C2";
      adr_random          : std_logic_vector(15 downto 0) := x"92C3";
      adr_timer_millis_ll : std_logic_vector(15 downto 0) := x"92C4";
      adr_timer_millis_hh : std_logic_vector(15 downto 0) := x"92C5";
      adr_eeprom_start    : std_logic_vector(15 downto 0) := x"92C6";
      adr_eeprom_end      : std_logic_vector(15 downto 0) := x"93C5"
    );
    port (
      clk           : in  std_logic;
      rst_n         : in  std_logic;
      clk_slow      : in  std_logic;

      timer_millis    : in  std_logic_vector(15 downto 0);
      random_byte     : in  std_logic_vector(7 downto 0);
      keyboard_data   : in  std_logic_vector(7 downto 0);
      keyboard_rdy    : in  std_logic := '0';
      keyboard_en     : out std_logic := '0';
      keyboard_rw     : out std_logic := '0';
      keyboard_as     : out std_logic := '0';

      cpu_rw        : in  std_logic;
      cpu_address   : in  std_logic_vector(15 downto 0);
      cpu_data_out  : in  std_logic_vector(7 downto 0);
      cpu_data_in   : out std_logic_vector(7 downto 0);

      mem_wren      : out std_logic := '0';
      mem_data_out  : in  std_logic_vector(7 downto 0);
      mem_data_in   : out std_logic_vector(7 downto 0) := x"00";
      mem_address   : out std_logic_vector(15 downto 0) := x"0000";

      eeprom_rw       : out std_logic := '0';
      eeprom_adr      : out std_logic_vector(7 downto 0);
      eeprom_data_in  : out std_logic_vector(7 downto 0);
      eeprom_data_out : in  std_logic_vector(7 downto 0)
    );
  end component;
  component PS2_MODUL IS
    PORT ( 
      -- Inputs from clk & rst_n
      clk   : IN STD_LOGIC; 
      rst_n : IN STD_LOGIC;

      -- Inputs from PS/2
      ps2_clk : IN STD_LOGIC;
      ps2_dat : IN STD_LOGIC;

      -- Inputs from memory
      en            : IN STD_LOGIC;
      rw            : IN STD_LOGIC;
      array_select  : IN STD_LOGIC;

      -- Outputs
      rdy   : OUT STD_LOGIC := '0';
      ascii : OUT STD_LOGIC_VECTOR(7 downto 0) := x"00"
    );
  END component;
  component clock_controller is
    port (
      clk : in std_logic;
      rst_n : in std_logic;

      btn : in std_logic;
      mode : in std_logic;
      
      clock_speed_select  : in std_logic_vector(3 downto 0);
      duty_cycle_select   : in std_logic_vector(3 downto 0);

      clk_slow : out std_logic := '0'
    );
  end component;
  component eeprom_manager is
    port(
      clk	  : in	std_logic;
      rst_n : in	std_logic;

      -- from cpu
      rw        : in  std_logic;
      adr       : in  std_logic_vector(7 downto 0);
      data_in   : in  std_logic_vector(7 downto 0);
      data_out  : out std_logic_vector(7 downto 0);

      -- EEPROM I2C ports
      EEP_I2C_SCLK  : out std_logic;
      EEP_I2C_SDAT  : inout std_logic
    );
  end component;
  component random is
    port(
      clk   : in  std_logic;
      rst_n : in  std_logic;
      random_byte : out std_logic_vector(7 downto 0) := x"FF"
    );
  end component;
  component screencard IS
    GENERIC(
    -- Display memory start
      main_display_adr : unsigned(15 downto 0) := "1000000000000000";
      info_display_adr : unsigned(15 downto 0) := "1000111100000000";
    -- Horizontal
      h_pixels : INTEGER := 640;
      h_front_porch : INTEGER := 16;
      h_sync_pulse : INTEGER := 96;
      h_back_porch : INTEGER := 48;
      h_polarity : STD_LOGIC := '0';
    -- Vertical
      v_pixels : INTEGER := 480;
      v_front_porch : INTEGER := 10;
      v_sync_pulse : INTEGER := 2;
      v_back_porch : INTEGER := 33;
      v_polarity : STD_LOGIC := '0'
    );
    PORT ( 
      pixel_clk   : IN STD_LOGIC;
      rst_n       : IN STD_LOGIC;

      -- Interface med minnet
      dat         : IN  STD_LOGIC_VECTOR(7 downto 0);
      adr         : OUT STD_LOGIC_VECTOR(15 downto 0);
      
      -- Interface med VGA-kabel
      VGA_CLK     : OUT STD_LOGIC;
      VGA_BLANK_N : OUT STD_LOGIC;
      VGA_SYNC_N  : OUT STD_LOGIC;
      VGA_HS      : OUT STD_LOGIC;
      VGA_VS      : OUT STD_LOGIC;
      VGA_R       : OUT STD_LOGIC_VECTOR(7 downto 0);
      VGA_G       : OUT STD_LOGIC_VECTOR(7 downto 0);
      VGA_B       : OUT STD_LOGIC_VECTOR(7 downto 0)
    );
  END component;
  component timer_millis is
    generic(
      -- CLOCK_SPEED MUST BE HIGHER THAN 1kHz
      CLOCK_SPEED : INTEGER := 50_000_000
    );
    port(
      clk   : in  std_logic;
      rst_n : in  std_logic;
      millis : out std_logic_vector(15 downto 0) := (others => '0')
    );
  end component;
  component antibounce_key is
    port(
      clk             : in std_logic;
      rst_n           : in std_logic;
      key             : in std_logic;
      key_antibounced : out std_logic := '1'
    );
  end component;



  signal cpu_rw       : std_logic;
  signal cpu_address  : std_logic_vector(15 downto 0);
  signal cpu_data_in  : std_logic_vector(7 downto 0);
  signal cpu_data_out : std_logic_vector(7 downto 0);

  signal mem_wren      : std_logic;
  signal mem_data_out  : std_logic_vector(7 downto 0);
  signal mem_data_in   : std_logic_vector(7 downto 0);
  signal mem_address   : std_logic_vector(15 downto 0);
  
  signal keyboard_data : std_logic_vector(7 downto 0);
  signal keyboard_rdy  : std_logic;
  signal keyboard_en   : std_logic;
  signal keyboard_rw   : std_logic;
  signal keyboard_as   : std_logic;

  signal eeprom_rw  : std_logic;
  signal eeprom_data_in : std_logic_vector(7 downto 0);
  signal eeprom_data_out : std_logic_vector(7 downto 0);
  signal eeprom_adr : std_logic_vector(7 downto 0);

  signal screencard_dat : std_logic_vector(7 downto 0);
  signal screencard_adr : std_logic_vector(15 downto 0);

  signal millis : std_logic_vector(15 downto 0);

  signal random_byte : std_logic_vector(7 downto 0);

  signal gpio_dff : std_logic_vector(0 to 35);

  signal clk_slow : std_logic := '0';

begin

  GPIO(8) <= 'Z';
  GPIO(10 to 25) <= (others => 'Z');
  GPIO(9) <= not clk_slow;
  GPIO(26 to 33) <= (others => 'Z') when gpio_dff(8) = '0' else cpu_data_in;

  process(CLOCK_50) is
  begin
    gpio_dff <= GPIO;
    GPIO(6) <= not KEY(3);

    cpu_rw      <= not gpio_dff(8);
    cpu_address <= gpio_dff(10 to 25);

    if gpio_dff(8) = '0' then 
      cpu_data_out  <= gpio_dff(26 to 33);
    end if;
  end process;

  memory_support_inst: memory_support
   generic map(
      adr_keyboard_ascii => adr_keyboard_ascii,
      adr_keyboard_info => adr_keyboard_info,
      adr_random => adr_random,
      adr_timer_millis_ll => adr_timer_millis_ll,
      adr_timer_millis_hh => adr_timer_millis_hh,
      adr_eeprom_start => adr_eeprom_start,
      adr_eeprom_end => adr_eeprom_end
  )
   port map(
      clk => CLOCK_50,
      rst_n => KEY(3),
      clk_slow => not clk_slow,
      timer_millis => millis,
      random_byte => random_byte,
      keyboard_data => keyboard_data,
      keyboard_rdy => keyboard_rdy,
      keyboard_en => keyboard_en,
      keyboard_rw => keyboard_rw,
      keyboard_as => keyboard_as,
      cpu_rw => cpu_rw,
      cpu_address => cpu_address,
      cpu_data_in => cpu_data_in,
      cpu_data_out => cpu_data_out,
      mem_wren => mem_wren,
      mem_data_out => mem_data_out,
      mem_data_in => mem_data_in,
      mem_address => mem_address,
      eeprom_rw => eeprom_rw,
      eeprom_adr => eeprom_adr,
      eeprom_data_in => eeprom_data_in,
      eeprom_data_out => eeprom_data_out
  );  
  memory_inst: memory
   port map(
      clk_a => CLOCK_50,
      clk_b => CLOCK_25,
      addr_a => mem_address,
      data_in_a => mem_data_in,
      we_a => mem_wren,
      data_out_a => mem_data_out,
      addr_b => screencard_adr,
      data_out_b => screencard_dat
  );
  eeprom_manager_inst: eeprom_manager
   port map(
      clk => CLOCK_50,
      rst_n => KEY(3),
      rw => eeprom_rw,
      adr => eeprom_adr,
      data_in => eeprom_data_in,
      data_out => eeprom_data_out,
      EEP_I2C_SCLK => EEP_I2C_SCLK,
      EEP_I2C_SDAT => EEP_I2C_SDAT
  );
  clock_controller_inst: clock_controller
   port map(
      clk => CLOCK_50,
      rst_n => KEY(3),
      btn => KEY(0),
      mode => SW(8),
      clock_speed_select => SW(3 downto 0),
      duty_cycle_select => SW(7 downto 4),
      clk_slow => clk_slow
  );
  timer_millis_inst: timer_millis
   generic map(
      CLOCK_SPEED => 50_000_000 
  )
   port map(
      clk => CLOCK_50,
      rst_n => KEY(3),
      millis => millis
  );
  random_inst: random
   port map(
      clk => CLOCK_50,
      rst_n => KEY(3),
      random_byte => random_byte
  );
  PS2_MODUL_inst: PS2_MODUL
   port map(
      clk => CLOCK_50,
      rst_n => KEY(3),
      ps2_clk => PS2_CLK,
      ps2_dat => PS2_DAT,
      en => keyboard_en,
      rw => keyboard_rw,
      array_select => keyboard_as,
      rdy => keyboard_rdy,
      ascii => keyboard_data
  );
  screencard_inst: screencard
   port map(    
      pixel_clk => CLOCK_25,
      rst_n => KEY(3),
      dat => screencard_dat,
      adr => screencard_adr,
      VGA_CLK => VGA_CLK,
      VGA_BLANK_N => VGA_BLANK_N,
      VGA_SYNC_N => VGA_SYNC_N,
      VGA_HS => VGA_HS,
      VGA_VS => VGA_VS,
      VGA_R => VGA_R,
      VGA_G => VGA_G,
      VGA_B => VGA_B
  );


end architecture;
