SonJonsr/Custom-8bit-CPU/FPGA_ROT/screencard_memory_testbench/font.vhd

LIBRARY IEEE;
USE IEEE.STD_LOGIC_1164.ALL;
USE IEEE.NUMERIC_STD.ALL;

ENTITY font IS
  PORT ( 
    ascii_ucode : IN  STD_LOGIC_VECTOR(7 DOWNTO 0);     -- ASCII-hex for ønsket karakter
    row         : IN  INTEGER RANGE 15 DOWNTO 0;
    char_line   : OUT STD_LOGIC_VECTOR(7 DOWNTO 0)
  );
END ENTITY;

ARCHITECTURE RTL OF font IS
  TYPE FONT_ARRAY_TYPE IS ARRAY (0 to 255, 0 to 15) OF STD_LOGIC_VECTOR(0 to 7);
  SIGNAL font_array : FONT_ARRAY_TYPE :=(
  -- 0x0
    (
      "00000000",
      "00000000",
      "00000000",
      "00000000",
      "00000000",
      "00000000",
      "00000000",
      "00000000",
      "00000000",
      "00000000",
      "00000000",
      "00000000",
      "00000000",
      "00000000",
      "00000000",
      "00000000"
    ),
  -- 0x1
    (
      "00000000",
      "00000000",
      "01111110",
      "10000001",
      "10100101",
      "10000001",
      "10000001",
      "10111101",
      "10011001",
      "10000001",
      "10000001",
      "01111110",
      "00000000",
      "00000000",
      "00000000",
      "00000000"
    ),
  -- 0x2
    (
      "00000000",
      "00000000",
      "01111110",
      "11111111",
      "11011011",
      "11111111",
      "11111111",
      "11000011",
      "11100111",
      "11111111",
      "11111111",
      "01111110",
      "00000000",
      "00000000",
      "00000000",
      "00000000"
    ),
  -- 0x3
    (
      "00000000",
      "00000000",
      "00000000",
      "00000000",
      "01101100",
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
      "11111111",
      "11111111",
      "11111111",
      "11111111",
      "11111111",
      "11111111",
      "11111111",
      "11111111",
      "11111111",
      "11111111",
      "11111111"
    ));
BEGIN
    char_line <= font_array(to_integer(unsigned(ascii_ucode)),row);
END RTL;  
