SonJonsr/Custom-8bit-CPU/FPGA_ROT/timer/timer.vhd

library ieee;
use ieee.std_logic_1164.all;
use ieee.numeric_std.all;

entity timer is
  generic(
    -- CLOCK_SPEED MUST BE HIGHER THAN
    CLOCK_SPEED : INTEGER := 50_000_000
  );
  port(
    clk   : in  std_logic;
    rst_n : in  std_logic;
    timer : out std_logic_vector(15 downto 0) := (others => '0')
  );
end entity;

architecture RTL of timer is
  signal counter : integer := 1;
  signal counter_limit : integer := CLOCK_SPEED / 1000;
  signal timer_sig : unsigned(15 downto 0) := (others => '0');
begin
  process(clk) is
  begin
    if rising_edge(clk) then
      if rst_n = '0' then
        timer <= (others => '0');
        timer_sig <= (others => '0');
        counter <= 1;
      else
        timer <= std_logic_vector(timer_sig);
        if (counter >= counter_limit) then
          timer_sig <= timer_sig + 1;
          counter <= 1;
        else
          counter <= counter + 1;
        end if;
      end if;
    end if;
  end process;
end RTL;
