SonJonsr/Custom-8bit-CPU/FPGA_ROT/register_testbenk_mcu/unsaved/unsaved_inst.v

	unsaved u0 (
		.clk_clk       (<connected-to-clk_clk>),       //   clk.clk
		.reg_key_sig   (<connected-to-reg_key_sig>),   //   reg.key_sig
		.reg_ledg_sig  (<connected-to-reg_ledg_sig>),  //      .ledg_sig
		.reg_sw_sig    (<connected-to-reg_sw_sig>),    //      .sw_sig
		.reset_reset_n (<connected-to-reset_reset_n>)  // reset.reset_n
	);
