SonJonsr/Custom-8bit-CPU/(commit log)

2026-01-20 Added FPGA CPU
    [bCPU.smp_dump.txt, sCPU.csv, stp1.stp, stp1_auto_stripped.stp]
2026-01-20 Making visual studio work
    Fixing the file systems in visual studio
    [test.obj]
2026-01-20 Warnings and errors detection
    [test.obj]
2026-01-21 A lot of fixes to the compiler
    Made a C text splitter that splits up key charecters like + or - and makes spaces in front and behind. example varX=varY+varZ will become varX = varY + varZ. Simplifying the reading process. And implementing more "cross bit" functions
    [Simple_C_output.obj, test.obj]
2026-01-23 CPU works fine now
    changed the fpga CPU
    [stp1.stp, stp1_auto_stripped.stp]
2026-01-25 Starting on the creation of the ALU
    [ALU.kicad_pcb, ALU.kicad_sch]
2026-01-25 testing github for KICAD
    [ALUCOPY_test.kicad_pcb, ALUCOPY_test.kicad_sch]
2026-01-25 Making CPU_V2
    [stp1.stp, stp1_auto_stripped.stp]
2026-01-25 FPGA_CPU_V2 no errors
    [bCPU.smp_dump.txt]
2026-01-28 added registers 8 bit
    [BOM-REG8bit-SMD-V3.0.csv, BOM-REG8bit-SMD.csv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]
2026-01-29 Litt fpga rot
    [stp1.stp, stp1_auto_stripped.stp, vga_adapter.smp_dump.txt, vga_test_av_testbrett.smp_dump.txt, vga_testbrett.smp_dump.txt]
2026-01-30 Gantt mal lagt til
    [Bacheloroppgave - Gantt - Utkast - Vår 2026.ods]
2026-02-03 Legger til Hoved-Gantt-diagram
    [Gant_alt.ods]
2026-02-04 pcb making
    [BOM-REG8bit-SMD-V3.0.csv, BOM-REG8bit-SMD.csv, BOM-testproj.csv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]
2026-02-05 New Register half done
    [REG8bit-SMD-V4.0.kicad_pcb, REG8bit-SMD-V4.0.kicad_sch, REG8bit-SMD-V4.0_IN_process_.kicad_pcb]
2026-02-05 PCB : REG8bit v4 done
    [REG8bit-SMD-V4.0.kicad_pcb]
2026-02-05 sim
    Tried the spice sim : the sim did not work at all
    [REG8bit-SMD-V4.0.kicad_pcb, REG8bit-SMD-V4.0.kicad_sch, REG8bit-V4-sim.kicad_sch]
2026-02-06 8-Bit register is done
    [BOM-REG8bit-SMD-V3.0.csv, BOM-REG8bit-SMD-V4.2.csv, BOM-REG8bit-SMD.csv, REG8bit-SMD-V4.0_IN_process_.kicad_pcb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]
2026-02-12 sendt the reg8bit
    [BOM-REG8bit-SMD-V3.0.csv, BOM-REG8bit-SMD.csv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]
2026-02-17 ALU_V1.0 schematic done
    [ALU-V1.0.kicad_sch, ALU_V1.0.kicad_pcb, ALU_V1.0.kicad_sch]
2026-02-18 ALU_V1.0
    Creating the ALU PCB
    [ALU_V1.0.kicad_pcb, ALU_V1.0.kicad_sch]
2026-02-18 ALU_V1.0 WIP
    PCB size doesnt matter??
    [ALU_V1.0-CuBottom.gbr, ALU_V1.0-CuIn1.gbr, ALU_V1.0-CuIn2.gbr, ALU_V1.0-CuIn3.gbr, ALU_V1.0-CuIn4.gbr, ALU_V1.0-CuTop.gbr, ALU_V1.0-EdgeCuts.gbr, ALU_V1.0-MaskBottom.gbr]
2026-02-20 ALU_V1.0 WIP
    making pcb
    [ALU_V1.0.kicad_pcb, ALU_V1.0.kicad_sch]
2026-02-21 ALU V1.0 done?
    [ALU_V1.0.kicad_pcb, ALU_V1.0.kicad_sch]
2026-02-21 ALU V1.0 more done
    [ALU_V1.0.kicad_pcb, ALU_V1.0.kicad_sch]
2026-02-24 ALU_V1.0 silk
    [ALU_V1.0.kicad_pcb]
2026-02-25 Reg holder v1.0 start
    [Register_Holder_V1.0.kicad_pcb, Register_Holder_V1.0.kicad_sch, aaaaa.kicad_pcb, aaaaa.kicad_sch]
2026-02-25 ALU d
    [ALU_V1.0-CuBottom.gbr, ALU_V1.0-CuIn1.gbr, ALU_V1.0-CuIn2.gbr, ALU_V1.0-CuIn3.gbr, ALU_V1.0-CuIn4.gbr, ALU_V1.0-CuTop.gbr, ALU_V1.0-EdgeCuts.gbr, ALU_V1.0-MaskBottom.gbr]
2026-02-26 REG holder V1.0
    [ALU_V1.0.kicad_pcb, BOM-Register_Holder_V1.0.csv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]
2026-02-26 REG_HOLDER_V1.0 done
    [CPL-Register_Holder_V1.0.csv, Register_Holder_V1.0-CuBottom.gbr, Register_Holder_V1.0-CuIn1.gbr, Register_Holder_V1.0-CuIn2.gbr, Register_Holder_V1.0-CuIn3.gbr, Register_Holder_V1.0-CuIn4.gbr, Register_Holder_V1.0-CuTop.gbr, Register_Holder_V1.0-EdgeCuts.gbr]
2026-03-02 Updated all boards
    change the resistor for all the LEDs and used the 2x8 connector
    [ALU_V2.0-CuBottom.gbr, ALU_V2.0-CuIn1.gbr, ALU_V2.0-CuIn2.gbr, ALU_V2.0-CuIn3.gbr, ALU_V2.0-CuIn4.gbr, ALU_V2.0-CuTop.gbr, ALU_V2.0-EdgeCuts.gbr, ALU_V2.0-MaskBottom.gbr]
2026-03-05 Testing things
    [ALU_V2.0-CuBottom.gbr, ALU_V2.0-CuIn1.gbr, ALU_V2.0-CuIn2.gbr, ALU_V2.0-CuIn3.gbr, ALU_V2.0-CuIn4.gbr, ALU_V2.0-CuTop.gbr, ALU_V2.0-EdgeCuts.gbr, ALU_V2.0-MaskBottom.gbr]
2026-03-10 Cpu controller unit start
    [Controller_Unit_V1.0.kicad_pcb, Controller_Unit_V1.0.kicad_sch]
2026-03-17 Controller V1.0 work
    [Controller_Unit_V1.0.kicad_sch]
2026-03-19 controll uint work
    [Controller_Unit_V1.0.kicad_sch]
2026-03-20 Controller unit v1.0 wip
    [Controller_Unit_V1.0.kicad_sch]
2026-03-22 cercuit done controller unit v1.0 ?
    [Controller_Unit_V1.0.kicad_sch, test.obj]
2026-03-23 Controller unit PCB wip
    [Controller_Unit_V1.0.kicad_pcb, Controller_Unit_V1.0.kicad_sch]
2026-03-27 CONTROLLER UNIT V1.0 done?
    JCL : exceed 2048 error
    [BOM-Controller_Unit_V1.0.csv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]
2026-03-27 CONTROLLER unit v1.0 without a jlc issue
    Switch BOM file to BOM_T2.csv
    [BOM-Controller_Unit_V1.0.csv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]
2026-03-28 FPGA modules: PS2, VGA, PS2_VGA_MEMORY_TESTBENCH. Snake written in C as close to our compiler C as possible
    [Gant_alt.ods]
2026-03-28 Controller unit v1.0 done & Level Shifter fpga v1.0 done
    [BOM-Controller_Unit_V1.0 (sendable).csv, BOM-Controller_Unit_V1.0.csv, BOM-Level_shifter_FPGA_V1.0.csv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]
2026-03-29 Started the huge chungus wide combined cpu
    [ALU_V2.0.kicad_pcb, BOM-Controller_Unit_V1.0 (sendable).csv, BOM-Controller_Unit_V1.0.csv, Register_Holder_V2.0.kicad_pcb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]
2026-03-29 almost done
    [BOM-Controller_Unit_V1.0 (sendable).csv, BOM-Controller_Unit_V1.0.csv, BOM-Whole_CPU_V1.0.csv, BOM_TEST.csv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]
2026-03-30 order tomorrow
    [BOM-Level_shifter_FPGA_V1.0.csv, BOM-Whole_CPU_V1.0.csv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]
2026-03-31 Finaly sent the last pcbs
    [BOM_Send_File_Whole_CPU_V1.0.csv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]
2026-05-04 fix 16 = 16 - 16
    [SIMPLIFY_C.py, Simple_C_output.c, assembler_V1_0.py, snake_ver3_5.c]
